UAlberta-EcoCar/ARCHIVED-Fuel-Cell-Controller-2016-2017/README.md

# Fuel-Cell-Controller
Custom controller for a 28 cell Ballard Fuel Cell
