UAlberta-EcoCar/ARCHIVED-Fuel-Cell-Controller-2016-2017/Hardware/Relay Board/Relay Board Parts List Rev2.xlsx

ECOCAR 2016-17 Relay Board Parts List
Part Description | Digikey Number | Size | Quantity
Shunt Resistors | Y1488-.002BTR-ND | N/A | 4
Diode | APT60S20BG-ND | N/A | 1
Connectors | 732-3204-ND | M8 | 8
Current Meter | 296-17936-1-ND | N/A | 2
Resistor - 750 | 311-750ARCT-ND | 805 | 2
Resistor - 9.53K | 311-9.53KCRCT-ND | 805 | 2
Resistor - 470 | 311-470ARCT-ND | 805 | 2
Resistor - 14K | 311-14.0KCRCT-ND | 805 | 1
Resistor - 150K | 311-150KARCT-ND | 805 | 1
Resistor - 100K | 311-100KARCT-ND | 805 | 1
Resistor - 200K | 311-200KARCT-ND | 805 | 1
Resistor - 300K | 311-300KARCT-ND | 805 | 1
Resistor - 10K | 311-10KARCT-ND | 805 | 4
Capacitor - 1microFarad | 311-1365-1-ND | 805 | 2
Op-Amp | 296-21651-2-ND | N/A | 1
RJ-11 Connector | A107789-ND | N/A | 1
Ethernet Connector | A122645-ND | N/A | 2
Relay Socket | PB232-ND | N/A | 4
Diode | F5816CT-ND | N/A | 4
MOSFET | SI6926ADQ-T1-E3CT-ND | N/A | 2
Relay | CLA394-ND | N/A | 1
Relay (70Amp for Alice) | 255-2082-ND | N/A | 4
Relay (40Amp for Proto) | 255-1825-ND | N/A | 4
