UAlberta-EcoCar/ARCHIVED-Fuel-Cell-Controller-2016-2017/Hardware/Hydrogen Board/CE553027-LC.pdf

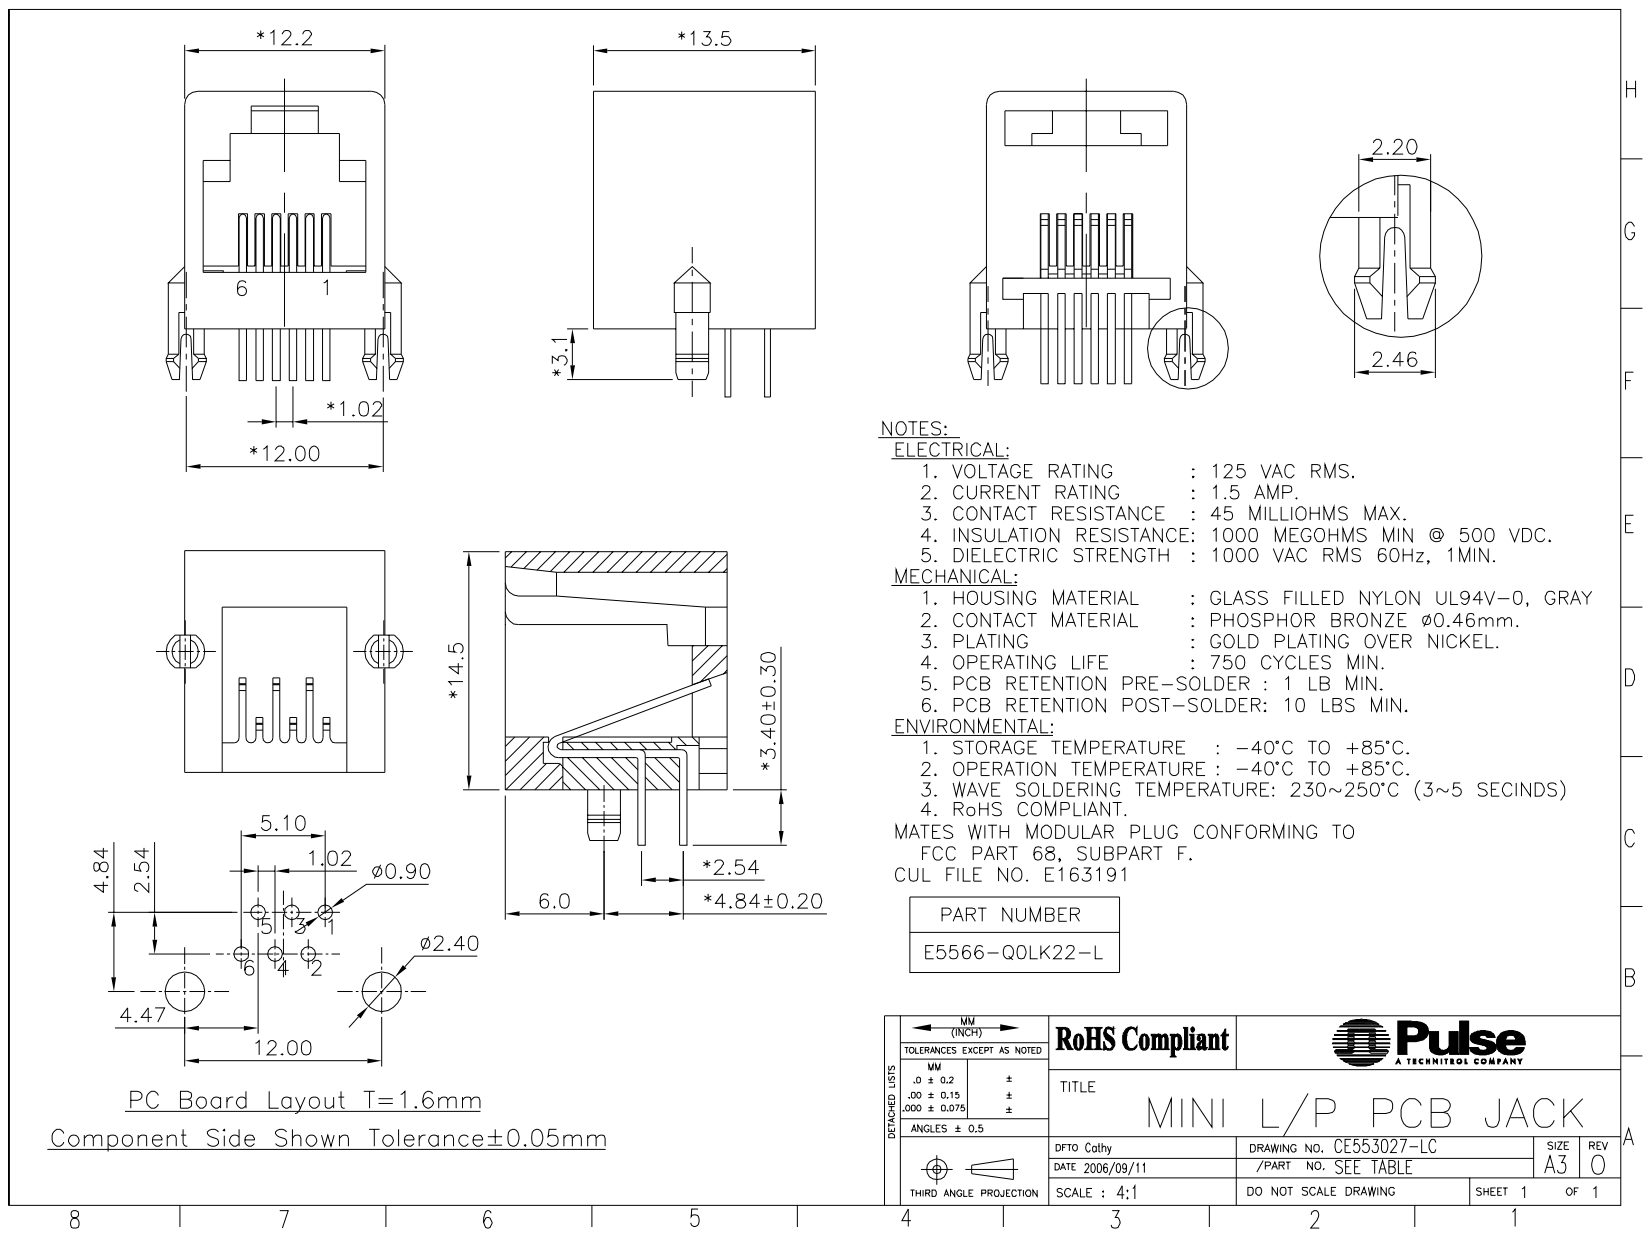
[picture p2: page 1]
