UAlberta-EcoCar/ARCHIVED-Fuel-Cell-Controller-2016-2017/Hardware/FCC Power Board/fc power board v3.brd

## EAGLE design Hardware/FCC Power Board/fc power board v3.brd (2018-02-10)

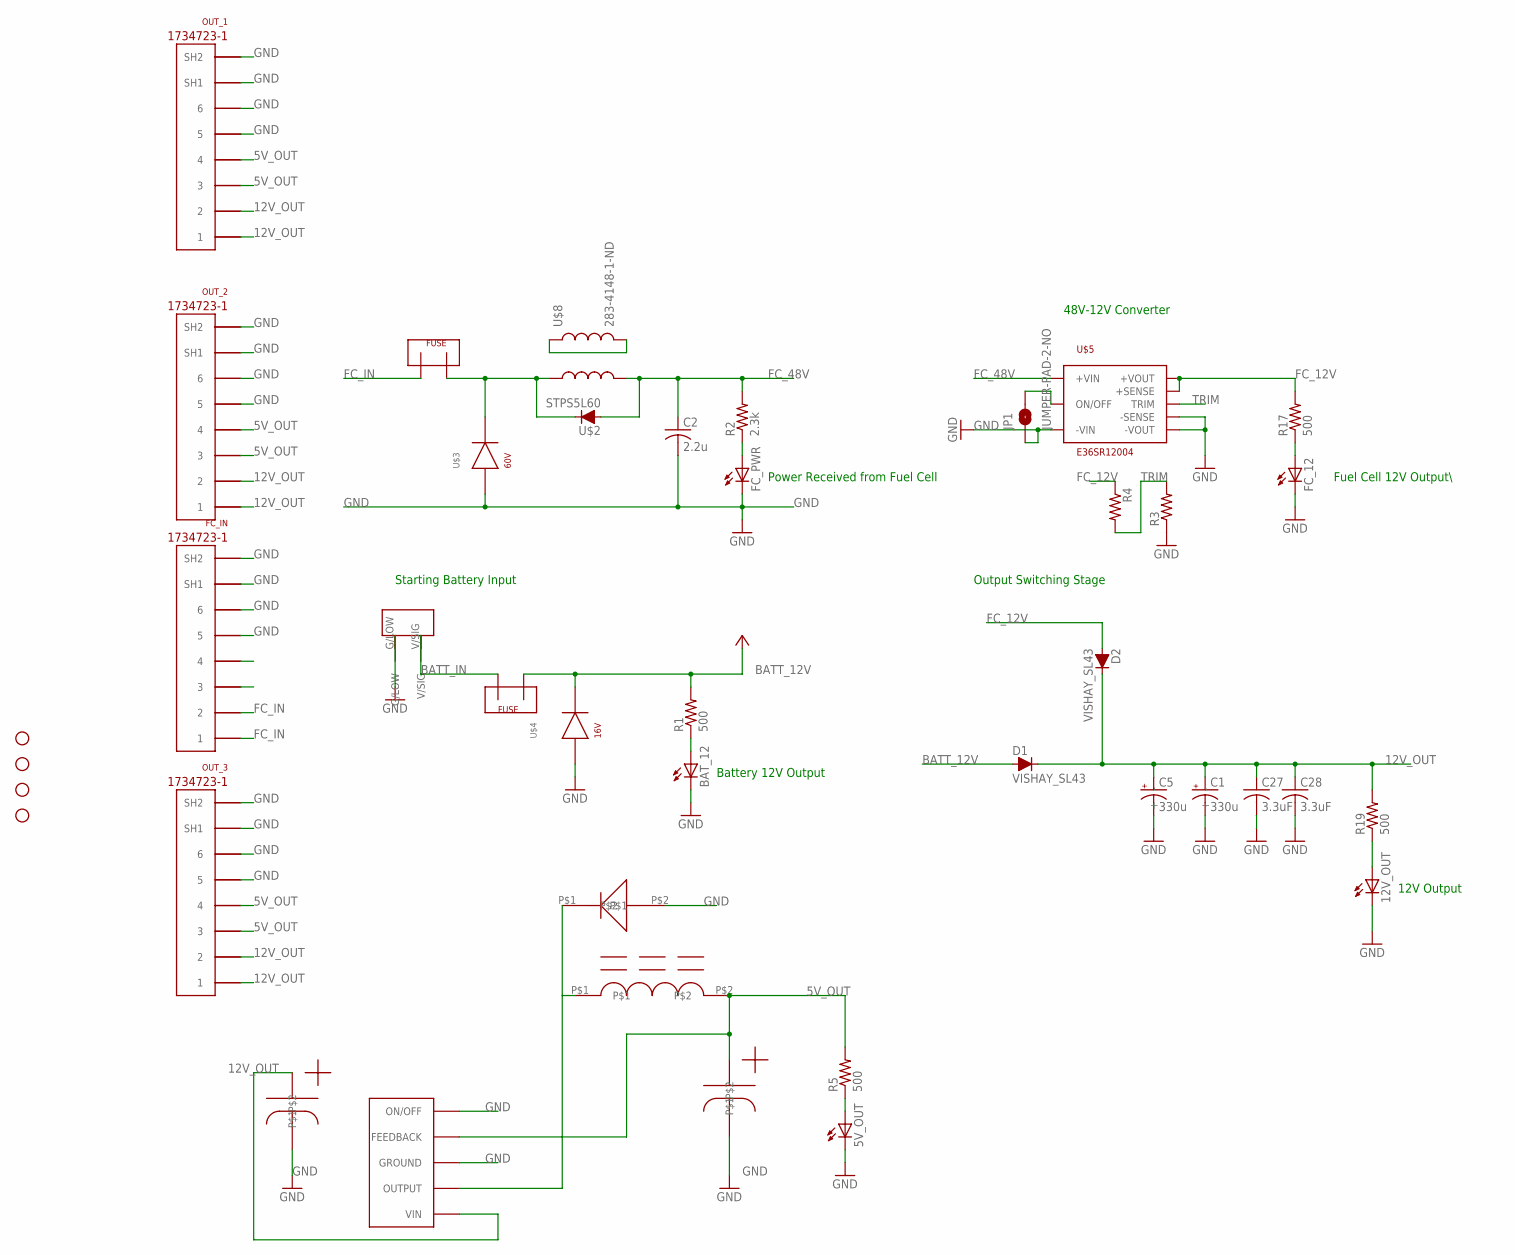
[picture p3: schematic fc power board v3.sch]

Parts:
5V_OUT, 12V_OUT: LED1206; LED-1206
BATTERY_FUSE: FUSEMINI-BLADE; MINI-BLADE-FUSE
BAT_12: LED1206; LED-1206
C1, C5: 330u; 399-6608-ND
C2: 2.2u; C0805
C27, C28: 3.3uF; C0805
D1, D2: VISHAY_SL43; DO-214AB_SMC
FC_12: LED1206; LED-1206
FC_IN: 5555140-6; 1734723-1_RJ11
FC_PWR: LED1206; LED-1206
JP1: JUMPER-PAD-2-NO; PAD-JUMPER-2-NO_NO_SILK
OUT_1, OUT_2, OUT_3: 5555140-6; 1734723-1_RJ11
R1, R5, R17: 500; R0805
R2: 2.3k; R0805
R3, R4: R-US_R0805; R0805
R19: 500; M0805
STANDOFF1, STANDOFF2, STANDOFF3, STANDOFF4: STAND-OFF
U$1: MBR360GOS
U$2: STPS5L60; STM_SMC
U$3: SMBJ60CA; .277X.089
U$4: SMAJ16CA; .25X.07
U$5: E36SR12004; 2.30X0.90X0.34
U$7: FUSEMINI-BLADE; MINI-BLADE-FUSE
U$8: 283-4148-1-ND
U$9: 2_PIN_TECONNECTOR; 2_PIN_CONNECT
U$13: LM2576; D2PAK-5
U$14: CAPESK107M025AC3AA; ESK107M025AC3AA
U$15: CAPESK108M025AH4EA; ESK108M025AH4EA
U$16: M1418-ND

Connections:
5V_OUT: OUT_1.3, OUT_1.4, OUT_2.3, OUT_2.4, OUT_3.3, OUT_3.4, R5.2, U$13.4 (FEEDBACK), U$15.P$1, U$16.P$2
12V_OUT: C1.PLUS (+), C5.PLUS (+), C27.1, C28.1, D1.C, D2.C, OUT_1.1, OUT_1.2, OUT_2.1, OUT_2.2, OUT_3.1, OUT_3.2, R19.2, U$13.1 (VIN), U$14.P$1
BATT_12V: BATTERY_FUSE.OUT, D1.A, R1.2, U$4.CATHODE
BATT_IN: BATTERY_FUSE.IN, U$9.V/SIG
FC_12V: D2.A, R4.1, R17.2, U$5.P$7 (+SENSE), U$5.P$8 (+VOUT)
FC_48V: C2.1, R2.2, U$2.A, U$5.P$1 (+VIN), U$8.P$3 (2)
FC_FUSED: U$2.C, U$3.CATHODE, U$7.IN, U$8.P$1 (1)
FC_IN: FC_IN.1, FC_IN.2, U$7.OUT
GND: 5V_OUT.C, 12V_OUT.C, BAT_12.C, C1.MINUS (-), C2.2, C5.MINUS (-), C27.2, C28.2, FC_12.C, FC_IN.5, FC_IN.6, FC_IN.SH1, FC_IN.SH2, FC_PWR.C, JP1.1, OUT_1.5, OUT_1.6, OUT_1.SH1, OUT_1.SH2, OUT_2.5, OUT_2.6, OUT_2.SH1, OUT_2.SH2, OUT_3.5, OUT_3.6, OUT_3.SH1, OUT_3.SH2, R3.1, U$1.P$2, U$3.ANODE, U$4.ANODE, U$5.P$3 (-VIN), U$5.P$4 (-VOUT), U$5.P$5 (-SENSE), U$9.G/LOW, U$13.3 (GROUND), U$13.5 (ON/OFF), U$13.GROUND, U$14.P$2, U$15.P$2
unnamed: JP1.2, U$5.P$2 (ON/OFF)
unnamed: BAT_12.A, R1.1
unnamed: FC_PWR.A, R2.1
unnamed: U$8.P$2 (3), U$8.P$4 (4)
unnamed: 5V_OUT.A, R5.1
unnamed: U$1.P$1, U$13.2 (OUTPUT), U$16.P$1
unnamed: FC_12.A, R17.1
unnamed: 12V_OUT.A, R19.1
TRIM: R3.2, R4.2, U$5.P$6 (TRIM)

Notes on the sheet:
Output Switching Stage
Starting Battery Input
48V-12V Converter
Power Received from Fuel Cell
Battery 12V Output
Fuel Cell 12V Output\
12V Output

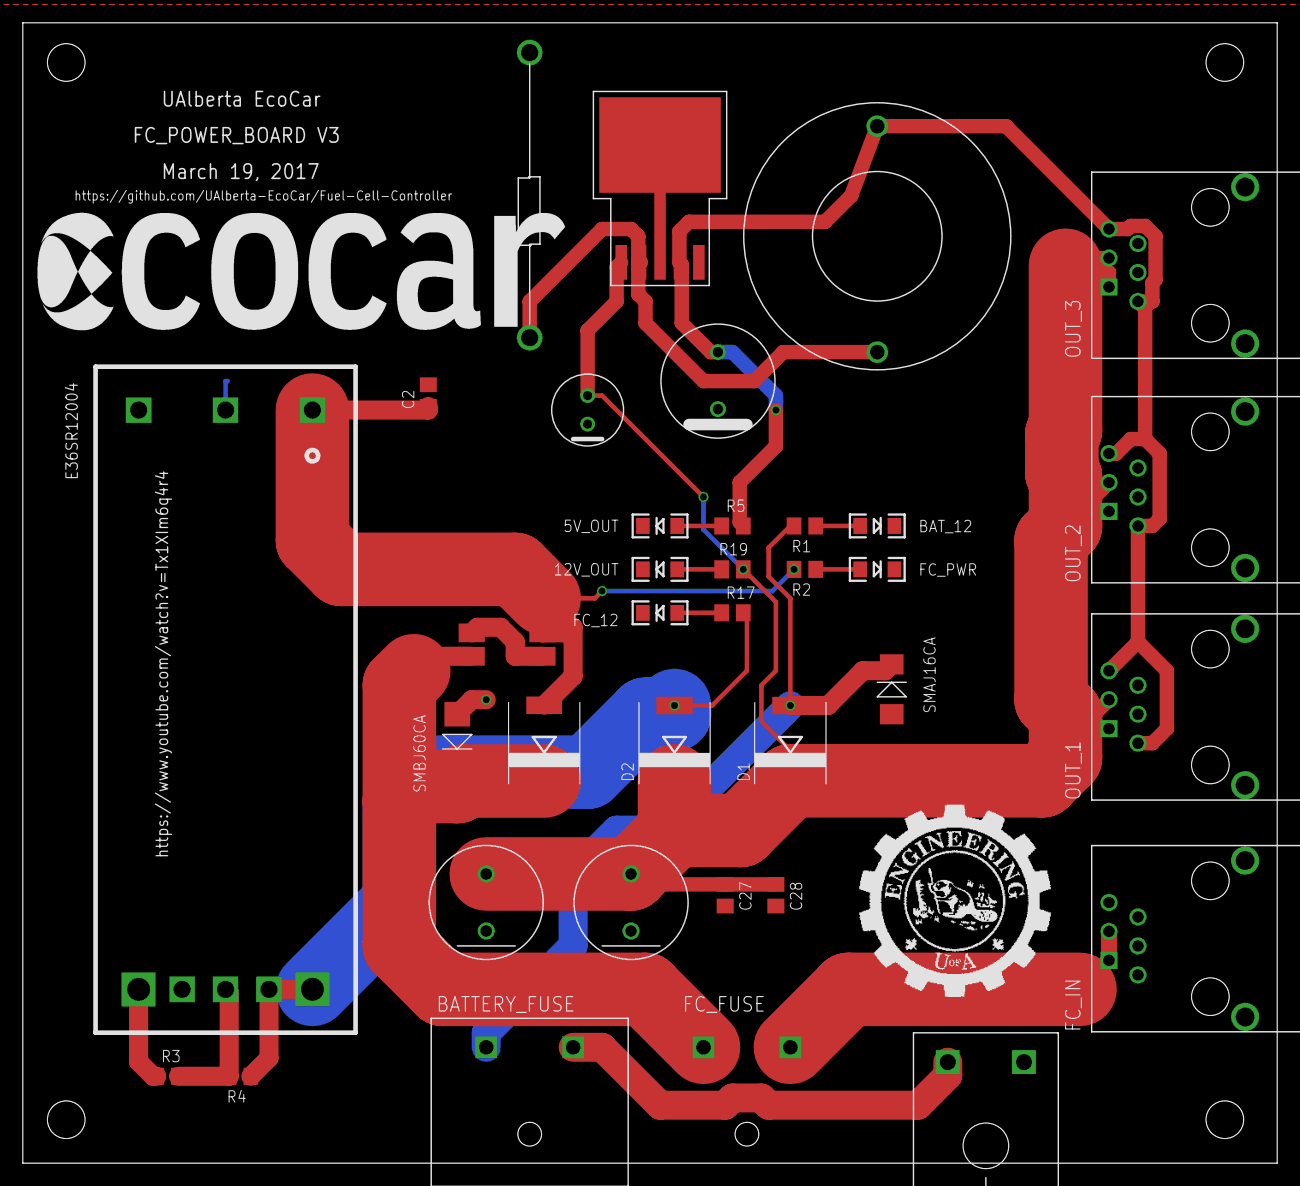
[picture p4: board fc power board v3.brd from above]

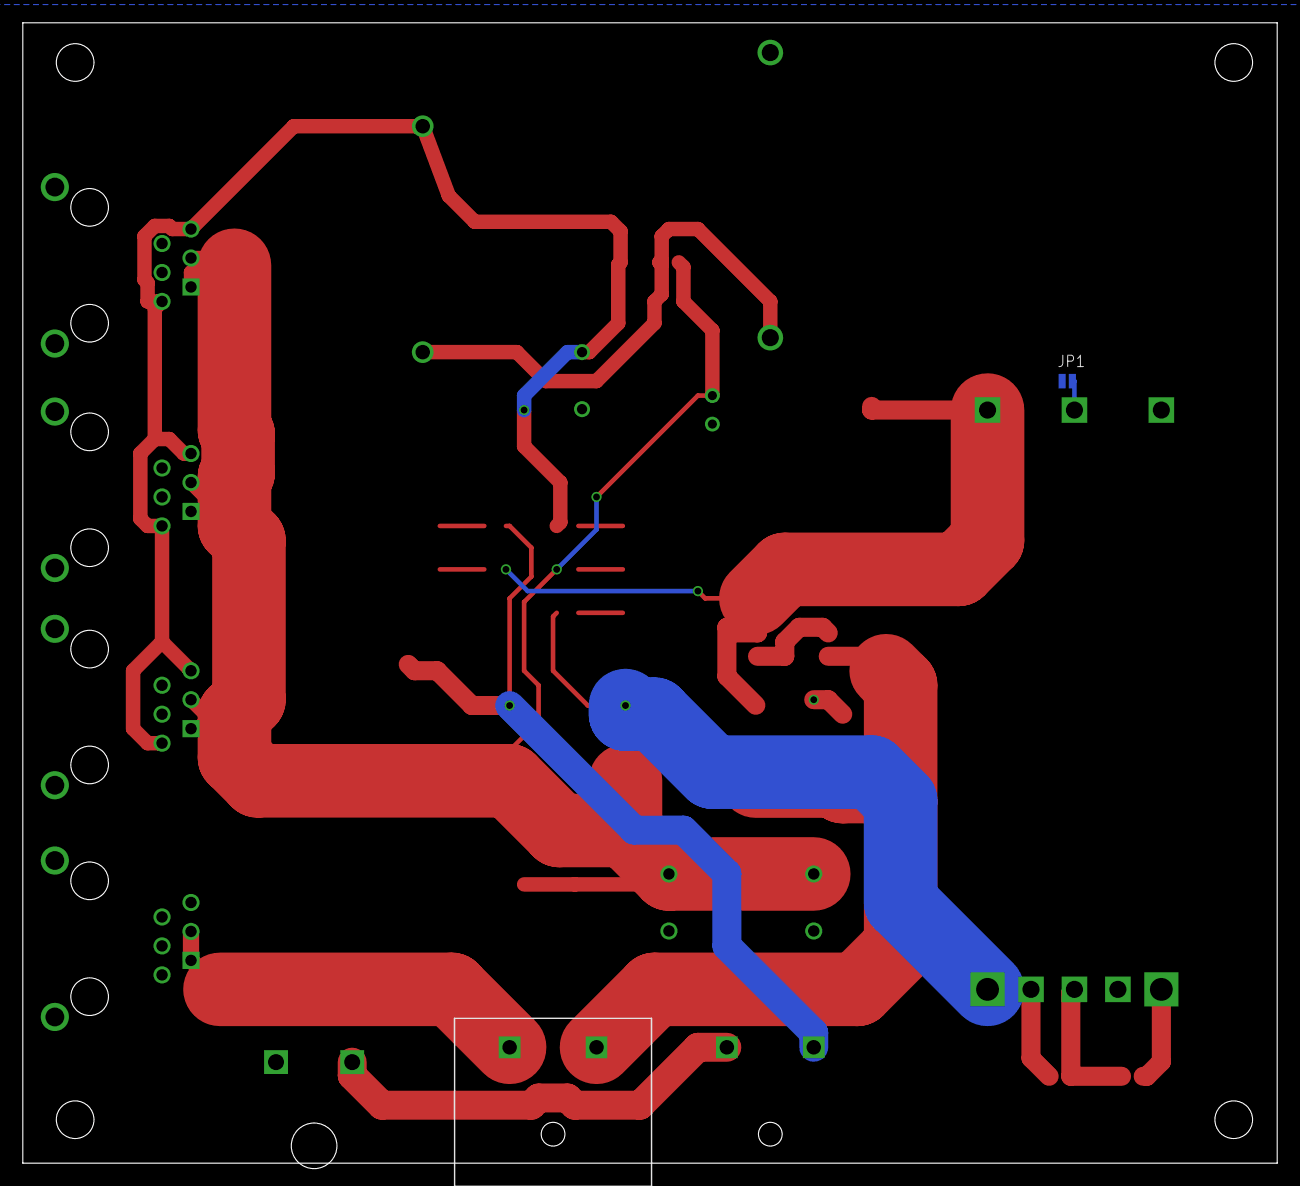
[picture p5: board fc power board v3.brd from below]

Board: 2 copper layers, 110.0 x 100.0 mm, 42 parts (2 on the bottom side), 18 nets.

Other parts of the board:
U$6: ECOCAR_LOGO_2018
