UAlberta-EcoCar/ARCHIVED-Fuel-Cell-Controller-2016-2017/Hardware/Hydrogen Board/hydrogen_sensors_board_v2.brd

## EAGLE design Hardware/Hydrogen Board/hydrogen_sensors_board_v2.brd (2017-10-08)

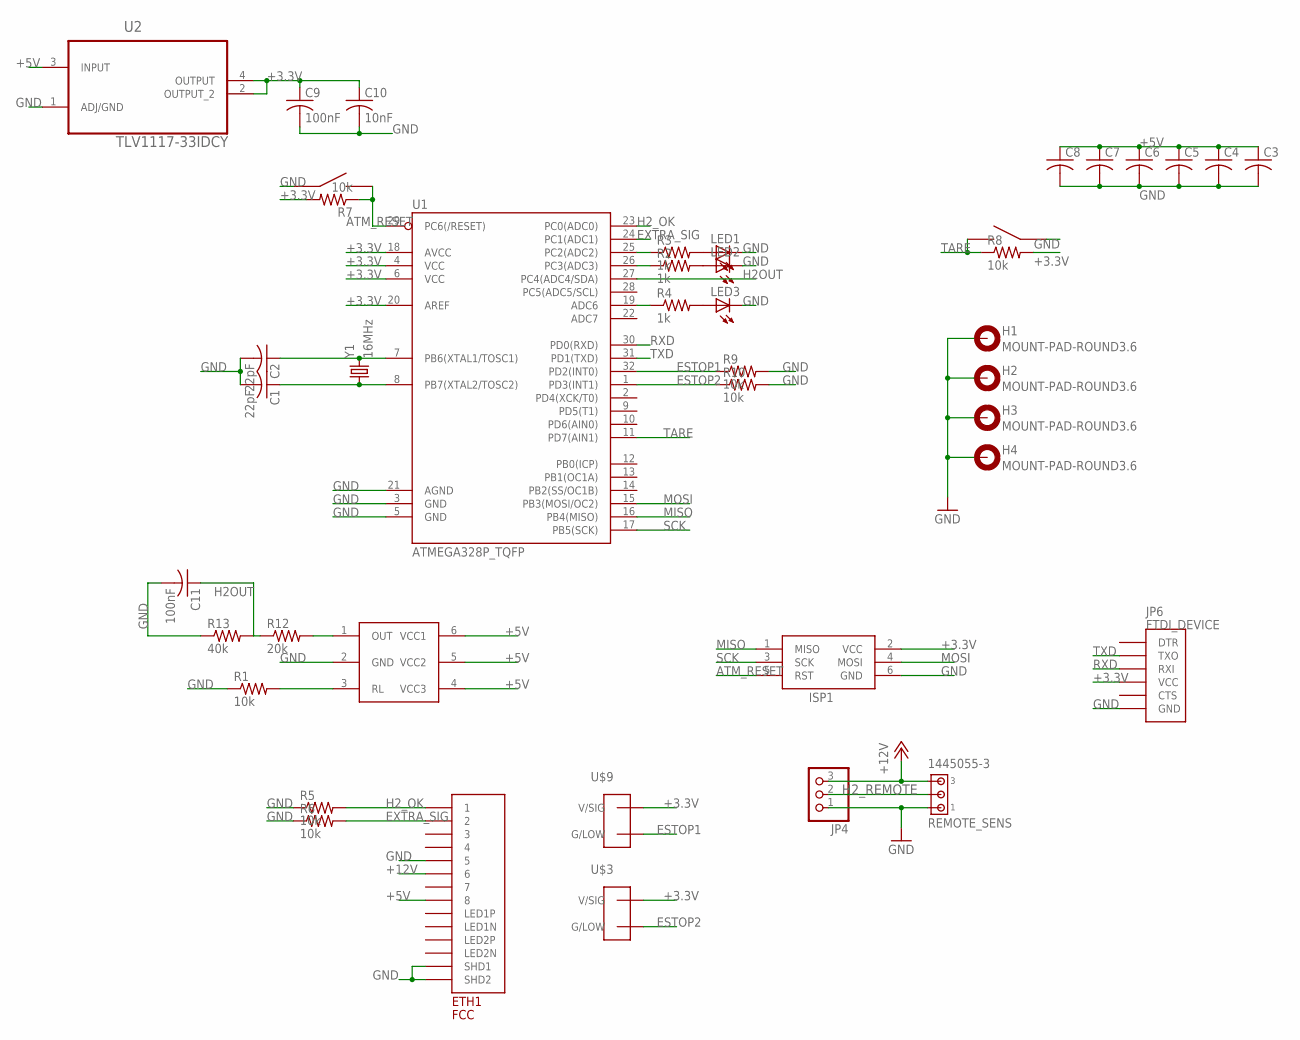
[picture p6: schematic hydrogen_sensors_board_v2.sch]

Parts:
C1, C2: 22pF; C0603K
C3, C4, C5, C6, C7, C8: C-USC0603; C0603
C9, C11: 100nF; C0603
C10: 10nF; C0603
ETH1: FCC; A122645-ND
H1, H2, H3, H4: MOUNT-PAD-ROUND3.6; 3,6-PAD
ISP1: AVRISP-BOX
JP4: PINHD-1X3; 1X03
JP6: FTDI_DEVICE; FTDI_DEVICE_SIDE
LED1, LED2, LED3: LEDCHIPLED_0805; CHIPLED_0805
R1, R5, R6, R7, R8, R9, R10: 10k; 0603-RES
R2, R3, R4: 1k; 0603-RES
R12: 20k; 0603-RES
R13: 40k; 0603-RES
REMOTE_SENS: 1445055-3
U1: ATMEGA328P_TQFP; TQFP32-08
U2: TLV1117-33IDCY; SOT230P700X180-4N
U$1: MQ-8MQ-8; MQ-8
U$2, U$10: EG4621CT-ND
U$3, U$9: TE770966; 2X1-MATE-N-LOCK
Y1: 16MHz; HC49US

Connections:
+3.3V: C9.1, C10.1, ISP1.2 (VCC), JP6.P$4 (VCC), R7.2, R8.2, U1.4 (VCC), U1.6 (VCC), U1.18 (AVCC), U1.20 (AREF), U2.2 (OUTPUT_2), U2.4 (OUTPUT), U$3.CIRCUIT1 (V/SIG), U$9.CIRCUIT1 (V/SIG)
+5V: C3.1, C4.1, C5.1, C6.1, C7.1, C8.1, ETH1.P$8 (8), U2.3 (INPUT), U$1.4 (VCC3), U$1.5 (VCC2), U$1.6 (VCC1)
+12V: ETH1.P$6 (6), JP4.3, REMOTE_SENS.3
ATM_RESET: ISP1.5 (RST), R7.1, U1.29 (PC6(/RESET)), U$10.P$3, U$10.P$4
ESTOP1: R9.1, U1.32 (PD2(INT0)), U$9.CIRCUIT2 (G/LOW)
ESTOP2: R10.1, U1.1 (PD3(INT1)), U$3.CIRCUIT2 (G/LOW)
EXTRA_SIG: ETH1.P$2 (2), R6.2, U1.24 (PC1(ADC1))
GND: C1.2, C2.2, C3.2, C4.2, C5.2, C6.2, C7.2, C8.2, C9.2, C10.2, C11.2, ETH1.P$5 (5), ETH1.P$13 (SHD1), ETH1.P$14 (SHD2), H1.B3,6, H2.B3,6, H3.B3,6, H4.B3,6, ISP1.6 (GND), JP4.1, JP6.P$6 (GND), LED1.C, LED2.C, LED3.C, R1.1, R5.1, R6.1, R9.2, R10.2, R13.1, REMOTE_SENS.1, U1.3 (GND), U1.5 (GND), U1.21 (AGND), U2.1 (ADJ/GND), U$1.2 (GND), U$2.P$1, U$2.P$2, U$10.P$1, U$10.P$2
H2OUT: C11.1, R12.1, R13.2, U1.27 (PC4(ADC4/SDA))
H2_OK: ETH1.P$1 (1), R5.2, U1.23 (PC0(ADC0))
H2_REMOTE: JP4.2, REMOTE_SENS.2
MISO: ISP1.1 (MISO), U1.16 (PB4(MISO))
MOSI: ISP1.4 (MOSI), U1.15 (PB3(MOSI/OC2))
unnamed: C2.1, U1.7 (PB6(XTAL1/TOSC1)), Y1.2
unnamed: R1.2, U$1.3 (RL)
unnamed: C1.1, U1.8 (PB7(XTAL2/TOSC2)), Y1.1
unnamed: R3.1, U1.25 (PC2(ADC2))
unnamed: R2.1, U1.26 (PC3(ADC3))
unnamed: R4.1, U1.19 (ADC6)
unnamed: LED1.A, R3.2
unnamed: LED2.A, R2.2
unnamed: LED3.A, R4.2
unnamed: R12.2, U$1.1 (OUT)
RXD: JP6.P$3 (RXI), U1.30 (PD0(RXD))
SCK: ISP1.3 (SCK), U1.17 (PB5(SCK))
TARE: R8.1, U1.11 (PD7(AIN1)), U$2.P$3, U$2.P$4
TXD: JP6.P$2 (TXO), U1.31 (PD1(TXD))

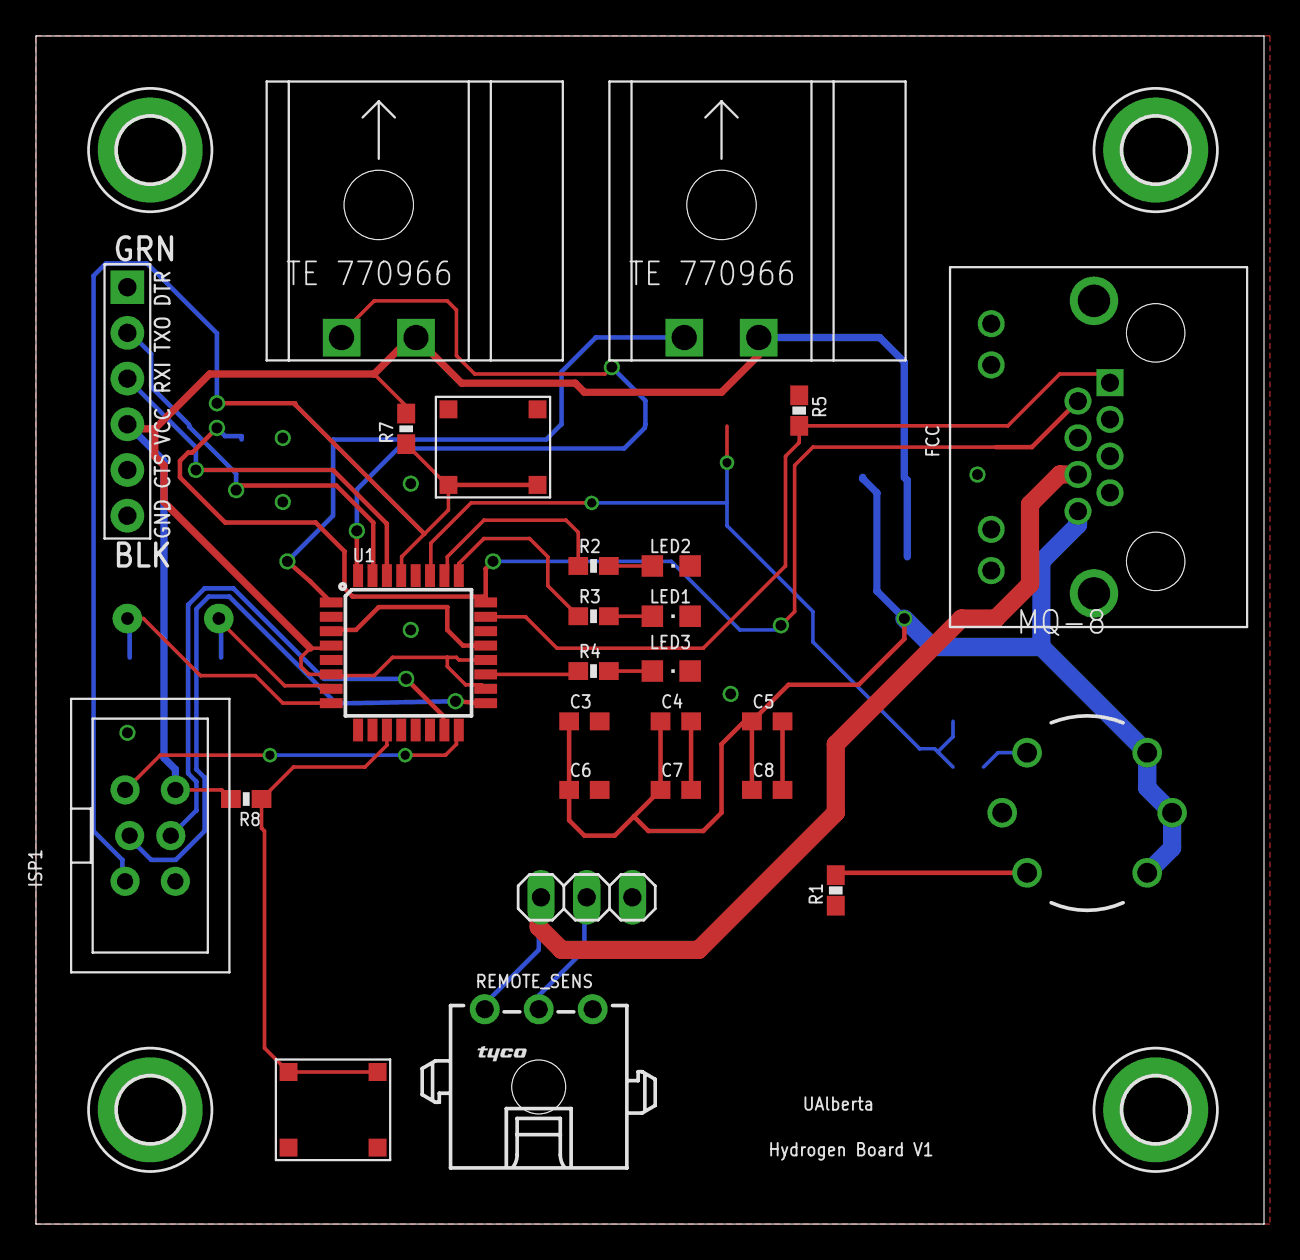
[picture p7: board hydrogen_sensors_board_v2.brd from above]

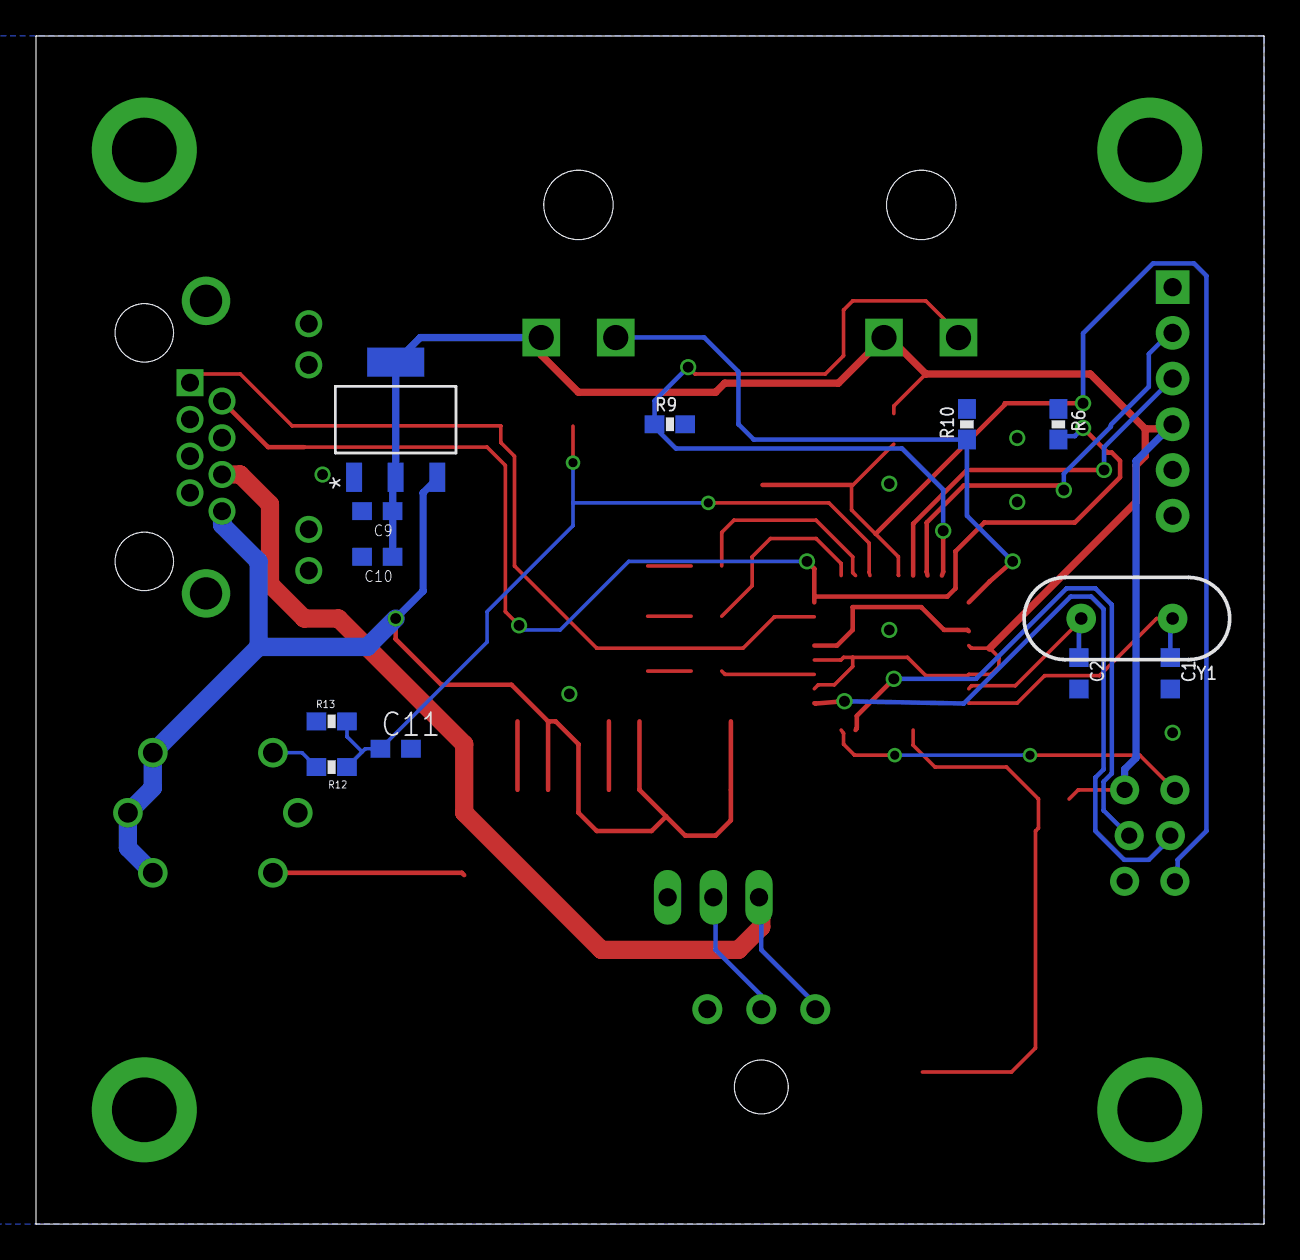
[picture p8: board hydrogen_sensors_board_v2.brd from below]

Board: 2 copper layers, 68.2 x 66.0 mm, 43 parts (12 on the bottom side), 27 nets.
