UAlberta-EcoCar/ARCHIVED-Fuel-Cell-Controller-2016-2017/Hardware/Mosfet Board/mosfet board_v2.brd

## EAGLE design Hardware/Mosfet Board/mosfet board_v2.brd (2017-05-19)

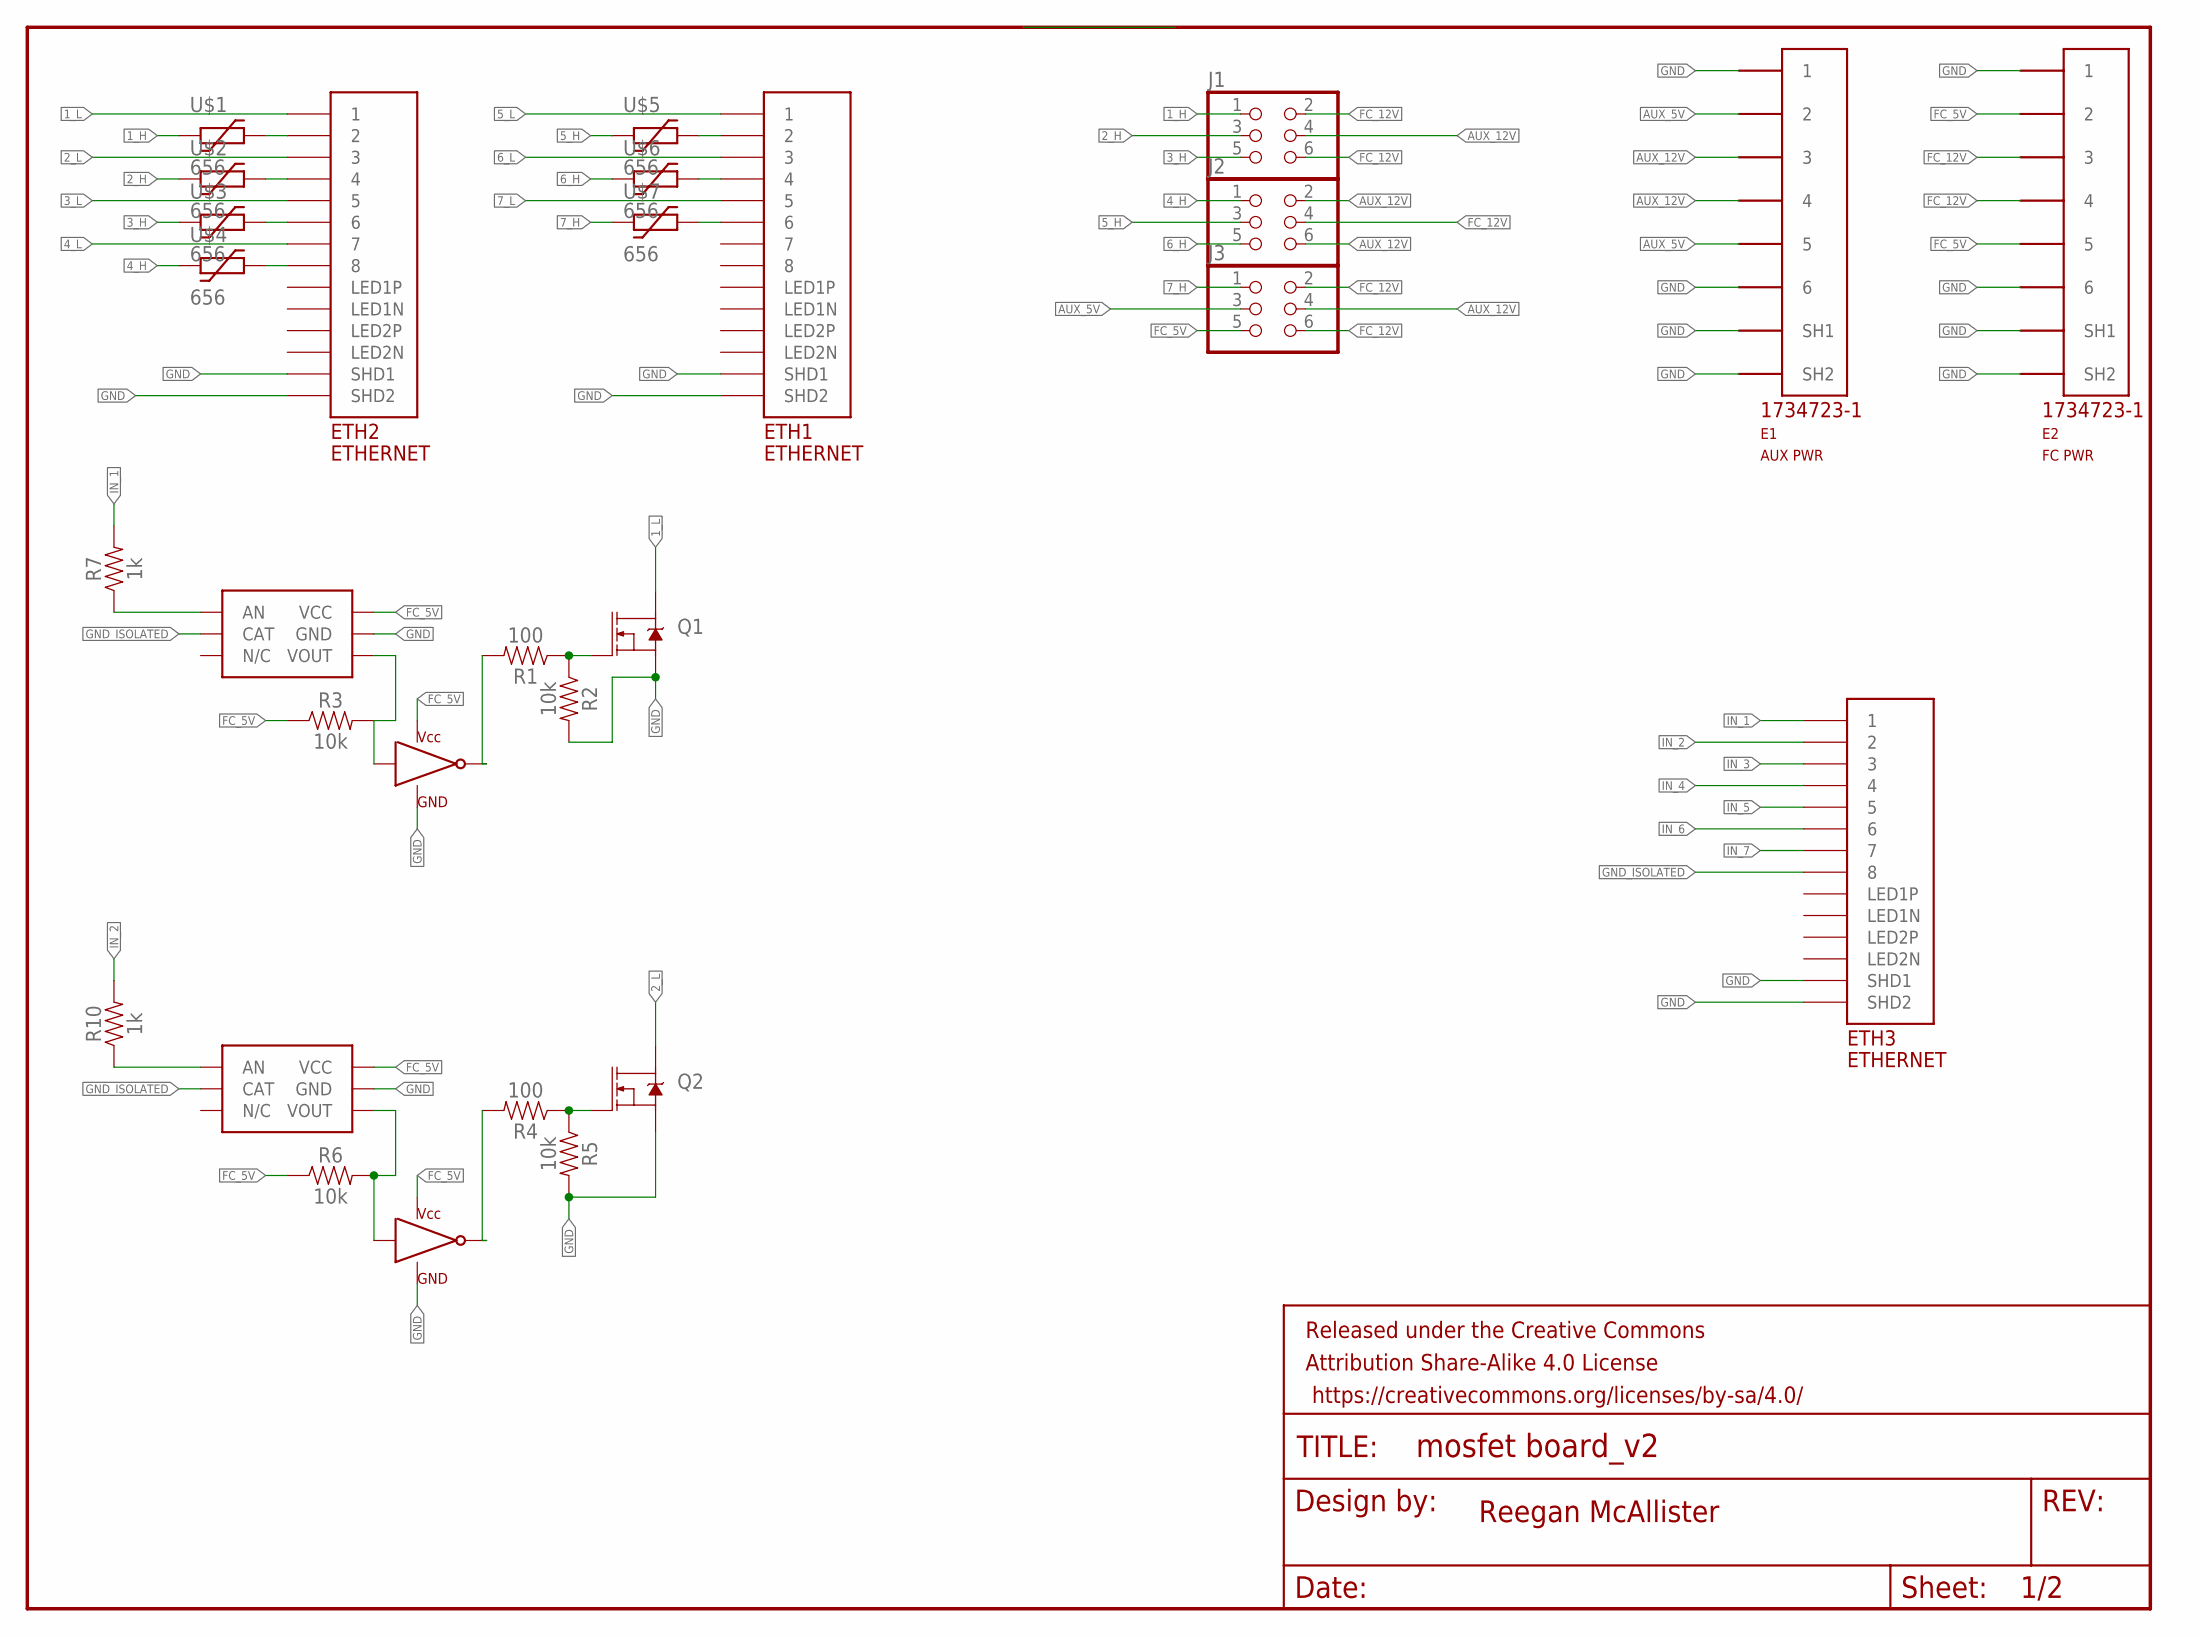
[picture p9: schematic mosfet board_v2.sch, sheet 1]

Parts:
E1: AUX PWR; 1734723-1_RJ11
E2: FC PWR; 1734723-1_RJ11
ETH1, ETH2, ETH3: ETHERNET; A122645-ND
FRAME1: FRAME-LETTERNO_PACKAGE; DUMMY
J1, J2, J3: PINHD-2X3; 2X03
Q1, Q2: MOSFET-NCH-AO3404A; SOT23-3
R1, R4: 100; 0805
R2, R3, R5, R6: 10k; 0805
R7, R10: 1k; 0805
U$1, U$2, U$3, U$4, U$5, U$6, U$7: 656
U$8, U$10: H11L1M
U$9, U$11: SN74LVC1G04-Q1; SOT-23-5

Connections:
1_H: J1.1, U$1.P$1 (1)
1_L: ETH2.P$1 (1), Q1.3 (D)
2_H: J1.3, U$2.P$1 (1)
2_L: ETH2.P$3 (3), Q2.3 (D)
3_H: J1.5, U$3.P$1 (1)
3_L: ETH2.P$5 (5); also elsewhere on the board
4_H: J2.1, U$4.P$1 (1)
4_L: ETH2.P$7 (7); also elsewhere on the board
5_H: J2.3, U$5.P$1 (1)
5_L: ETH1.P$1 (1); also elsewhere on the board
6_H: J2.5, U$6.P$1 (1)
6_L: ETH1.P$3 (3); also elsewhere on the board
7_H: J3.1, U$7.P$1 (1)
7_L: ETH1.P$5 (5); also elsewhere on the board
AUX_5V: E1.2, E1.5, J3.3
AUX_12V: E1.3, E1.4, J1.4, J2.2, J2.6, J3.4
FC_5V: E2.2, E2.5, J3.5, R3.1, R6.1, U$8.P$6 (VCC), U$9.P$5 (VCC), U$10.P$6 (VCC), U$11.P$5 (VCC); also elsewhere on the board
FC_12V: E2.3, E2.4, J1.2, J1.6, J2.4, J3.2, J3.6
GND: E1.1, E1.6, E1.SH1, E1.SH2, E2.1, E2.6, E2.SH1, E2.SH2, ETH1.P$13 (SHD1), ETH1.P$14 (SHD2), ETH2.P$13 (SHD1), ETH2.P$14 (SHD2), ETH3.P$13 (SHD1), ETH3.P$14 (SHD2), Q1.2 (S), Q2.2 (S), R2.2, R5.2, U$8.P$5 (GND), U$9.P$1 (GND), U$9.P$3 (GND), U$10.P$5 (GND), U$11.P$1 (GND), U$11.P$3 (GND); also elsewhere on the board
GND_ISOLATED: ETH3.P$8 (8), U$8.P$2 (CAT), U$10.P$2 (CAT); also elsewhere on the board
IN_1: ETH3.P$1 (1), R7.2
IN_2: ETH3.P$2 (2), R10.2
IN_3: ETH3.P$3 (3); also elsewhere on the board
IN_4: ETH3.P$4 (4); also elsewhere on the board
IN_5: ETH3.P$5 (5); also elsewhere on the board
IN_6: ETH3.P$6 (6); also elsewhere on the board
IN_7: ETH3.P$7 (7); also elsewhere on the board
unnamed: ETH2.P$2 (2), U$1.P$2 (2)
unnamed: ETH2.P$4 (4), U$2.P$2 (2)
unnamed: ETH2.P$6 (6), U$3.P$2 (2)
unnamed: ETH2.P$8 (8), U$4.P$2 (2)
unnamed: ETH1.P$2 (2), U$5.P$2 (2)
unnamed: Q1.1 (G), R1.1, R2.1
unnamed: R3.2, U$8.P$4 (VOUT), U$9.P$2 (IN)
unnamed: R1.2, U$9.P$4 (OUT)
unnamed: ETH1.P$6 (6), U$7.P$2 (2)
unnamed: ETH1.P$4 (4), U$6.P$2 (2)
unnamed: Q2.1 (G), R4.1, R5.1
unnamed: R6.2, U$10.P$4 (VOUT), U$11.P$2 (IN)
unnamed: R4.2, U$11.P$4 (OUT)
unnamed: R10.1, U$10.P$1 (AN)
unnamed: R7.1, U$8.P$1 (AN)

Notes on the sheet:
Reegan McAllister

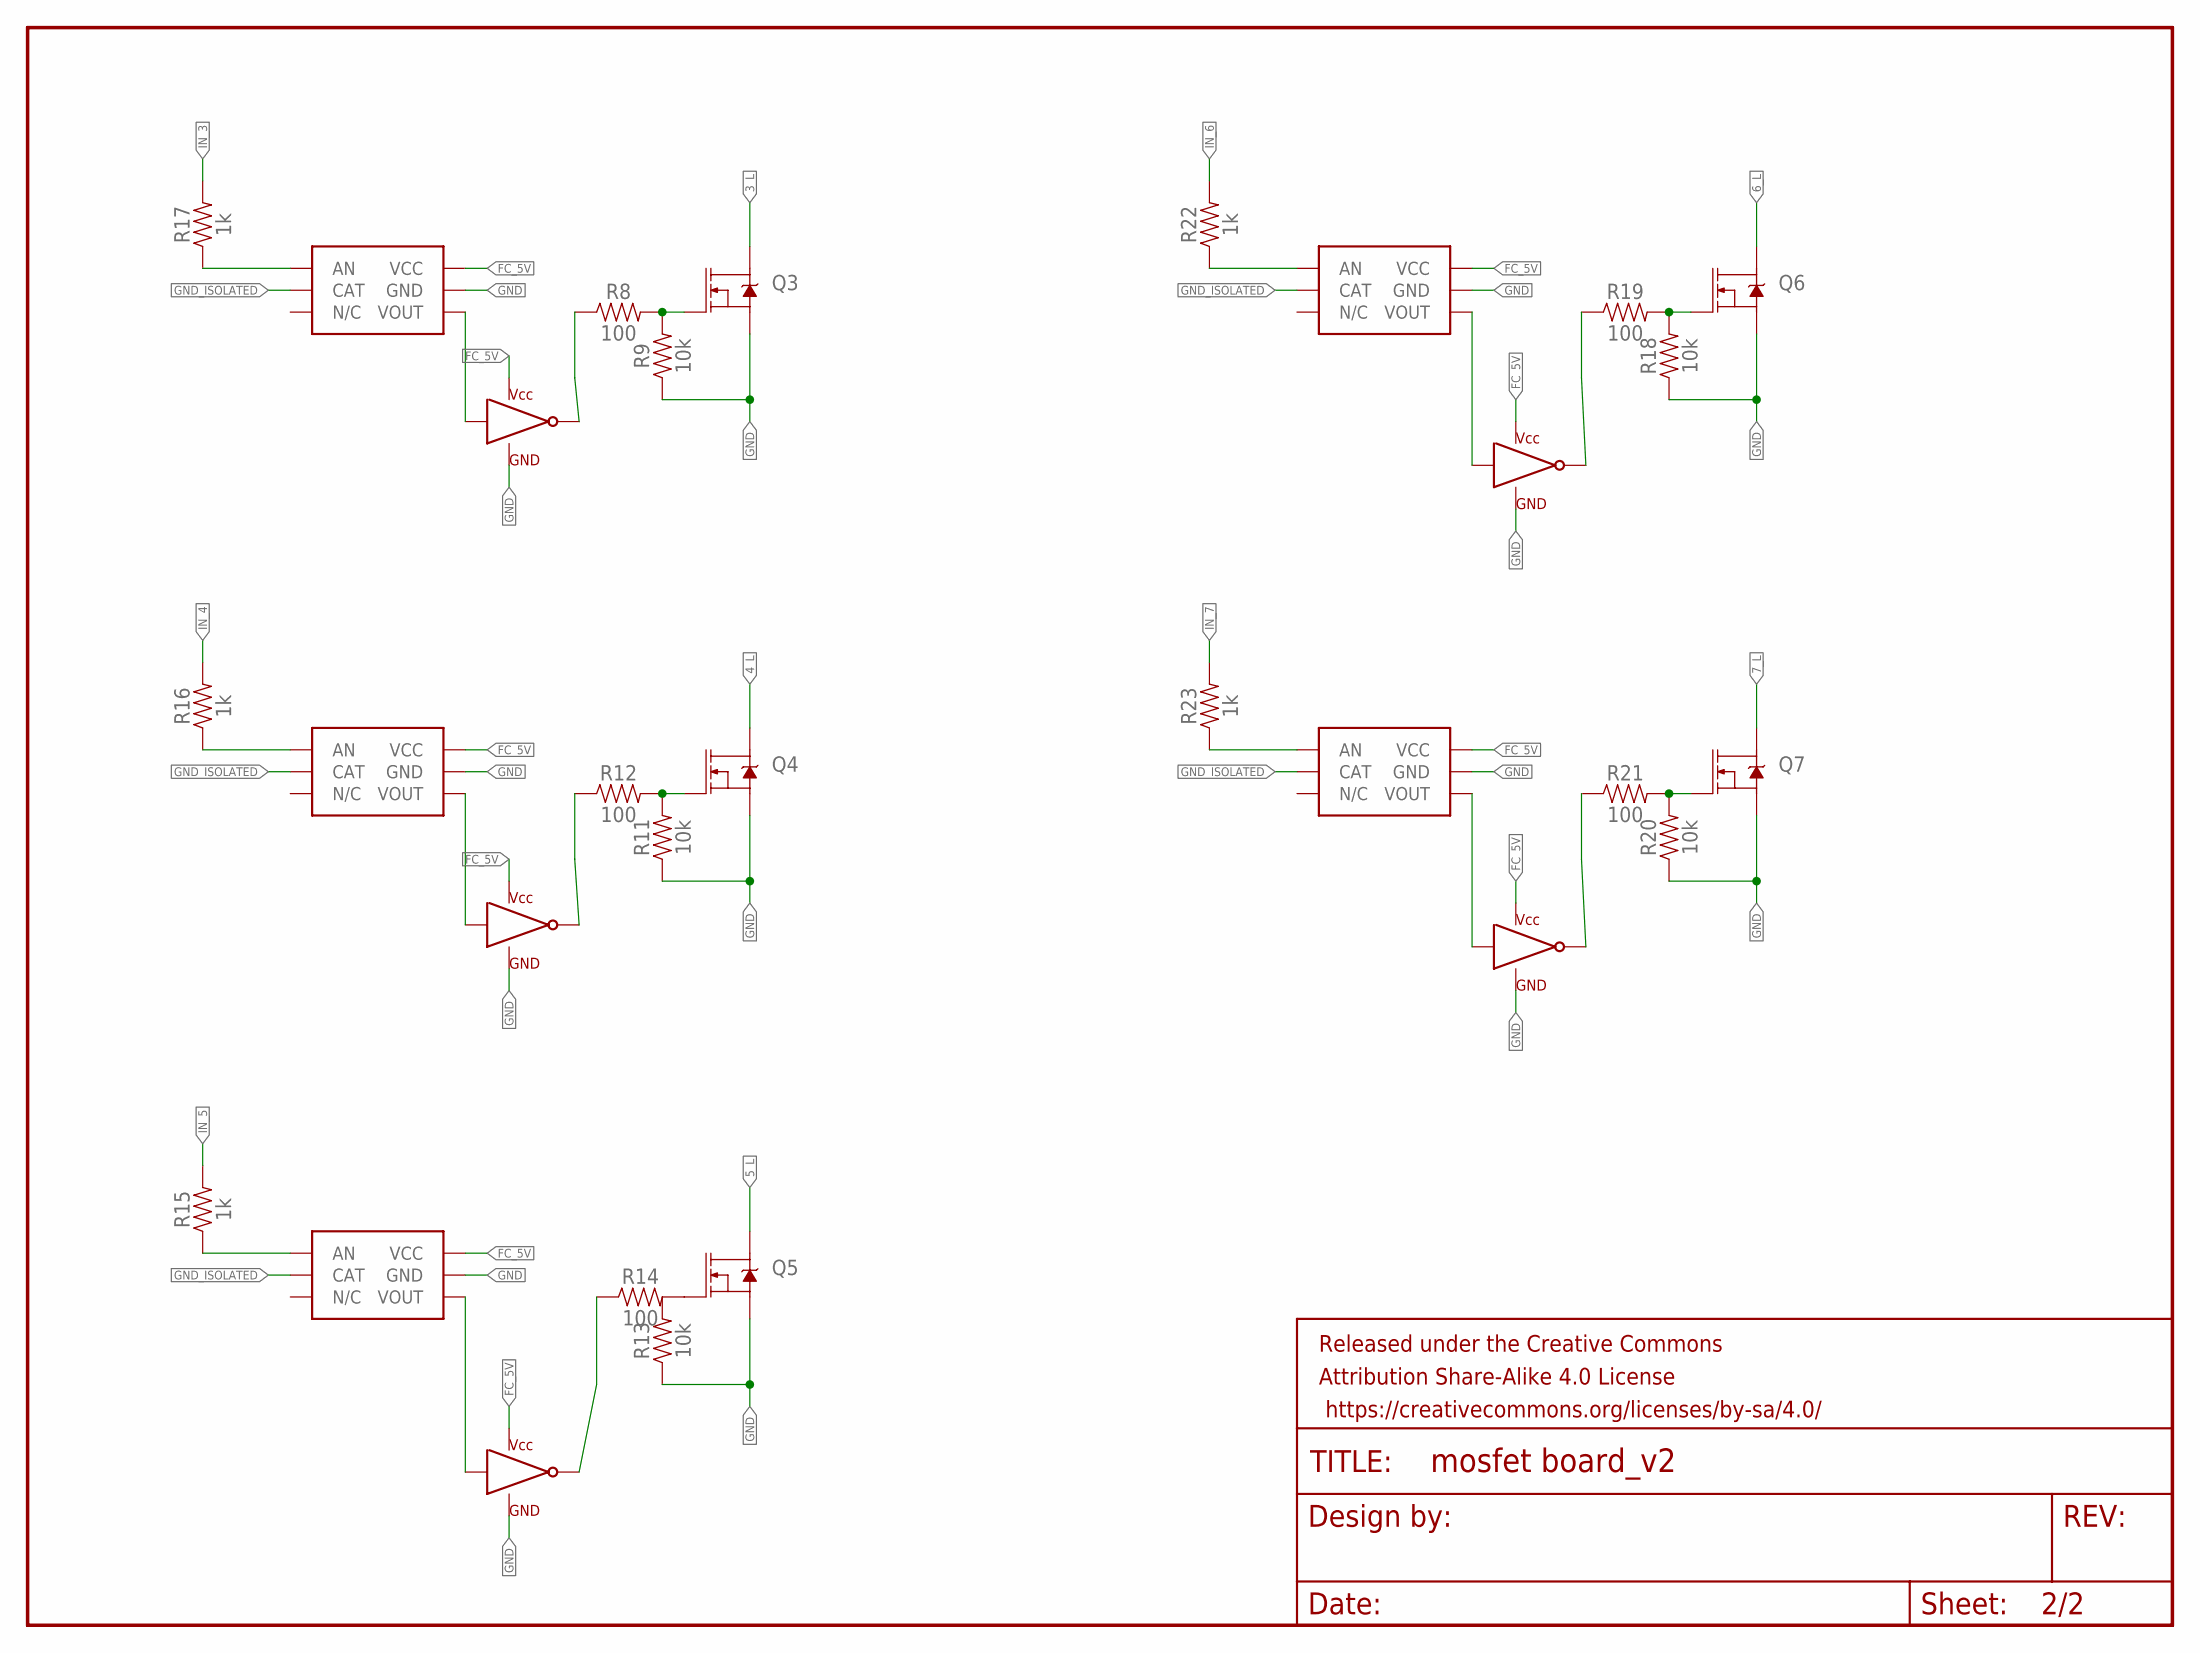
[picture p10: schematic mosfet board_v2.sch, sheet 2]

Parts:
FRAME2: FRAME-LETTERNO_PACKAGE; DUMMY
Q3, Q4, Q5, Q6, Q7: MOSFET-NCH-AO3404A; SOT23-3
R8, R12, R14, R19, R21: 100; 0805
R9, R11, R13, R18, R20: 10k; 0805
R15, R16, R17, R22, R23: 1k; 0805
U$12, U$14, U$16, U$18, U$20: H11L1M
U$13, U$15, U$17, U$19, U$21: SN74LVC1G04-Q1; SOT-23-5

Connections:
3_L: Q3.3 (D); also elsewhere on the board
4_L: Q4.3 (D); also elsewhere on the board
5_L: Q5.3 (D); also elsewhere on the board
6_L: Q6.3 (D); also elsewhere on the board
7_L: Q7.3 (D); also elsewhere on the board
FC_5V: U$12.P$6 (VCC), U$13.P$5 (VCC), U$14.P$6 (VCC), U$15.P$5 (VCC), U$16.P$6 (VCC), U$17.P$5 (VCC), U$18.P$6 (VCC), U$19.P$5 (VCC), U$20.P$6 (VCC), U$21.P$5 (VCC); also elsewhere on the board
GND: Q3.2 (S), Q4.2 (S), Q5.2 (S), Q6.2 (S), Q7.2 (S), R9.1, R11.1, R13.1, R18.1, R20.1, U$12.P$5 (GND), U$13.P$1 (GND), U$13.P$3 (GND), U$14.P$5 (GND), U$15.P$1 (GND), U$15.P$3 (GND), U$16.P$5 (GND), U$17.P$1 (GND), U$17.P$3 (GND), U$18.P$5 (GND), U$19.P$1 (GND), U$19.P$3 (GND), U$20.P$5 (GND), U$21.P$1 (GND), U$21.P$3 (GND); also elsewhere on the board
GND_ISOLATED: U$12.P$2 (CAT), U$14.P$2 (CAT), U$16.P$2 (CAT), U$18.P$2 (CAT), U$20.P$2 (CAT); also elsewhere on the board
IN_3: R17.2; also elsewhere on the board
IN_4: R16.2; also elsewhere on the board
IN_5: R15.2; also elsewhere on the board
IN_6: R22.2; also elsewhere on the board
IN_7: R23.2; also elsewhere on the board
unnamed: Q3.1 (G), R8.2, R9.2
unnamed: Q4.1 (G), R11.2, R12.2
unnamed: Q5.1 (G), R14.2
unnamed: Q6.1 (G), R18.2, R19.2
unnamed: Q7.1 (G), R20.2, R21.2
unnamed: R17.1, U$12.P$1 (AN)
unnamed: R16.1, U$14.P$1 (AN)
unnamed: R15.1, U$16.P$1 (AN)
unnamed: R22.1, U$18.P$1 (AN)
unnamed: R23.1, U$20.P$1 (AN)
unnamed: U$12.P$4 (VOUT), U$13.P$2 (IN)
unnamed: R8.1, U$13.P$4 (OUT)
unnamed: U$16.P$4 (VOUT), U$17.P$2 (IN)
unnamed: R14.1, U$17.P$4 (OUT)
unnamed: U$14.P$4 (VOUT), U$15.P$2 (IN)
unnamed: R12.1, U$15.P$4 (OUT)
unnamed: U$20.P$4 (VOUT), U$21.P$2 (IN)
unnamed: R21.1, U$21.P$4 (OUT)
unnamed: U$18.P$4 (VOUT), U$19.P$2 (IN)
unnamed: R19.1, U$19.P$4 (OUT)

Board: 2 copper layers, 61 parts (0 on the bottom side), 62 nets, no tracks yet.
