UAlberta-EcoCar/ARCHIVED-Fuel-Cell-Controller-2016-2017/Hardware/Controller/Fuel Cell Controller V2.brd

## EAGLE design Hardware/Controller/Fuel Cell Controller V2.brd (2017-04-21)

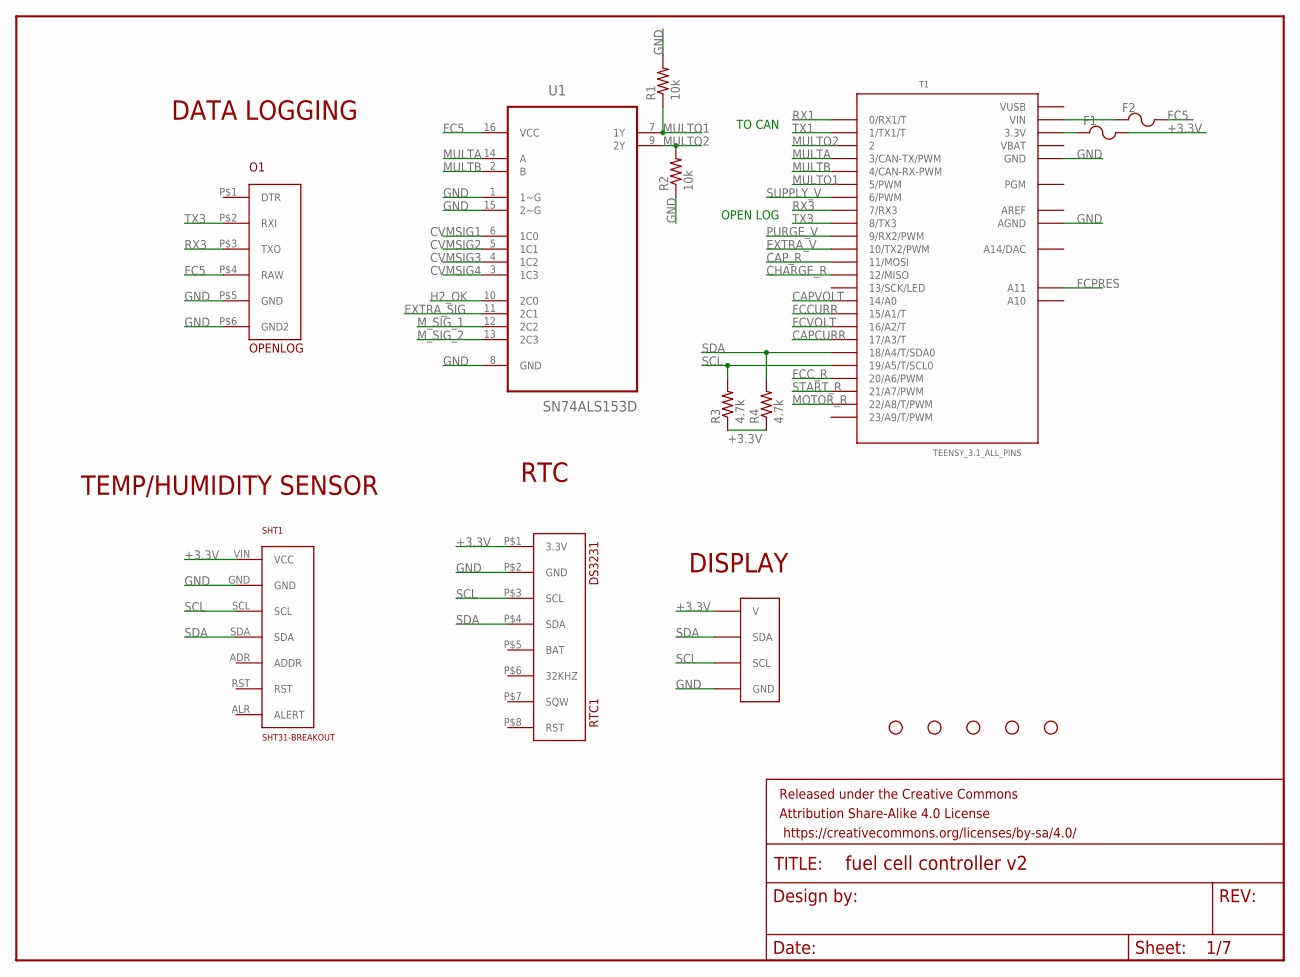
[picture p11: schematic Fuel Cell Controller V2.sch, sheet 1]

Parts:
F1, F2: POLYFUSE; 1206
FRAME1: FRAME-LETTERNO_PACKAGE; DUMMY
LCD1: LCD-BOARD
O1: OPENLOG
R1, R2: 10k; 0805
R3, R4: 4.7k; 0805
RTC1: DS3231
SHT1: SHT31-BREAKOUT
STANDOFF1, STANDOFF2, STANDOFF3, STANDOFF4, STANDOFF5: STAND-OFF
T1: TEENSY_3.1_ALL_PINS; TEENSY3-ALL_PINS
U1: SN74ALS153D; SOIC127P600X175-16N

Connections:
+3.3V: F1.2, LCD1.V, R3.1, R4.1, RTC1.P$1 (3.3V), SHT1.VIN (VCC); also elsewhere on the board
AREF: T1.AREF
CAPCURR: T1.17/A3 (17/A3/T); also elsewhere on the board
CAPVOLT: T1.14/A0; also elsewhere on the board
CAP_R: T1.11 (11/MOSI); also elsewhere on the board
CHARGE_R: T1.12 (12/MISO); also elsewhere on the board
CVMSIG1: U1.6 (1C0); also elsewhere on the board
CVMSIG2: U1.5 (1C1); also elsewhere on the board
CVMSIG3: U1.4 (1C2); also elsewhere on the board
CVMSIG4: U1.3 (1C3); also elsewhere on the board
EXTRA_SIG: U1.11 (2C1); also elsewhere on the board
EXTRA_V: T1.10 (10/TX2/PWM); also elsewhere on the board
FC5: F2.2, O1.P$4 (RAW), U1.16 (VCC); also elsewhere on the board
FCCURR: T1.15/A1 (15/A1/T); also elsewhere on the board
FCC_R: T1.20/A6 (20/A6/PWM); also elsewhere on the board
FCPRES: T1.A11; also elsewhere on the board
FCVOLT: T1.16/A2 (16/A2/T); also elsewhere on the board
GND: LCD1.GND1 (GND), LCD1.GND2 (GND), LCD1.GND3 (GND), LCD1.GND4 (GND), LCD1.GND5 (GND), LCD1.GND6 (GND), LCD1.GND7 (GND), LCD1.GND8 (GND), LCD1.GND9 (GND), LCD1.GND10 (GND), LCD1.GND11 (GND), LCD1.GND12 (GND), LCD1.GND13 (GND), O1.P$5 (GND), O1.P$6 (GND2), R1.2, R2.1, RTC1.P$2 (GND), SHT1.GND, T1.AGND, T1.GND, T1.GND1 (GND), U1.1 (1~G), U1.8 (GND), U1.15 (2~G); also elsewhere on the board
H2_OK: U1.10 (2C0); also elsewhere on the board
MOTOR_R: T1.22/A8 (22/A8/T/PWM); also elsewhere on the board
MULTA: T1.3 (3/CAN-TX/PWM), U1.14 (A)
MULTB: T1.4 (4/CAN-RX-PWM), U1.2 (B)
MULTO1: R1.1, T1.5 (5/PWM), U1.7 (1Y)
MULTO2: R2.2, T1.2, U1.9 (2Y)
M_SIG_1: U1.12 (2C2); also elsewhere on the board
M_SIG_2: U1.13 (2C3); also elsewhere on the board
unnamed: F2.1, T1.VIN
unnamed: F1.1, T1.3.3V, T1.3.3V1 (3.3V)
PURGE_V: T1.9 (9/RX2/PWM); also elsewhere on the board
RX1: T1.0 (0/RX1/T); also elsewhere on the board
RX3: O1.P$3 (TXO), T1.7 (7/RX3)
SCL: LCD1.SCL, R3.2, RTC1.P$3 (SCL), SHT1.SCL, T1.19/A5 (19/A5/T/SCL0); also elsewhere on the board
SDA: LCD1.SDA, R4.2, RTC1.P$4 (SDA), SHT1.SDA, T1.18/A4 (18/A4/T/SDA0); also elsewhere on the board
START_R: T1.21/A7 (21/A7/PWM); also elsewhere on the board
SUPPLY_V: T1.6 (6/PWM); also elsewhere on the board
TX1: T1.1 (1/TX1/T); also elsewhere on the board
TX3: O1.P$2 (RXI), T1.8 (8/TX3)
VBAT: T1.VBAT
VUSB: T1.VUSB

Notes on the sheet:
TO CAN
OPEN LOG
DISPLAY
DATA LOGGING
TEMP/HUMIDITY SENSOR
RTC

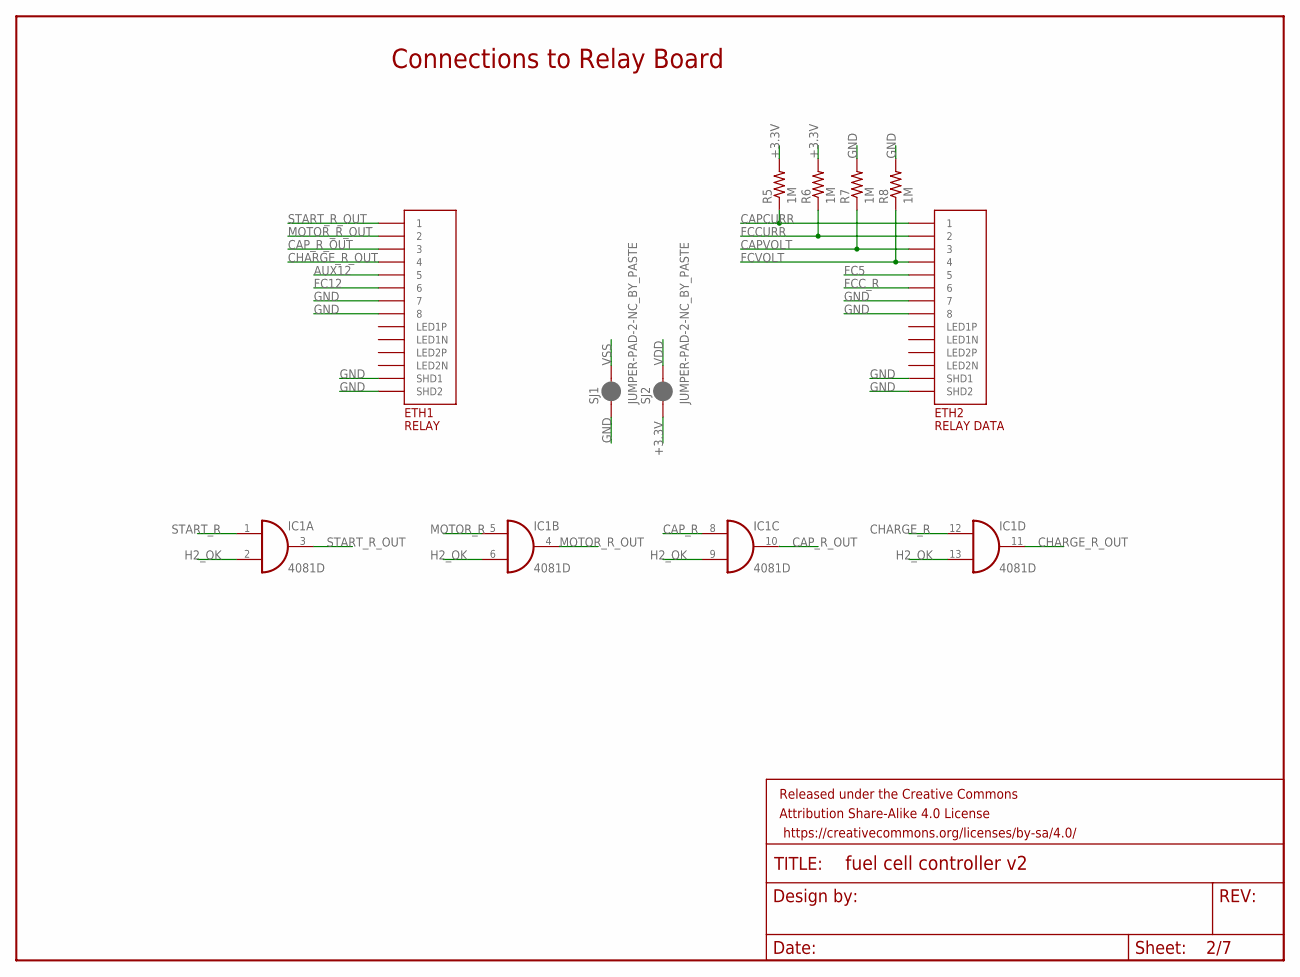
[picture p12: schematic Fuel Cell Controller V2.sch, sheet 2]

Parts:
ETH1: RELAY; A122645-ND
ETH2: RELAY DATA; A122645-ND
FRAME2: FRAME-LETTERNO_PACKAGE; DUMMY
IC1: 4081D; SO14
R5, R6, R7, R8: 1M; 0805
SJ1, SJ2: JUMPER-PAD-2-NC_BY_PASTE; PAD-JUMPER-2-NC_BY_PASTE_YES_SILK

Connections:
+3.3V: R5.2, R6.2, SJ2.1; also elsewhere on the board
AUX12: ETH1.P$5 (5); also elsewhere on the board
CAPCURR: ETH2.P$1 (1), R5.1; also elsewhere on the board
CAPVOLT: ETH2.P$3 (3), R7.1; also elsewhere on the board
CAP_R: IC1.8 (I0); also elsewhere on the board
CAP_R_OUT: ETH1.P$3 (3), IC1.10 (O)
CHARGE_R: IC1.12 (I0); also elsewhere on the board
CHARGE_R_OUT: ETH1.P$4 (4), IC1.11 (O)
FC5: ETH2.P$5 (5); also elsewhere on the board
FC12: ETH1.P$6 (6); also elsewhere on the board
FCCURR: ETH2.P$2 (2), R6.1; also elsewhere on the board
FCC_R: ETH2.P$6 (6); also elsewhere on the board
FCVOLT: ETH2.P$4 (4), R8.1; also elsewhere on the board
GND: ETH1.P$7 (7), ETH1.P$8 (8), ETH1.P$13 (SHD1), ETH1.P$14 (SHD2), ETH2.P$7 (7), ETH2.P$8 (8), ETH2.P$13 (SHD1), ETH2.P$14 (SHD2), R7.2, R8.2, SJ1.1; also elsewhere on the board
H2_OK: IC1.2 (I1), IC1.6 (I1), IC1.9 (I1), IC1.13 (I1); also elsewhere on the board
MOTOR_R: IC1.5 (I0); also elsewhere on the board
MOTOR_R_OUT: ETH1.P$2 (2), IC1.4 (O)
START_R: IC1.1 (I0); also elsewhere on the board
START_R_OUT: ETH1.P$1 (1), IC1.3 (O)
VDD: IC1.14 (VDD), SJ2.2
VSS: IC1.7 (VSS), SJ1.2

Notes on the sheet:
Connections to Relay Board

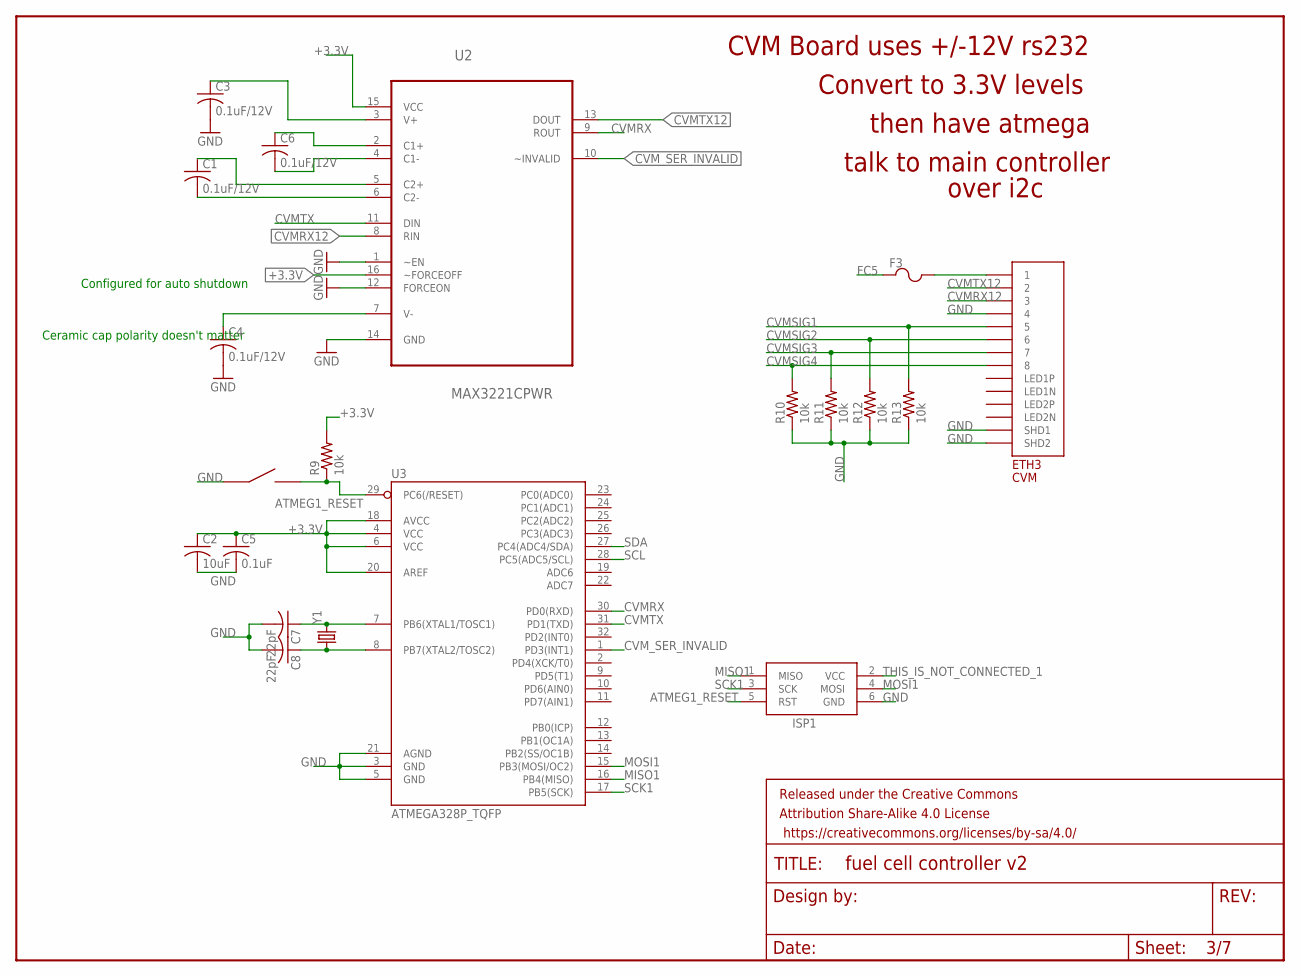
[picture p13: schematic Fuel Cell Controller V2.sch, sheet 3]

Parts:
C1, C3, C4, C6: 0.1uF/12V; C0805
C2: 10uF; C0603
C5: 0.1uF; C0603
C7, C8: 22pF; C0603
ETH3: CVM; A122645-ND
F3: POLYFUSE; 1206
FRAME3: FRAME-LETTERNO_PACKAGE; DUMMY
ISP1: AVRISP-BOX
R9: 10k; R0603
R10, R11, R12, R13: 10k; 0805
S1: EG4621CT-ND
U2: MAX3221CPWR; SOP65P640X120-16N
U3: ATMEGA328P_TQFP; TQFP32-08
Y1: CRYSTALHC49US; HC49US

Connections:
+3.3V: C2.1, C5.1, R9.2, U2.15 (VCC), U2.16 (~FORCEOFF), U3.4 (VCC), U3.6 (VCC), U3.18 (AVCC), U3.20 (AREF); also elsewhere on the board
ATMEG1_RESET: ISP1.5 (RST), R9.1, S1.P$3, S1.P$4, U3.29 (PC6(/RESET))
CVMRX: U2.9 (ROUT), U3.30 (PD0(RXD))
CVMRX12: ETH3.P$3 (3), U2.8 (RIN)
CVMSIG1: ETH3.P$5 (5), R13.2; also elsewhere on the board
CVMSIG2: ETH3.P$6 (6), R12.2; also elsewhere on the board
CVMSIG3: ETH3.P$7 (7), R11.2; also elsewhere on the board
CVMSIG4: ETH3.P$8 (8), R10.2; also elsewhere on the board
CVMTX: U2.11 (DIN), U3.31 (PD1(TXD))
CVMTX12: ETH3.P$2 (2), U2.13 (DOUT)
CVM_SER_INVALID: U2.10 (~INVALID), U3.1 (PD3(INT1))
FC5: F3.1; also elsewhere on the board
GND: C2.2, C3.2, C4.2, C5.2, C7.2, C8.2, ETH3.P$4 (4), ETH3.P$13 (SHD1), ETH3.P$14 (SHD2), ISP1.6 (GND), R10.1, R11.1, R12.1, R13.1, S1.P$1, S1.P$2, U2.1 (~EN), U2.12 (FORCEON), U2.14 (GND), U3.3 (GND), U3.5 (GND), U3.21 (AGND); also elsewhere on the board
MISO1: ISP1.1 (MISO), U3.16 (PB4(MISO))
MOSI1: ISP1.4 (MOSI), U3.15 (PB3(MOSI/OC2))
unnamed: C7.1, U3.7 (PB6(XTAL1/TOSC1)), Y1.2
unnamed: C8.1, U3.8 (PB7(XTAL2/TOSC2)), Y1.1
unnamed: ETH3.P$1 (1), F3.2
unnamed: C3.1, U2.3 (V+)
unnamed: C6.1, U2.2 (C1+)
unnamed: C6.2, U2.4 (C1-)
unnamed: C1.1, U2.5 (C2+)
unnamed: C1.2, U2.6 (C2-)
unnamed: C4.1, U2.7 (V-)
SCK1: ISP1.3 (SCK), U3.17 (PB5(SCK))
SCL: U3.28 (PC5(ADC5/SCL)); also elsewhere on the board
SDA: U3.27 (PC4(ADC4/SDA)); also elsewhere on the board
THIS_IS_NOT_CONNECTED_1: ISP1.2 (VCC)

Notes on the sheet:
Configured for auto shutdown
CVM Board uses +/-12V rs232
Convert to 3.3V levels
then have atmega
talk to main controller
over i2c
Ceramic cap polarity doesn't matter

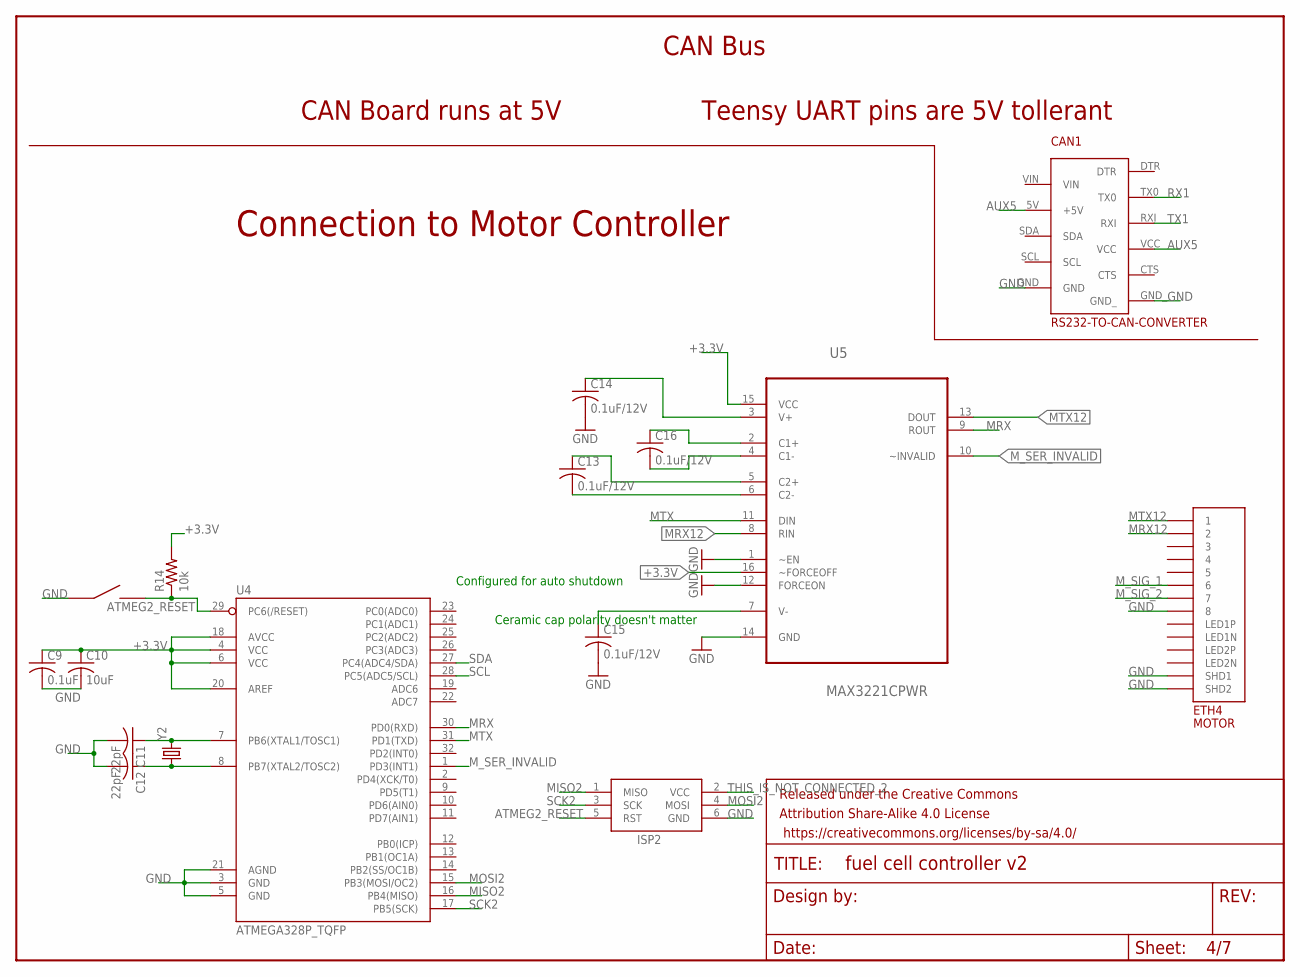
[picture p14: schematic Fuel Cell Controller V2.sch, sheet 4]

Parts:
C9: 0.1uF; C0603
C10: 10uF; C0603
C11, C12: 22pF; C0603
C13, C14, C15, C16: 0.1uF/12V; C0805
CAN1: RS232-TO-CAN-CONVERTER
ETH4: MOTOR; A122645-ND
FRAME4: FRAME-LETTERNO_PACKAGE; DUMMY
ISP2: AVRISP-BOX
R14: 10k; R0603
S2: EG4621CT-ND
U4: ATMEGA328P_TQFP; TQFP32-08
U5: MAX3221CPWR; SOP65P640X120-16N
Y2: CRYSTALHC49US; HC49US

Connections:
+3.3V: C9.1, C10.1, R14.2, U4.4 (VCC), U4.6 (VCC), U4.18 (AVCC), U4.20 (AREF), U5.15 (VCC), U5.16 (~FORCEOFF); also elsewhere on the board
ATMEG2_RESET: ISP2.5 (RST), R14.1, S2.P$3, S2.P$4, U4.29 (PC6(/RESET))
AUX5: CAN1.5V (+5V), CAN1.VCC; also elsewhere on the board
GND: C9.2, C10.2, C11.2, C12.2, C14.2, C15.2, CAN1.GND, CAN1.GND_, ETH4.P$8 (8), ETH4.P$13 (SHD1), ETH4.P$14 (SHD2), ISP2.6 (GND), S2.P$1, S2.P$2, U4.3 (GND), U4.5 (GND), U4.21 (AGND), U5.1 (~EN), U5.12 (FORCEON), U5.14 (GND); also elsewhere on the board
MISO2: ISP2.1 (MISO), U4.16 (PB4(MISO))
MOSI2: ISP2.4 (MOSI), U4.15 (PB3(MOSI/OC2))
MRX: U4.30 (PD0(RXD)), U5.9 (ROUT)
MRX12: ETH4.P$2 (2), U5.8 (RIN)
MTX: U4.31 (PD1(TXD)), U5.11 (DIN)
MTX12: ETH4.P$1 (1), U5.13 (DOUT)
M_SER_INVALID: U4.1 (PD3(INT1)), U5.10 (~INVALID)
M_SIG_1: ETH4.P$6 (6); also elsewhere on the board
M_SIG_2: ETH4.P$7 (7); also elsewhere on the board
unnamed: C11.1, U4.7 (PB6(XTAL1/TOSC1)), Y2.2
unnamed: C12.1, U4.8 (PB7(XTAL2/TOSC2)), Y2.1
unnamed: C14.1, U5.3 (V+)
unnamed: C16.1, U5.2 (C1+)
unnamed: C16.2, U5.4 (C1-)
unnamed: C13.1, U5.5 (C2+)
unnamed: C13.2, U5.6 (C2-)
unnamed: C15.1, U5.7 (V-)
RX1: CAN1.TX0; also elsewhere on the board
SCK2: ISP2.3 (SCK), U4.17 (PB5(SCK))
SCL: U4.28 (PC5(ADC5/SCL)); also elsewhere on the board
SDA: U4.27 (PC4(ADC4/SDA)); also elsewhere on the board
THIS_IS_NOT_CONNECTED_2: ISP2.2 (VCC)
TX1: CAN1.RXI; also elsewhere on the board

Notes on the sheet:
CAN Bus
CAN Board runs at 5V
Teensy UART pins are 5V tollerant
Connection to Motor Controller
Configured for auto shutdown
Ceramic cap polarity doesn't matter

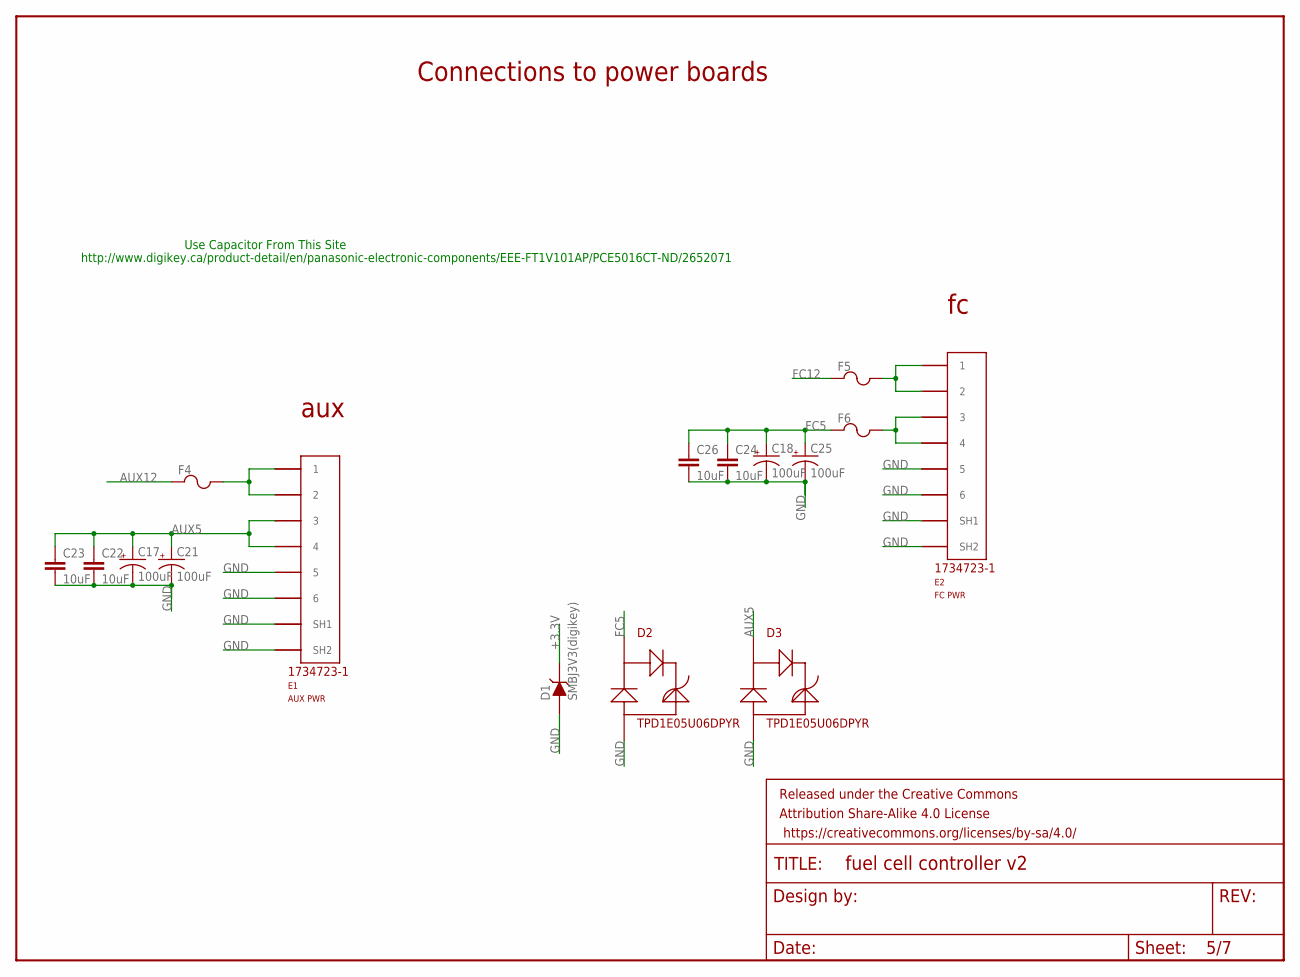
[picture p15: schematic Fuel Cell Controller V2.sch, sheet 5]

Parts:
C17, C18, C21, C25: 100uF; PANASONIC_D
C22, C23, C24, C26: 10uF; 0805
D1: SMBJ3V3(digikey); DO-214AB
D2, D3: TPD1E05U06DPYR; 2-XDFN
E1: AUX PWR; 1734723-1_RJ11
E2: FC PWR; 1734723-1_RJ11
F4, F5, F6: POLYFUSE; 1206
FRAME5: FRAME-LETTERNO_PACKAGE; DUMMY

Connections:
+3.3V: D1.C; also elsewhere on the board
AUX5: C17.+, C21.+, C22.1, C23.1, D3.P$1, E1.3, E1.4; also elsewhere on the board
AUX12: F4.1; also elsewhere on the board
FC5: C18.+, C24.1, C25.+, C26.1, D2.P$1, F6.1; also elsewhere on the board
FC12: F5.1; also elsewhere on the board
GND: C17.-, C18.-, C21.-, C22.2, C23.2, C24.2, C25.-, C26.2, D1.A, D2.P$2, D3.P$2, E1.5, E1.6, E1.SH1, E1.SH2, E2.5, E2.6, E2.SH1, E2.SH2; also elsewhere on the board
unnamed: E1.1, E1.2, F4.2
unnamed: E2.1, E2.2, F5.2
unnamed: E2.3, E2.4, F6.2

Notes on the sheet:
Connections to power boards
aux
Use Capacitor From This Site
http://www.digikey.ca/product-detail/en/panasonic-electronic-components/EEE-FT1V101AP/PCE5016CT-ND/2652071

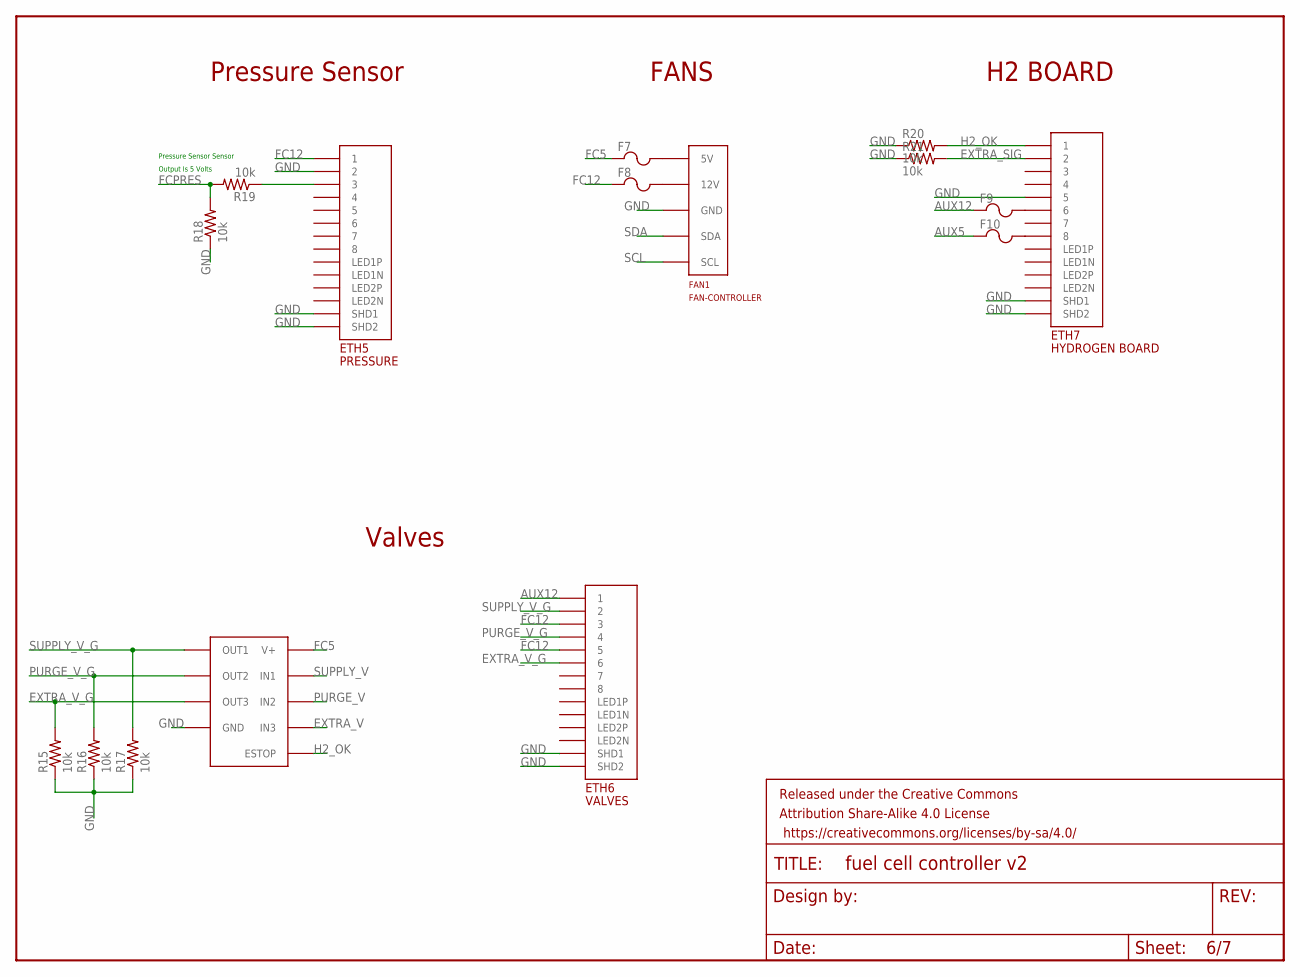
[picture p16: schematic Fuel Cell Controller V2.sch, sheet 6]

Parts:
ETH5: PRESSURE; A122645-ND
ETH6: VALVES; A122645-ND
ETH7: HYDROGEN BOARD; A122645-ND
F7, F8, F9, F10: POLYFUSE; 1206
FAN1: FAN-CONTROLLER
FRAME6: FRAME-LETTERNO_PACKAGE; DUMMY
M1: MOSFETBOARD; MOSFET-BOARD
R15, R16, R17, R18, R19: 10k; 0805
R20, R21: 10k; R0603

Connections:
AUX5: F10.1; also elsewhere on the board
AUX12: ETH6.P$1 (1), F9.1; also elsewhere on the board
EXTRA_SIG: ETH7.P$2 (2), R21.2; also elsewhere on the board
EXTRA_V: M1.IN3; also elsewhere on the board
EXTRA_V_G: ETH6.P$6 (6), M1.OUT3, R15.2
FC5: F7.1, M1.VDD (V+); also elsewhere on the board
FC12: ETH5.P$1 (1), ETH6.P$3 (3), ETH6.P$5 (5), F8.1; also elsewhere on the board
FCPRES: R18.2, R19.2; also elsewhere on the board
GND: ETH5.P$2 (2), ETH5.P$13 (SHD1), ETH5.P$14 (SHD2), ETH6.P$13 (SHD1), ETH6.P$14 (SHD2), ETH7.P$5 (5), ETH7.P$13 (SHD1), ETH7.P$14 (SHD2), FAN1.GND, FAN1.GND2 (GND), FAN1.GND3 (GND), M1.GND, M1.GND1 (GND), M1.GND2 (GND), M1.VSS (GND), R15.1, R16.1, R17.1, R18.1, R20.1, R21.1; also elsewhere on the board
H2_OK: ETH7.P$1 (1), M1.ESTOP, R20.2; also elsewhere on the board
unnamed: ETH7.P$6 (6), F9.2
unnamed: ETH7.P$8 (8), F10.2
unnamed: F7.2, FAN1.5 (5V), FAN1.5_2 (5V)
unnamed: F8.2, FAN1.12 (12V), FAN1.12_2 (12V), FAN1.12_3 (12V)
unnamed: ETH5.P$3 (3), R19.1
PURGE_V: M1.IN2; also elsewhere on the board
PURGE_V_G: ETH6.P$4 (4), M1.OUT2, R16.2
SCL: FAN1.SCL; also elsewhere on the board
SDA: FAN1.SDA; also elsewhere on the board
SUPPLY_V: M1.IN1; also elsewhere on the board
SUPPLY_V_G: ETH6.P$2 (2), M1.OUT1, R17.2

Notes on the sheet:
Valves
Pressure Sensor
FANS
H2 BOARD
Pressure Sensor Sensor
Output Is 5 Volts

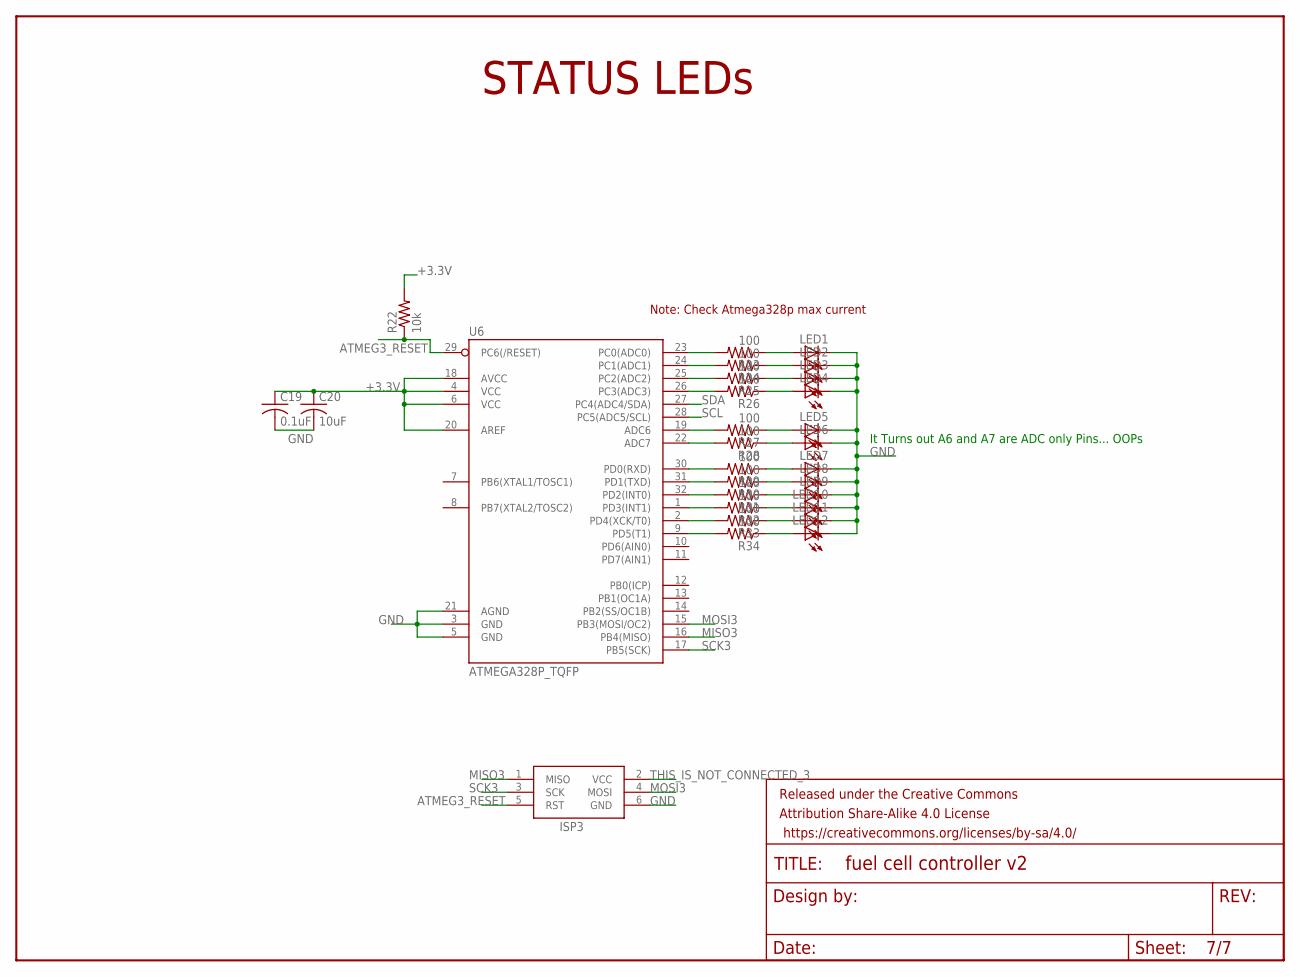
[picture p17: schematic Fuel Cell Controller V2.sch, sheet 7]

Parts:
C19: 0.1uF; C0603
C20: 10uF; C0603
FRAME7: FRAME-LETTERNO_PACKAGE; DUMMY
ISP3: AVRISP-BOX
LED1, LED2, LED3, LED4, LED5, LED6, LED7, LED8, LED9, LED10, LED11, LED12: LEDCHIPLED_0805; CHIPLED_0805
R22: 10k; R0603
R23, R24, R25, R26, R27, R28, R29, R30, R31, R32, R33, R34: 100; R0603
U6: ATMEGA328P_TQFP; TQFP32-08

Connections:
+3.3V: C19.1, C20.1, R22.2, U6.4 (VCC), U6.6 (VCC), U6.18 (AVCC), U6.20 (AREF); also elsewhere on the board
ATMEG3_RESET: ISP3.5 (RST), R22.1, U6.29 (PC6(/RESET))
GND: C19.2, C20.2, ISP3.6 (GND), LED1.C, LED2.C, LED3.C, LED4.C, LED5.C, LED6.C, LED7.C, LED8.C, LED9.C, LED10.C, LED11.C, LED12.C, U6.3 (GND), U6.5 (GND), U6.21 (AGND); also elsewhere on the board
MISO3: ISP3.1 (MISO), U6.16 (PB4(MISO))
MOSI3: ISP3.4 (MOSI), U6.15 (PB3(MOSI/OC2))
unnamed: R23.2, U6.23 (PC0(ADC0))
unnamed: R24.2, U6.24 (PC1(ADC1))
unnamed: R25.2, U6.25 (PC2(ADC2))
unnamed: R26.2, U6.26 (PC3(ADC3))
unnamed: R27.2, U6.19 (ADC6)
unnamed: R28.2, U6.22 (ADC7)
unnamed: R29.2, U6.30 (PD0(RXD))
unnamed: R30.2, U6.31 (PD1(TXD))
unnamed: R31.2, U6.32 (PD2(INT0))
unnamed: R32.2, U6.1 (PD3(INT1))
unnamed: R33.2, U6.2 (PD4(XCK/T0))
unnamed: R34.2, U6.9 (PD5(T1))
unnamed: LED12.A, R34.1
unnamed: LED11.A, R33.1
unnamed: LED10.A, R32.1
unnamed: LED9.A, R31.1
unnamed: LED8.A, R30.1
unnamed: LED7.A, R29.1
unnamed: LED6.A, R28.1
unnamed: LED5.A, R27.1
unnamed: LED4.A, R26.1
unnamed: LED3.A, R25.1
unnamed: LED2.A, R24.1
unnamed: LED1.A, R23.1
SCK3: ISP3.3 (SCK), U6.17 (PB5(SCK))
SCL: U6.28 (PC5(ADC5/SCL)); also elsewhere on the board
SDA: U6.27 (PC4(ADC4/SDA)); also elsewhere on the board
THIS_IS_NOT_CONNECTED_3: ISP3.2 (VCC)

Notes on the sheet:
STATUS LEDs
Note: Check Atmega328p max current
It Turns out A6 and A7 are ADC only Pins... OOPs

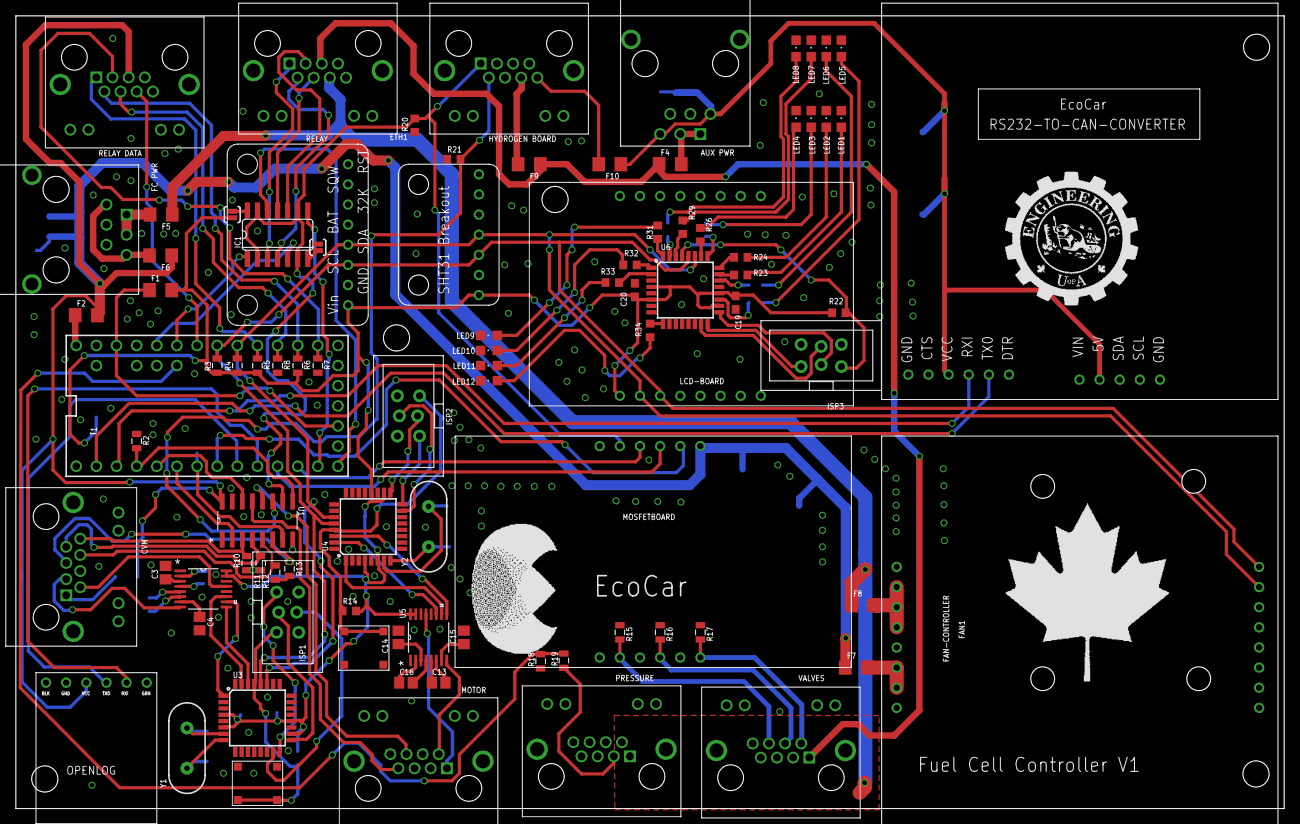
[picture p18: board Fuel Cell Controller V2.brd from above]

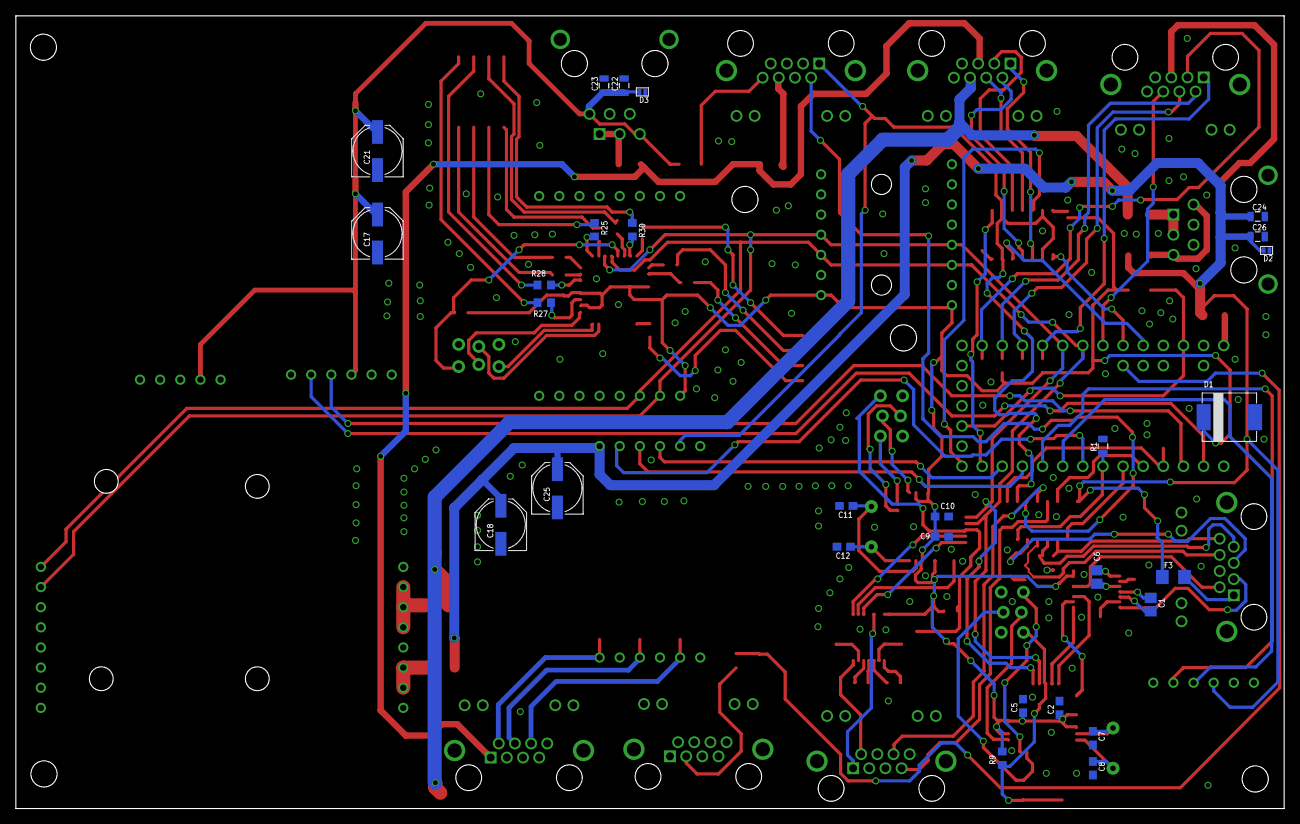
[picture p19: board Fuel Cell Controller V2.brd from below]

Board: 2 copper layers, 160.0 x 100.0 mm, 130 parts (28 on the bottom side), 119 nets.
