UAlberta-EcoCar/ARCHIVED-Fuel-Cell-Controller-2016-2017/Hardware/Motor Driver/H-Bridge_v2.brd

## EAGLE design Hardware/Motor Driver/H-Bridge_v2.brd (2017-04-13)

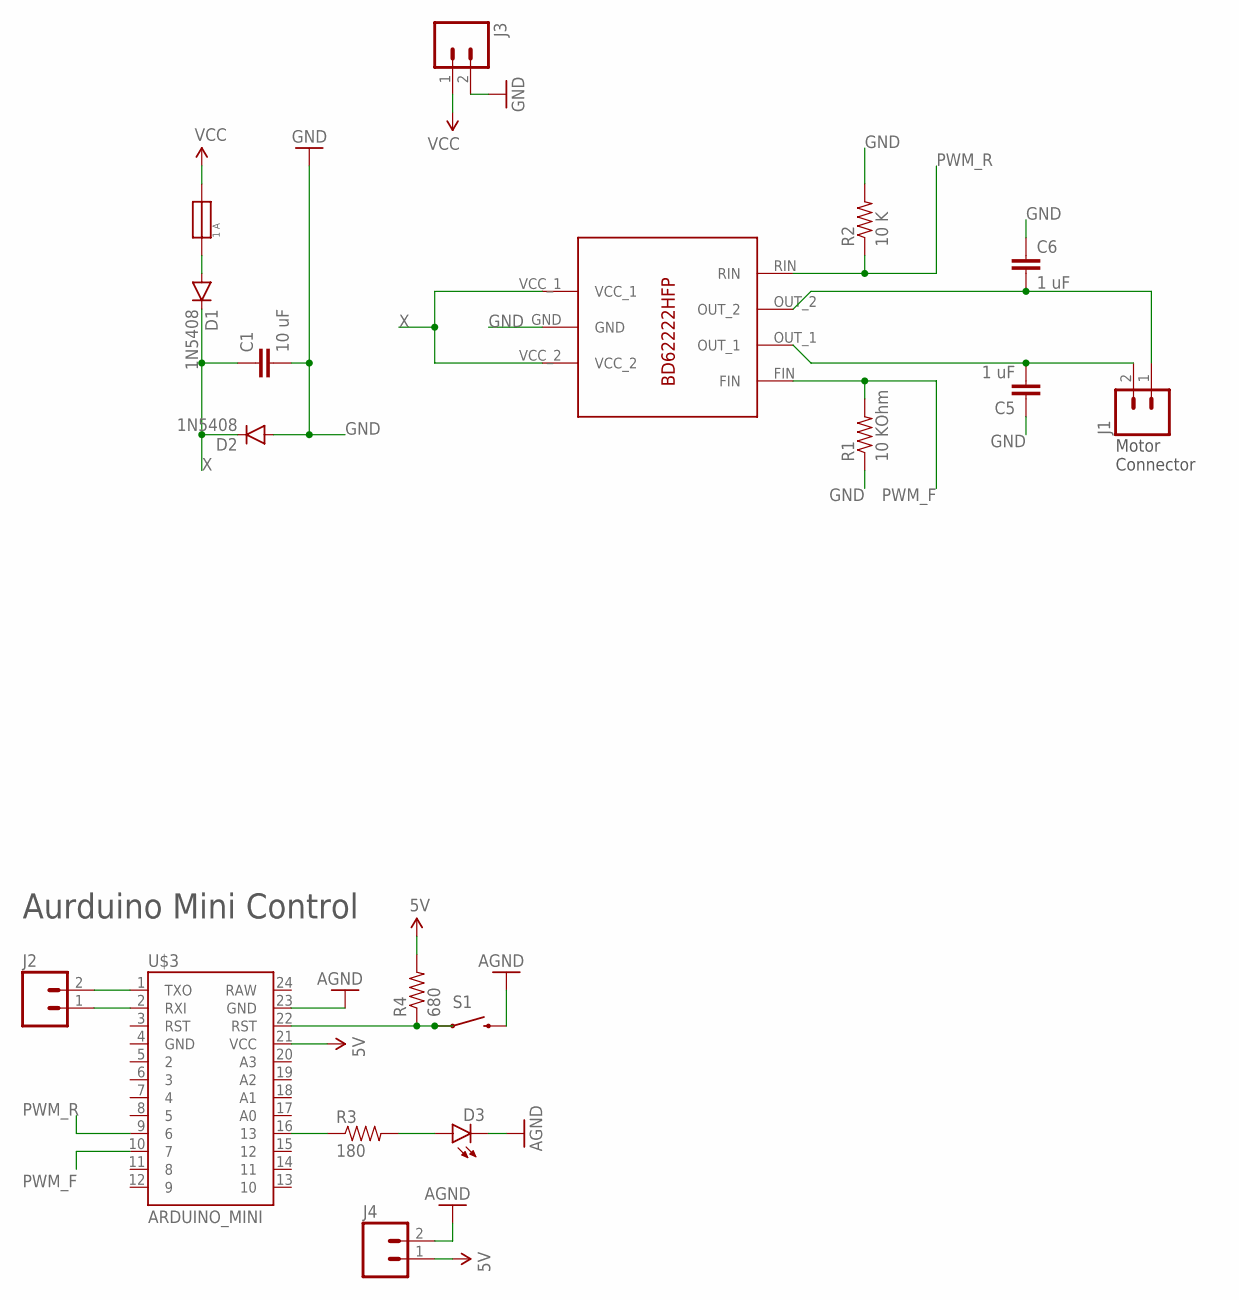
[picture p20: schematic H-Bridge_v2.sch]

Parts:
C1: 10 uF; 0805
C5, C6: 1 uF; 0805
D1, D2: 1N5408; DIODE-1N4148
D3: LED3MM
J1, J3, J4: M023.5MM; SCREWTERMINAL-3.5MM-2
J2: M02LOCK; 1X02_LOCK
R1: 10 KOhm; 1/6W-RES
R2: 10 K; 1/6W-RES
R3: 180; AXIAL-0.3
R4: 680; AXIAL-0.3
S1: SWITCH-MOMENTARY-2PTH; TACTILE-PTH
U$1: BD62222HFP
U$3: ARDUINO_MINI
U$8: 1 A; 5MM_PC_FUSE_HOLDER_KEYSTONE_ELEC

Connections:
5V: J4.1, R4.P$2 (2), U$3.21 (VCC)
AGND: D3.K (C), J4.2, S1.3 (2), U$3.23 (GND)
GND: C1.2, C5.1, C6.1, D2.A, J3.2, R1.1, R2.2, U$1.GND
unnamed: C5.2, J1.2, U$1.OUT_1
unnamed: C6.2, J1.1, U$1.OUT_2
unnamed: R3.P$1 (1), U$3.16 (13)
unnamed: D3.A, R3.P$2 (2)
unnamed: R4.P$1 (1), S1.1, U$3.22 (RST)
unnamed: J2.1, U$3.2 (RXI)
unnamed: J2.2, U$3.1 (TXO)
unnamed: D1.A, U$8.P$2
PWM_F: R1.2, U$1.FIN, U$3.10 (7)
PWM_R: R2.1, U$1.RIN, U$3.9 (6)
VCC: J3.1, U$8.P$1
X: C1.1, D1.C, D2.C, U$1.VCC_1, U$1.VCC_2

Notes on the sheet:
Motor Connector
Aurduino Mini Control

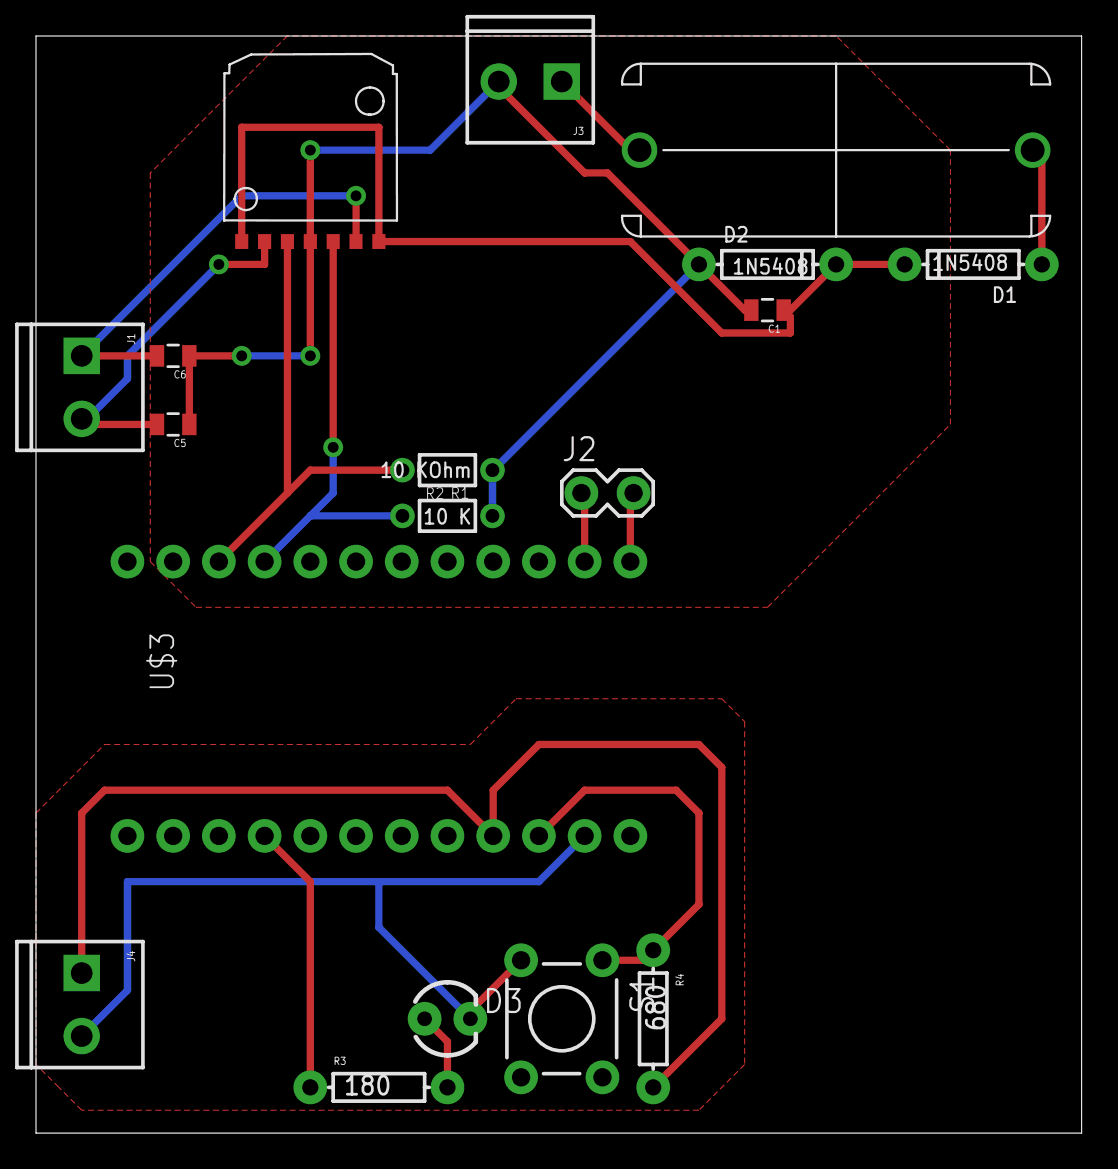
[picture p21: board H-Bridge_v2.brd from above]

Board: 2 copper layers, 58.1 x 61.0 mm, 18 parts (0 on the bottom side), 15 nets.
