UAlberta-EcoCar/ARCHIVED-Fuel-Cell-Controller-2016-2017/Hardware/Ideal Diode/Ideal Diode test.brd

## EAGLE design Hardware/Ideal Diode/Ideal Diode test.brd (2017-04-13)

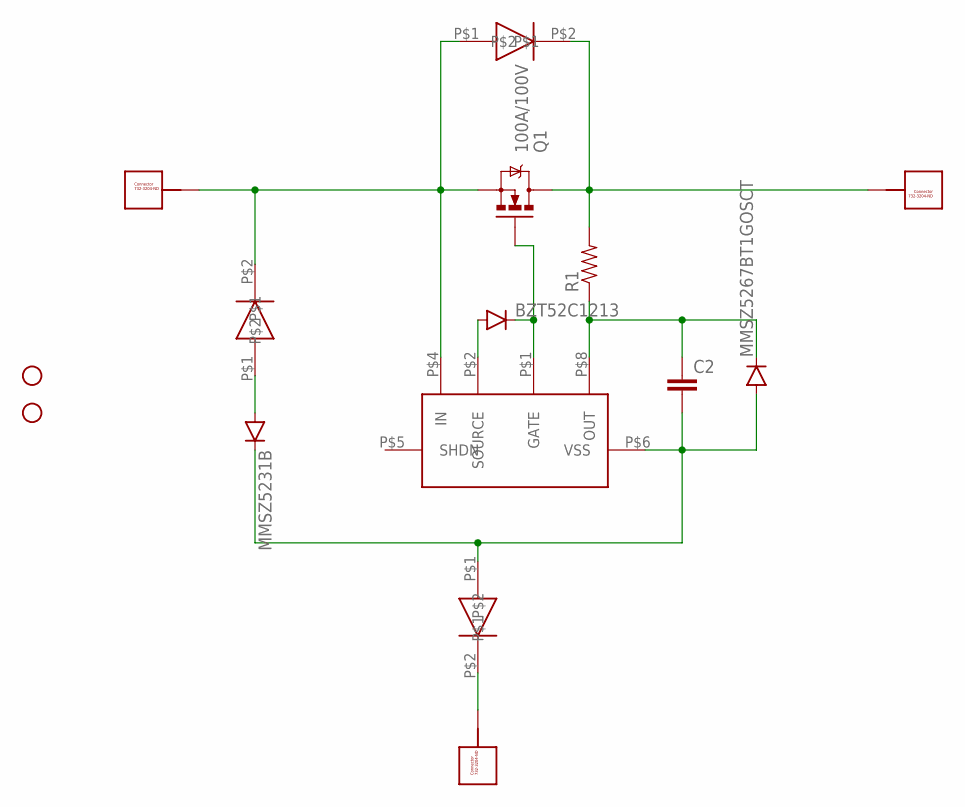
[picture p22: schematic Ideal Diode test.sch]

Parts:
BZT52C1213: DIODESOD123; SOD-123
C2: CAP0603-CAP; 0603-CAP
MMSZ5231B, MMSZ5267BT1GOSCT: DIODESOD123; SOD-123
Q1: 100A/100V; TO-263/D2PAK
R1: RESISTOR0603-RES; 0603-RES
S1B: DIODE; SMA
SMAJ70A, SMAJ150A: DIODE; SMA
STANDOFF1, STANDOFF2: STAND-OFF
U$1: LTC359; LTC4359
U$2, U$3, U$4: 732-3204-ND_CONNECTOR; 732-3204-ND

Connections:
GND: S1B.P$2, U$4.P$1, U$4.P$2, U$4.P$3, U$4.P$4, U$4.P$5, U$4.P$6, U$4.P$7, U$4.P$8, U$4.P$9, U$4.P$10
unnamed: Q1.3 (S), SMAJ70A.P$2, SMAJ150A.P$1, U$1.P$4 (IN), U$3.P$1, U$3.P$2, U$3.P$3, U$3.P$4, U$3.P$5, U$3.P$6, U$3.P$7, U$3.P$8, U$3.P$9, U$3.P$10
unnamed: Q1.2 (D), R1.2, SMAJ150A.P$2, U$2.P$1, U$2.P$2, U$2.P$3, U$2.P$4, U$2.P$5, U$2.P$6, U$2.P$7, U$2.P$8, U$2.P$9, U$2.P$10
unnamed: C2.1, MMSZ5267BT1GOSCT.C, R1.1, U$1.P$8 (OUT)
unnamed: BZT52C1213.A, U$1.P$2 (SOURCE)
unnamed: BZT52C1213.C, Q1.1 (G), U$1.P$1 (GATE)
unnamed: C2.2, MMSZ5231B.C, MMSZ5267BT1GOSCT.A, S1B.P$1, U$1.P$6 (VSS)
unnamed: MMSZ5231B.A, SMAJ70A.P$1

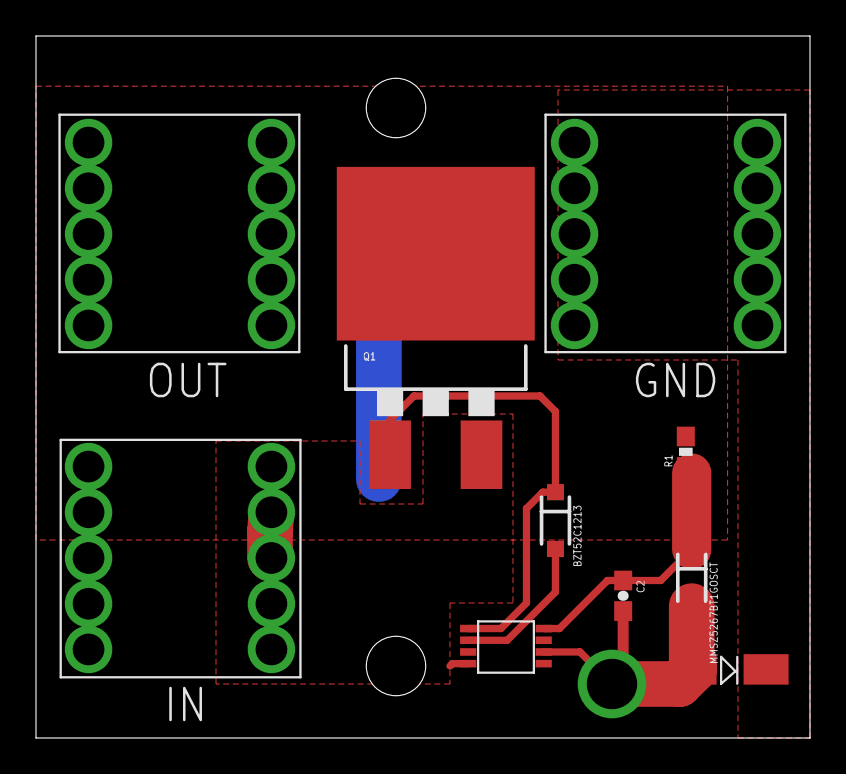
[picture p23: board Ideal Diode test.brd from above]

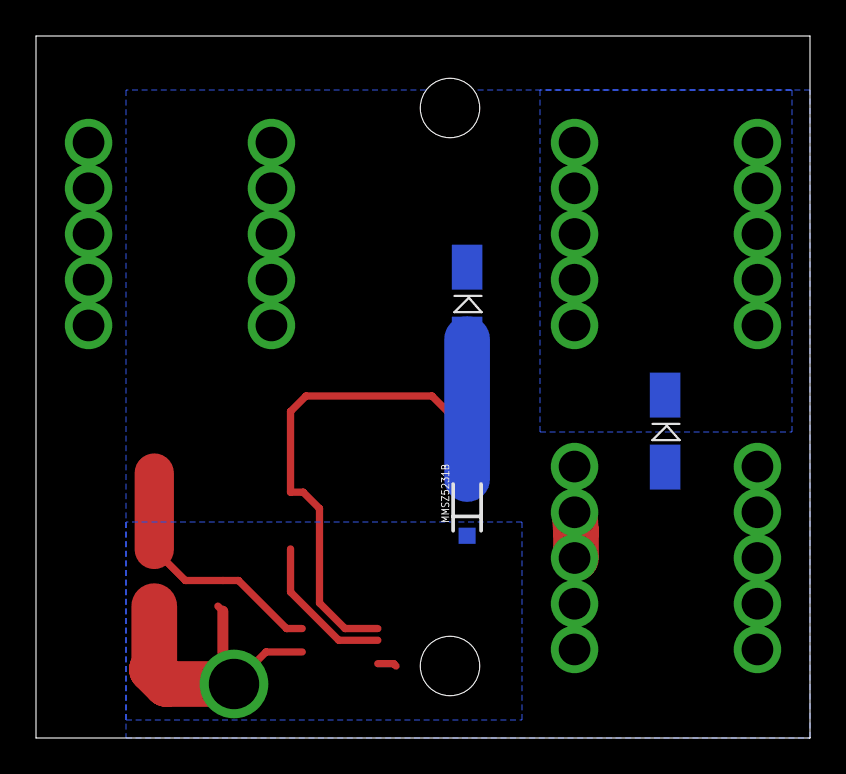
[picture p24: board Ideal Diode test.brd from below]

Board: 2 copper layers, 43.0 x 39.0 mm, 15 parts (3 on the bottom side), 8 nets.
