UAlberta-EcoCar/ARCHIVED-Fuel-Cell-Controller-2016-2017/Hardware/Fan Controller/Fan_control_design v2.brd

## EAGLE design Hardware/Fan Controller/Fan_control_design v2.brd (2017-04-13)

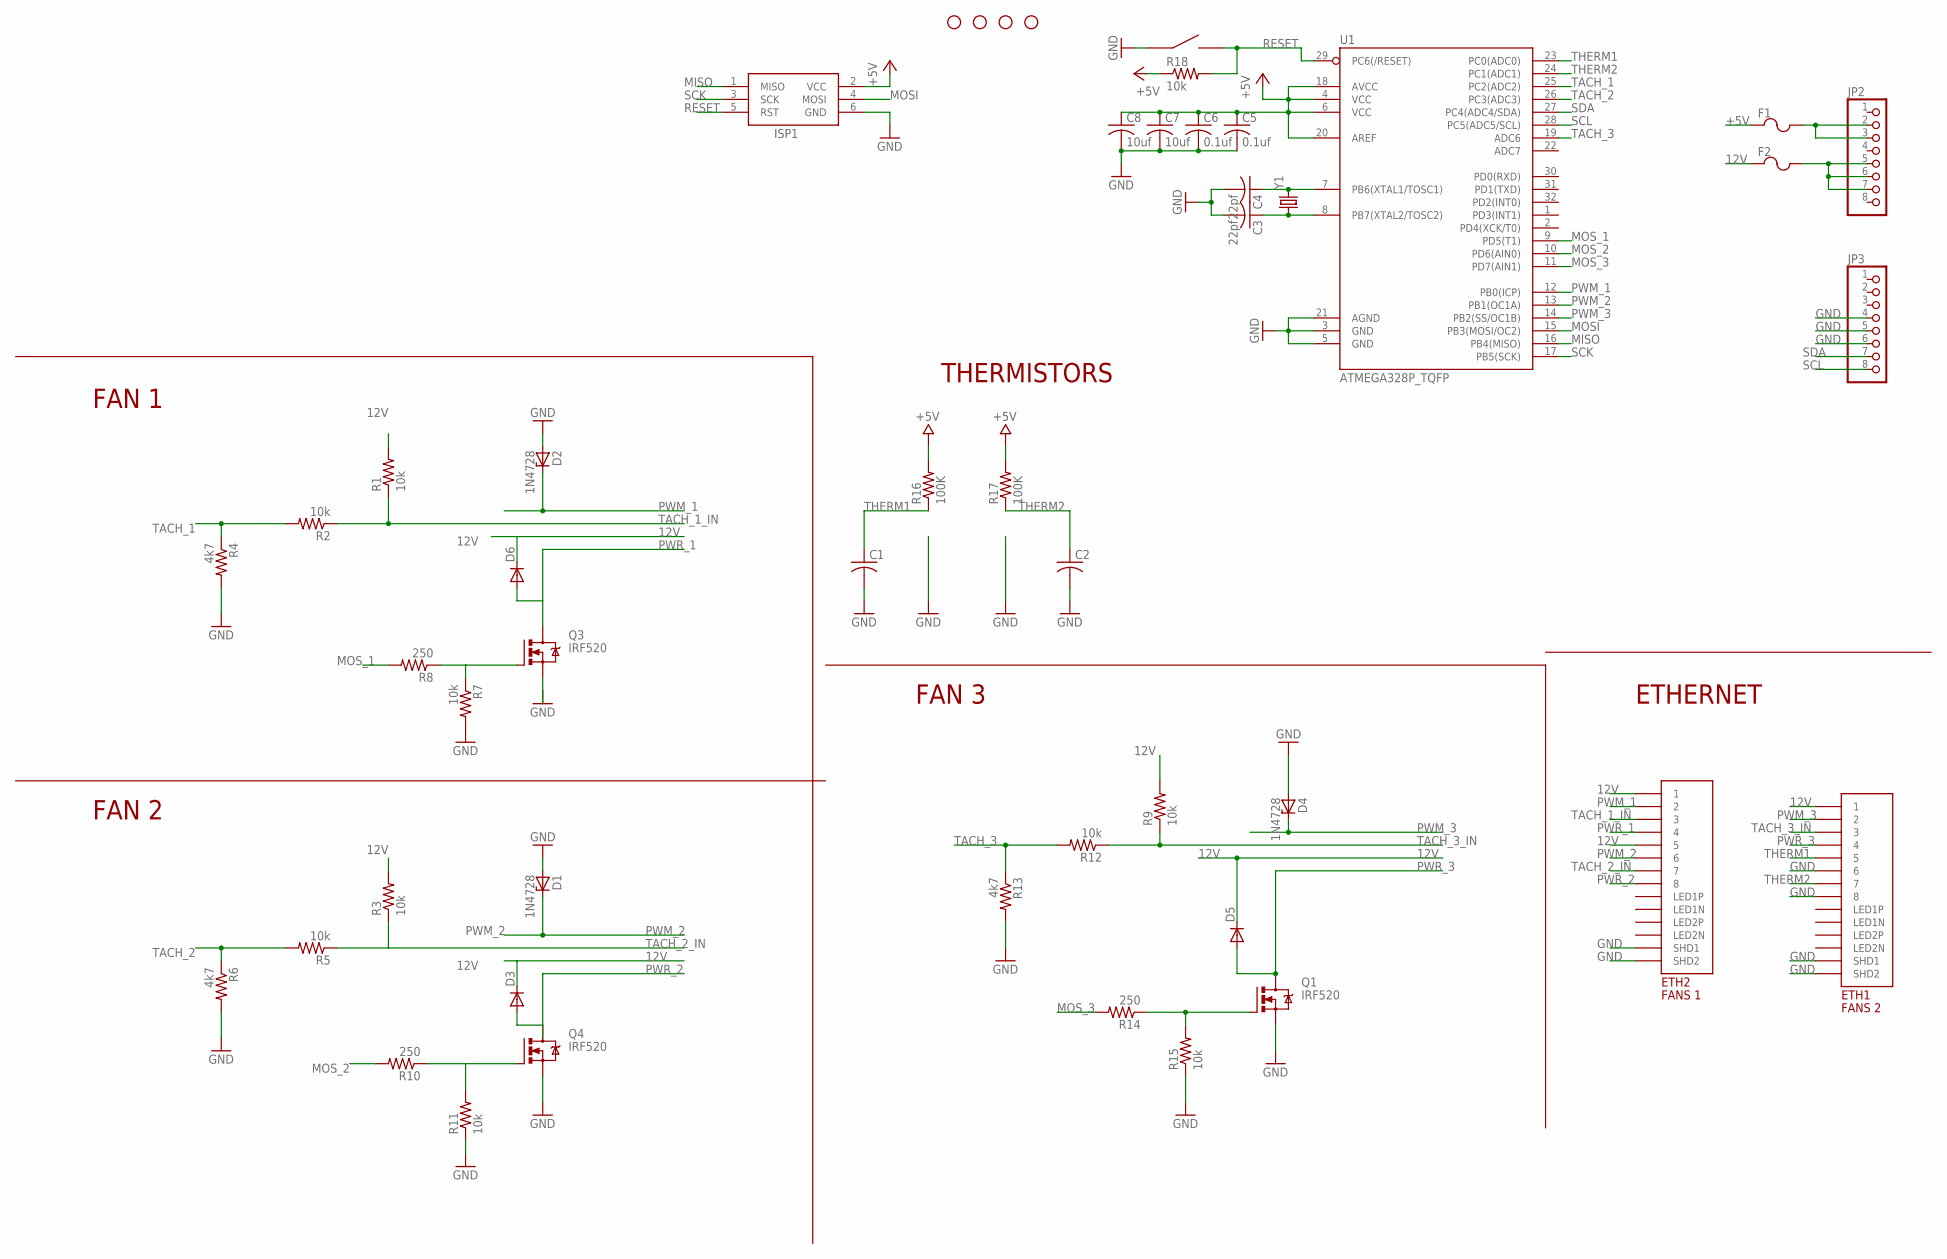
[picture p25: schematic Fan_control_design v2.sch]

Parts:
C1, C2: C-USC0603K; C0603K
C3, C4: 22pf; C0603
C5, C6: 0.1uf; C0603
C7, C8: 10uf; C0603
D1, D2, D4: 1N4728; DO41Z10
D3, D5, D6: DIODE-DO214AC; DO214AC
ETH1: FANS 2; A122645-ND
ETH2: FANS 1; A122645-ND
F1, F2: POLYFUSE; 1206
ISP1: AVRISP-BOX
JP2, JP3: PINHD-1X8BIG; 1X08-BIG
Q1, Q3, Q4: IRF520; TO220BV
R1, R2, R3, R5, R7, R9, R11, R12, R15, R18: 10k; R0603
R4, R6, R13: 4k7; R0603
R8, R10, R14: 250; R0603
R16, R17: 100K; R0603
STANDOFF1, STANDOFF2, STANDOFF3, STANDOFF4: STAND-OFF
U1: ATMEGA328P_TQFP; TQFP32-08
U$3: EG4621CT-ND
Y1: CRYSTALHC49US; HC49US

Connections:
12V: D3.C, D5.C, D6.C, ETH1.P$1 (1), ETH2.P$1 (1), ETH2.P$5 (5), F2.1, R1.2, R3.2, R9.2
+5V: C5.1, C6.1, C7.1, C8.1, F1.1, ISP1.2 (VCC), R16.2, R17.2, R18.1, U1.4 (VCC), U1.6 (VCC), U1.18 (AVCC), U1.20 (AREF)
GND: C1.2, C2.2, C3.2, C4.2, C5.2, C6.2, C7.2, C8.2, D1.A, D2.A, D4.A, ETH1.P$6 (6), ETH1.P$8 (8), ETH1.P$13 (SHD1), ETH1.P$14 (SHD2), ETH2.P$13 (SHD1), ETH2.P$14 (SHD2), ISP1.6 (GND), JP3.4, JP3.5, JP3.6, Q1.S, Q3.S, Q4.S, R4.2, R6.2, R7.2, R11.1, R13.2, R15.1, U1.3 (GND), U1.5 (GND), U1.21 (AGND), U$3.P$1, U$3.P$2
MISO: ISP1.1 (MISO), U1.16 (PB4(MISO))
MOSI: ISP1.4 (MOSI), U1.15 (PB3(MOSI/OC2))
MOS_1: R8.2, U1.9 (PD5(T1))
MOS_2: R10.2, U1.10 (PD6(AIN0))
MOS_3: R14.2, U1.11 (PD7(AIN1))
unnamed: F1.2, JP2.2, JP2.3
unnamed: F2.2, JP2.5, JP2.6, JP2.7
unnamed: C3.1, U1.8 (PB7(XTAL2/TOSC2)), Y1.1
unnamed: Q3.G, R7.1, R8.1
unnamed: C4.1, U1.7 (PB6(XTAL1/TOSC1)), Y1.2
unnamed: Q4.G, R10.1, R11.2
unnamed: Q1.G, R14.1, R15.2
PWM_1: D2.C, ETH2.P$2 (2), U1.12 (PB0(ICP))
PWM_2: D1.C, ETH2.P$6 (6), U1.13 (PB1(OC1A))
PWM_3: D4.C, ETH1.P$2 (2), U1.14 (PB2(SS/OC1B))
PWR_1: D6.A, ETH2.P$4 (4), Q3.D
PWR_2: D3.A, ETH2.P$8 (8), Q4.D
PWR_3: D5.A, ETH1.P$4 (4), Q1.D
RESET: ISP1.5 (RST), R18.2, U1.29 (PC6(/RESET)), U$3.P$3, U$3.P$4
SCK: ISP1.3 (SCK), U1.17 (PB5(SCK))
SCL: JP3.8, U1.28 (PC5(ADC5/SCL))
SDA: JP3.7, U1.27 (PC4(ADC4/SDA))
TACH_1: R2.2, R4.1, U1.25 (PC2(ADC2))
TACH_1_IN: ETH2.P$3 (3), R1.1, R2.1
TACH_2: R5.2, R6.1, U1.26 (PC3(ADC3))
TACH_2_IN: ETH2.P$7 (7), R3.1, R5.1
TACH_3: R12.2, R13.1, U1.19 (ADC6)
TACH_3_IN: ETH1.P$3 (3), R9.1, R12.1
THERM1: C1.1, ETH1.P$5 (5), R16.1, U1.23 (PC0(ADC0))
THERM2: C2.1, ETH1.P$7 (7), R17.1, U1.24 (PC1(ADC1))

Notes on the sheet:
FAN 1
FAN 2
FAN 3
THERMISTORS
ETHERNET

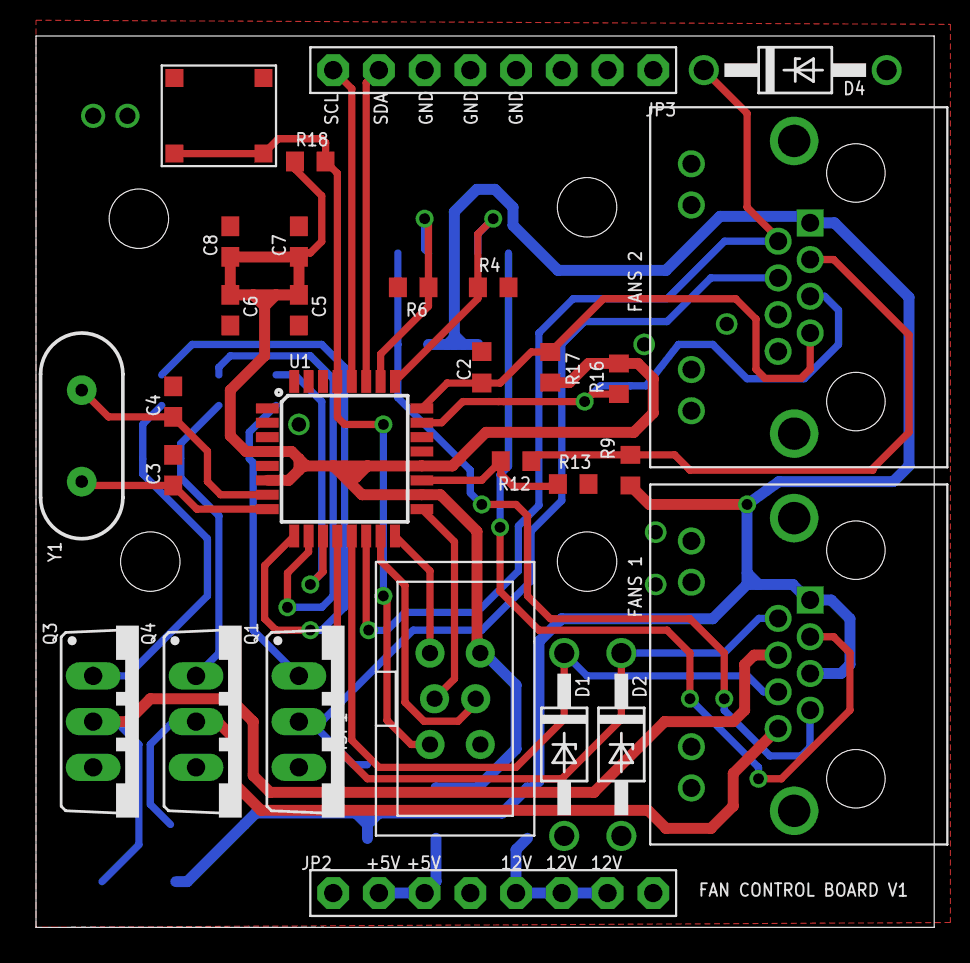
[picture p26: board Fan_control_design v2.brd from above]

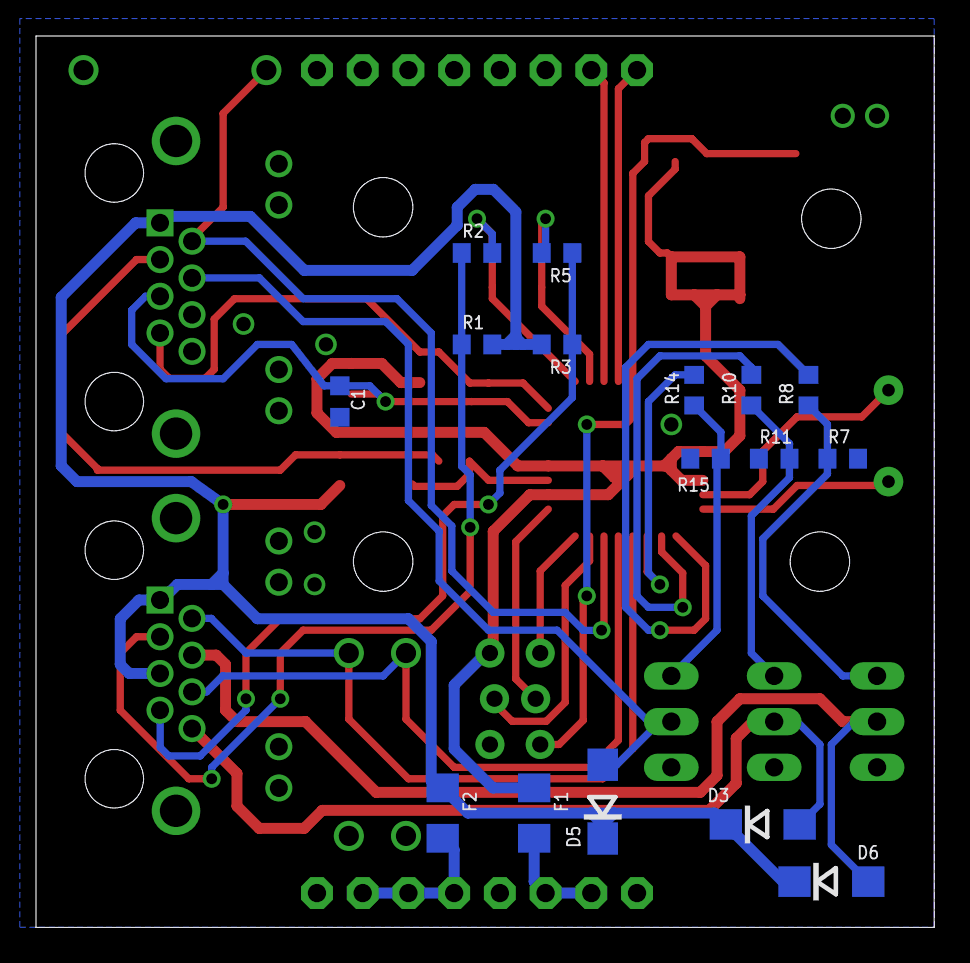
[picture p27: board Fan_control_design v2.brd from below]

Board: 2 copper layers, 49.9 x 49.5 mm, 49 parts (16 on the bottom side), 33 nets.
