UAlberta-EcoCar/ARCHIVED-Fuel-Cell-Controller-2016-2017/Hardware/LCD Board/lcd_display_board_v2.brd

## EAGLE design Hardware/LCD Board/lcd_display_board_v2.brd (2017-04-13)

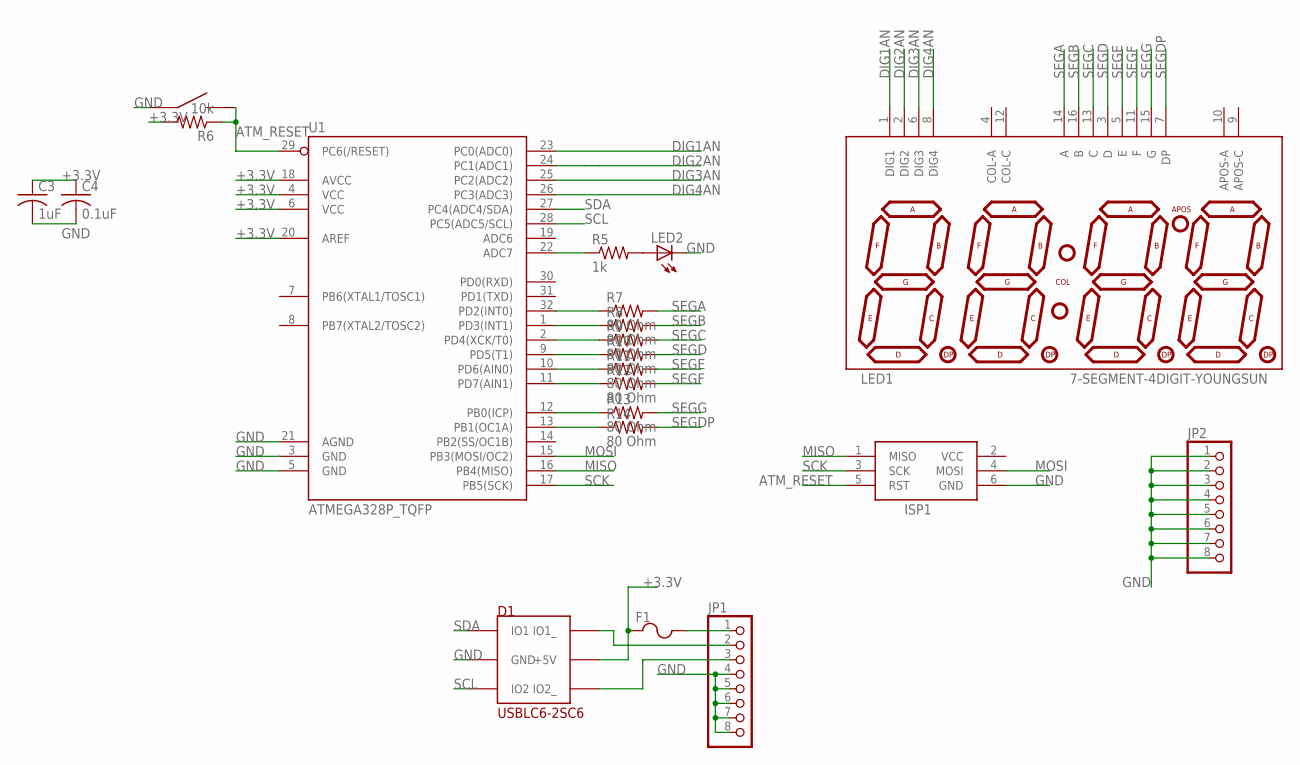
[picture p28: schematic lcd_display_board_v2.sch]

Parts:
C3: 1uF; C0805
C4: 0.1uF; C0805
D1: USBLC6-2SC6
F1: POLYFUSE; 1206
ISP1: AVRISP-BOX
JP1, JP2: PINHD-1X8BIG; 1X08-BIG
LED1: 7-SEGMENT-4DIGIT-YOUNGSUN
LED2: LEDCHIPLED_0805; CHIPLED_0805
R5: 1k; 0603-RES
R6: 10k; 0603-RES
R7, R8, R9, R10, R11, R12, R13, R14: 80 Ohm; 0603-RES
U1: ATMEGA328P_TQFP; TQFP32-08
U$10: EG4621CT-ND

Connections:
+3.3V: C3.1, C4.1, D1.P$5 (+5V), F1.1, R6.2, U1.4 (VCC), U1.6 (VCC), U1.18 (AVCC), U1.20 (AREF)
ATM_RESET: ISP1.5 (RST), R6.1, U1.29 (PC6(/RESET)), U$10.P$3, U$10.P$4
DIG1AN: LED1.1 (DIG1), U1.23 (PC0(ADC0))
DIG2AN: LED1.2 (DIG2), U1.24 (PC1(ADC1))
DIG3AN: LED1.6 (DIG3), U1.25 (PC2(ADC2))
DIG4AN: LED1.8 (DIG4), U1.26 (PC3(ADC3))
GND: C3.2, C4.2, D1.P$2 (GND), ISP1.6 (GND), JP1.4, JP1.5, JP1.6, JP1.7, JP1.8, JP2.1, JP2.2, JP2.3, JP2.4, JP2.5, JP2.6, JP2.7, JP2.8, LED2.C, U1.3 (GND), U1.5 (GND), U1.21 (AGND), U$10.P$1, U$10.P$2
MISO: ISP1.1 (MISO), U1.16 (PB4(MISO))
MOSI: ISP1.4 (MOSI), U1.15 (PB3(MOSI/OC2))
unnamed: F1.2, JP1.1
unnamed: D1.P$6 (IO1_), JP1.2
unnamed: R5.1, U1.22 (ADC7)
unnamed: LED2.A, R5.2
unnamed: R7.1, U1.32 (PD2(INT0))
unnamed: R8.1, U1.1 (PD3(INT1))
unnamed: R9.1, U1.2 (PD4(XCK/T0))
unnamed: R10.1, U1.9 (PD5(T1))
unnamed: R11.1, U1.10 (PD6(AIN0))
unnamed: R12.1, U1.11 (PD7(AIN1))
unnamed: R13.1, U1.12 (PB0(ICP))
unnamed: R14.1, U1.13 (PB1(OC1A))
unnamed: D1.P$4 (IO2_), JP1.3
SCK: ISP1.3 (SCK), U1.17 (PB5(SCK))
SCL: D1.P$3 (IO2), U1.28 (PC5(ADC5/SCL))
SDA: D1.P$1 (IO1), U1.27 (PC4(ADC4/SDA))
SEGA: LED1.14 (A), R7.2
SEGB: LED1.16 (B), R8.2
SEGC: LED1.13 (C), R9.2
SEGD: LED1.3 (D), R10.2
SEGDP: LED1.7 (DP), R14.2
SEGE: LED1.5 (E), R11.2
SEGF: LED1.11 (F), R12.2
SEGG: LED1.15 (G), R13.2
VCC: ISP1.2 (VCC)

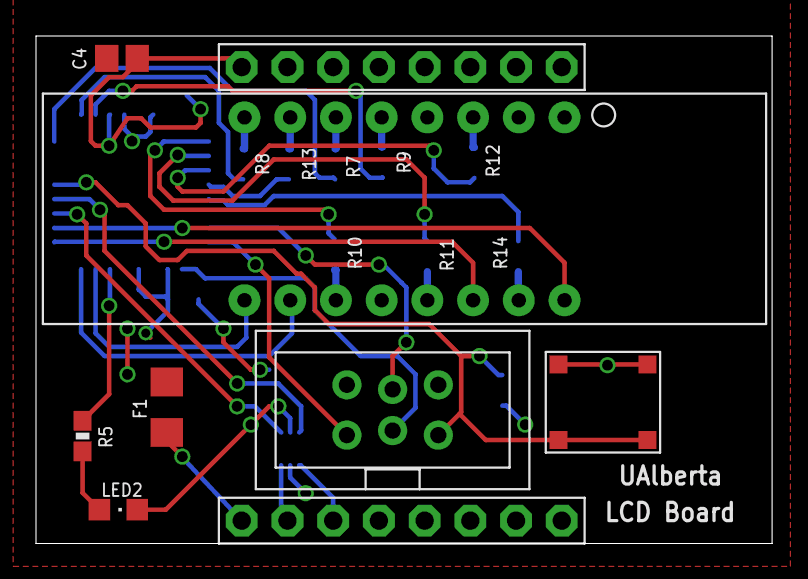
[picture p29: board lcd_display_board_v2.brd from above]

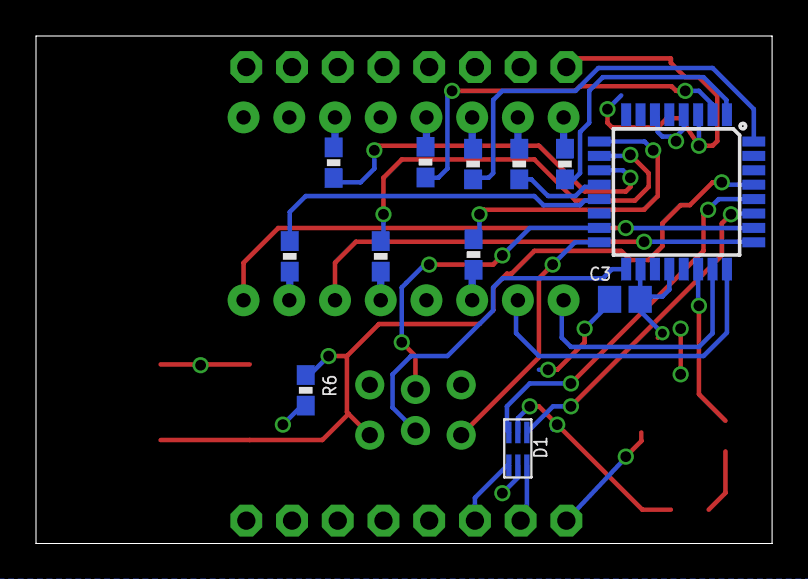
[picture p30: board lcd_display_board_v2.brd from below]

Board: 2 copper layers, 40.9 x 28.2 mm, 21 parts (12 on the bottom side), 33 nets.
