UAlberta-EcoCar/ARCHIVED-Fuel-Cell-Controller-2016-2017/Hardware/Relay Board/Relay_Board_V2.brd

## EAGLE design Hardware/Relay Board/Relay_Board_V2.brd (2017-04-13)

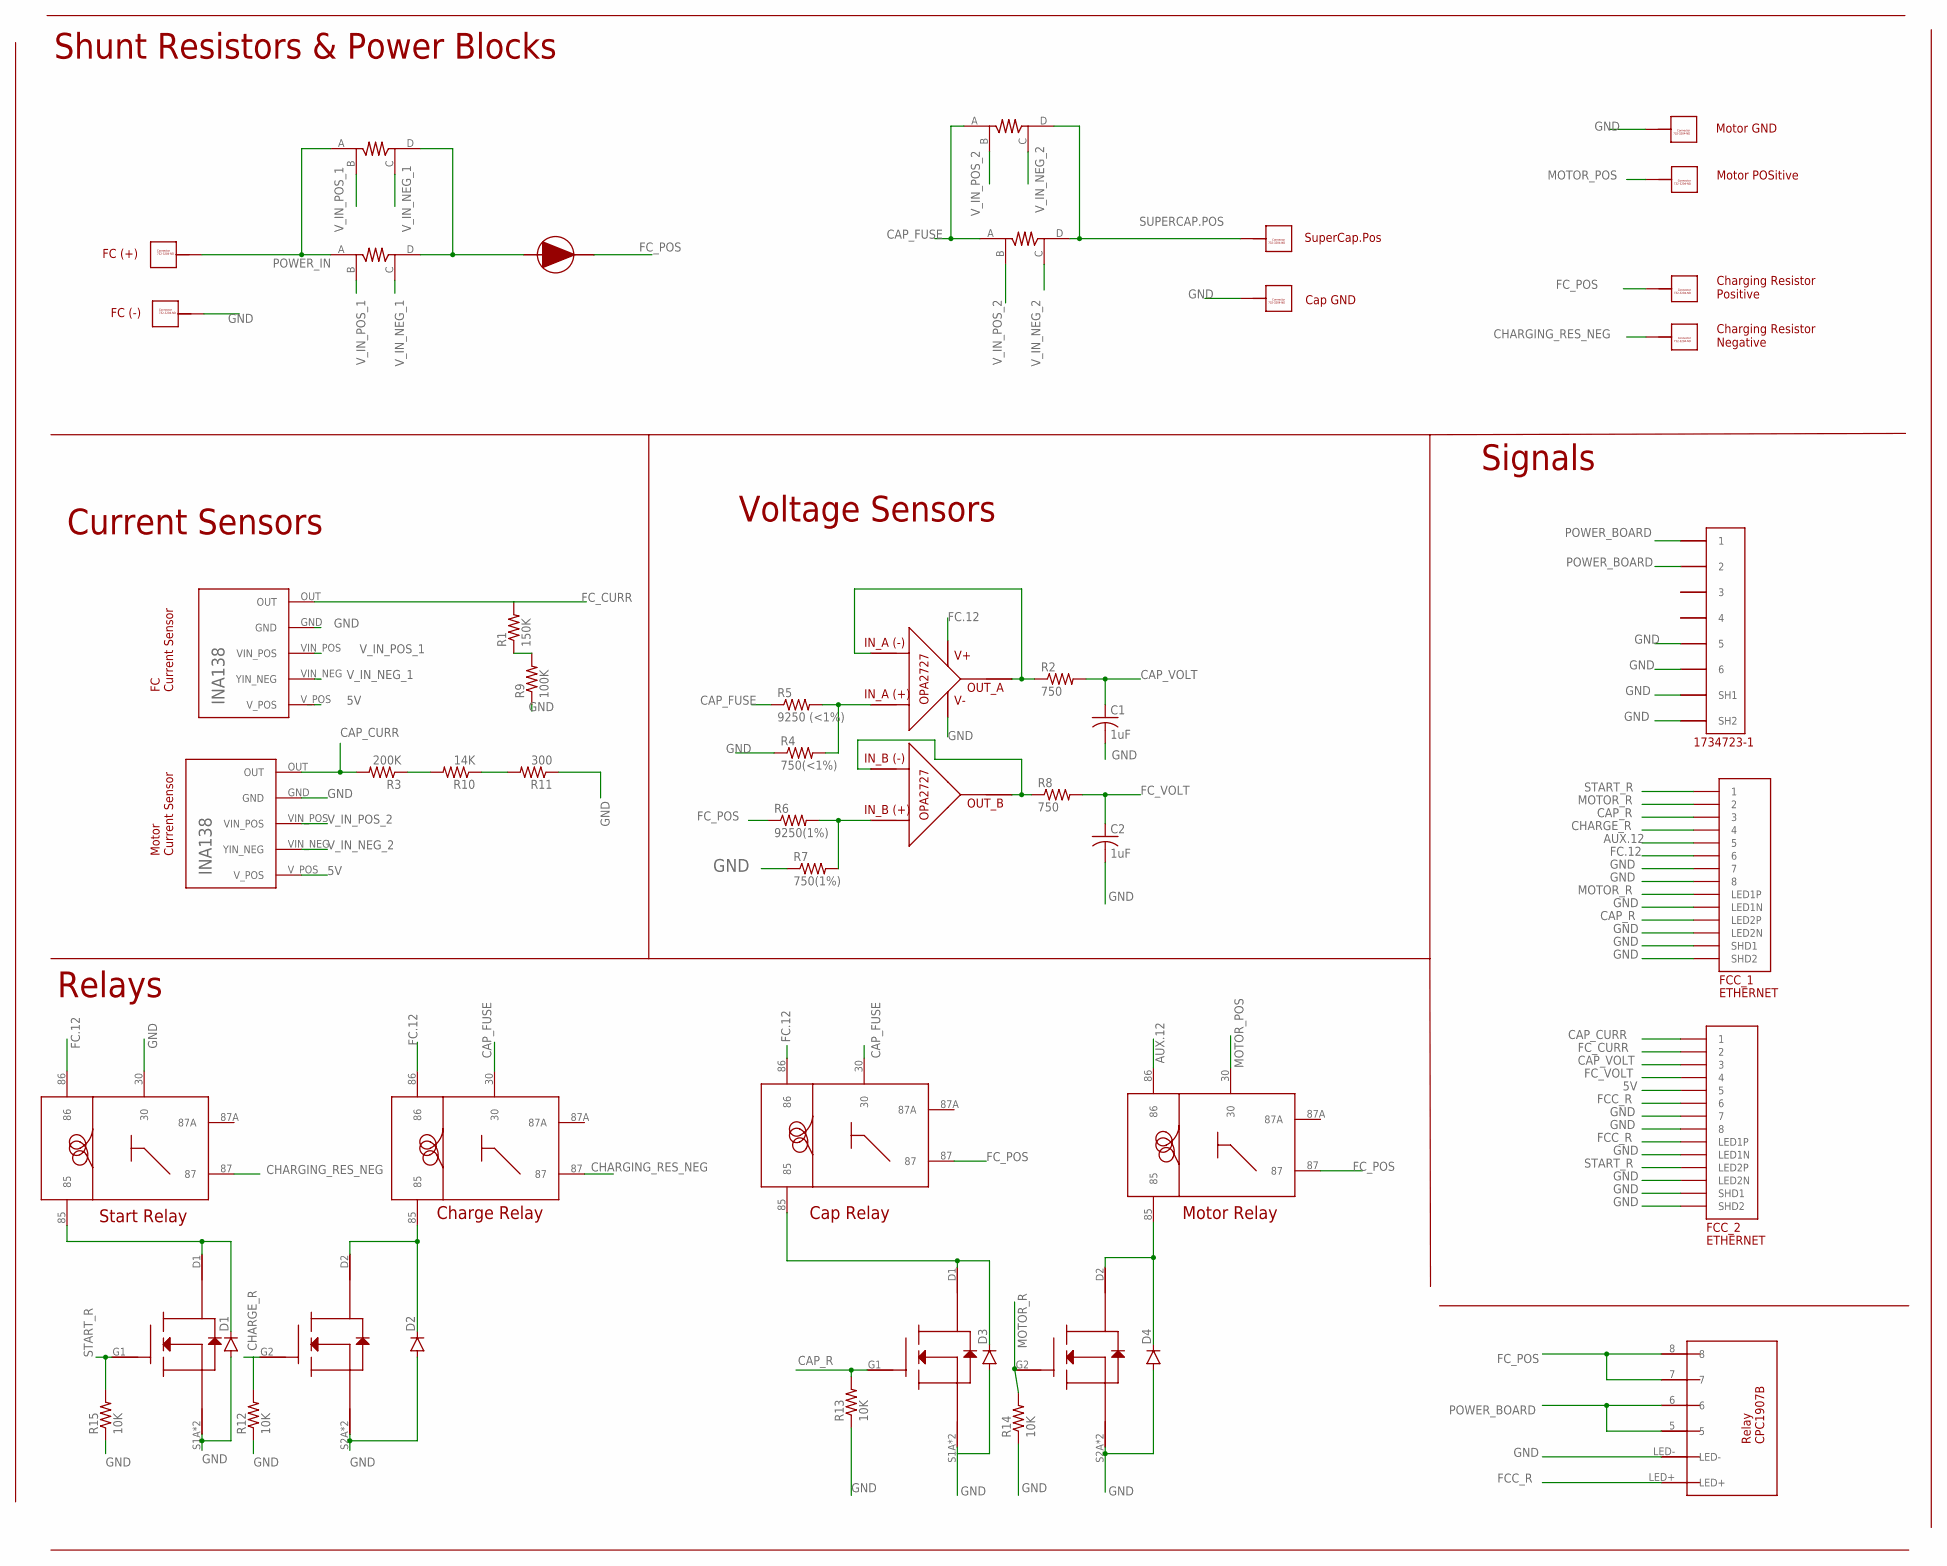
[picture p31: schematic Relay_Board_V2.sch]

Parts:
C1, C2: 1uF; C0805
CAP.GND, CAP.POS: 732-3204-ND_CONNECTOR; 732-3204-ND
CAP.RELAY: VCF4-1000
CAP.SHUNT.1, CAP.SHUNT.2: SHUNT_RESISTOR_CSM3637; CSM3637
CHARGE_RELAY: VCF4-1000
D1, D2, D3, D4: DIODESOD123; SOD-123
FC.CURR.SENSOR: TI_INA138
FC.GND, FC.POS: 732-3204-ND_CONNECTOR; 732-3204-ND
FC.SHUNT.1, FC.SHUNT.2: SHUNT_RESISTOR_CSM3637; CSM3637
FCC_1, FCC_2: ETHERNET; A122645-ND
FC_DIODE: DIODE-APT60S20BG
MOTOR.CURR.SENSOR: TI_INA138
MOTOR.GROUND, MOTOR.POSITIVE: 732-3204-ND_CONNECTOR; 732-3204-ND
MOTOR.RELAY: VCF4-1000
R1: 150K; R0805
R2, R8: 750; R0805
R3: 200K; R0805
R4: 750(<1%); R0805
R5: 9250 (<1%); R0805
R6: 9250(1%); R0805
R7: 750(1%); R0805
R9: 100K; R0805
R10: 14K; R0805
R11: 300; R0805
R12, R13, R14, R15: 10K; R0805
RES.NEG, RES.POS: 732-3204-ND_CONNECTOR; 732-3204-ND
START.RELAY: VCF4-1000
U$9, U$25: SI6926ADQ-T1-E3CT-ND_MOSFET
U$17: OP-AMP_OPA2727AIDR
U$19: 5555140-6; 1734723-1_RJ11
U$22: RELAY-CPC1907B

Connections:
5V: FC.CURR.SENSOR.V_POS, FCC_2.P$5 (5), MOTOR.CURR.SENSOR.V_POS
AUX.12: FCC_1.P$5 (5), MOTOR.RELAY.86
CAP_CURR: FCC_2.P$1 (1), MOTOR.CURR.SENSOR.OUT, R3.2
CAP_FUSE: CAP.RELAY.30, CAP.SHUNT.1.A, CAP.SHUNT.2.A, CHARGE_RELAY.30, R5.1
CAP_R: FCC_1.P$3 (3), FCC_1.P$12 (LED2P), R13.2, U$9.G1
CAP_VOLT: C1.1, FCC_2.P$3 (3), R2.2
CHARGE_R: FCC_1.P$4 (4), R12.2, U$25.G2
CHARGING_RES_NEG: CHARGE_RELAY.87, RES.NEG.P$1, RES.NEG.P$2, RES.NEG.P$3, RES.NEG.P$4, RES.NEG.P$5, RES.NEG.P$6, RES.NEG.P$7, RES.NEG.P$8, RES.NEG.P$9, RES.NEG.P$10, START.RELAY.87
FC.12: CAP.RELAY.86, CHARGE_RELAY.86, FCC_1.P$6 (6), START.RELAY.86, U$17.V+
FCC_R: FCC_2.P$6 (6), FCC_2.P$10 (LED1P), U$22.LED+
FC_CURR: FC.CURR.SENSOR.OUT, FCC_2.P$2 (2), R1.2
FC_POS: CAP.RELAY.87, FC_DIODE.CATHODE, MOTOR.RELAY.87, R6.1, RES.POS.P$1, RES.POS.P$2, RES.POS.P$3, RES.POS.P$4, RES.POS.P$5, RES.POS.P$6, RES.POS.P$7, RES.POS.P$8, RES.POS.P$9, RES.POS.P$10, U$22.7, U$22.8
FC_VOLT: C2.1, FCC_2.P$4 (4), R8.2
GND: C1.2, C2.2, CAP.GND.P$1, CAP.GND.P$2, CAP.GND.P$3, CAP.GND.P$4, CAP.GND.P$5, CAP.GND.P$6, CAP.GND.P$7, CAP.GND.P$8, CAP.GND.P$9, CAP.GND.P$10, D1.A, D2.A, D3.A, D4.A, FC.CURR.SENSOR.GND, FC.GND.P$1, FC.GND.P$2, FC.GND.P$3, FC.GND.P$4, FC.GND.P$5, FC.GND.P$6, FC.GND.P$7, FC.GND.P$8, FC.GND.P$9, FC.GND.P$10, FCC_1.P$7 (7), FCC_1.P$8 (8), FCC_1.P$9 (LED1N), FCC_1.P$11 (LED2N), FCC_1.P$13 (SHD1), FCC_1.P$14 (SHD2), FCC_2.P$7 (7), FCC_2.P$8 (8), FCC_2.P$9 (LED1N), FCC_2.P$11 (LED2N), FCC_2.P$13 (SHD1), FCC_2.P$14 (SHD2), MOTOR.CURR.SENSOR.GND, MOTOR.GROUND.P$1, MOTOR.GROUND.P$2, MOTOR.GROUND.P$3, MOTOR.GROUND.P$4, MOTOR.GROUND.P$5, MOTOR.GROUND.P$6, MOTOR.GROUND.P$7, MOTOR.GROUND.P$8, MOTOR.GROUND.P$9, MOTOR.GROUND.P$10, R4.1, R7.1, R9.1, R11.1, R12.1, R13.1, R14.1, R15.1, START.RELAY.30, U$9.S1A (S1), U$9.S1B (S1), U$9.S2A (S2), U$9.S2B (S2), U$17.V-, U$19.5, U$19.6, U$19.SH1, U$19.SH2, U$22.LED-, U$25.S1A (S1), U$25.S1B (S1), U$25.S2A (S2), U$25.S2B (S2)
MOTOR_POS: MOTOR.POSITIVE.P$1, MOTOR.POSITIVE.P$2, MOTOR.POSITIVE.P$3, MOTOR.POSITIVE.P$4, MOTOR.POSITIVE.P$5, MOTOR.POSITIVE.P$6, MOTOR.POSITIVE.P$7, MOTOR.POSITIVE.P$8, MOTOR.POSITIVE.P$9, MOTOR.POSITIVE.P$10, MOTOR.RELAY.30
MOTOR_R: FCC_1.P$2 (2), FCC_1.P$10 (LED1P), R14.2, U$9.G2
unnamed: R1.1, R9.2
unnamed: CAP.RELAY.85, D3.C, U$9.D1
unnamed: D1.C, START.RELAY.85, U$25.D1
unnamed: CHARGE_RELAY.85, D2.C, U$25.D2
unnamed: R4.2, R5.2, U$17.IN_A+
unnamed: R6.2, R7.2, U$17.IN_B+
unnamed: R8.1, U$17.IN_B-, U$17.OUT_B
unnamed: R2.1, U$17.IN_A-, U$17.OUT_A
unnamed: R3.1, R10.2
unnamed: R10.1, R11.2
unnamed: D4.C, MOTOR.RELAY.85, U$9.D2
POWER_BOARD: U$19.1, U$19.2, U$22.5, U$22.6
POWER_IN: FC.POS.P$1, FC.POS.P$2, FC.POS.P$3, FC.POS.P$4, FC.POS.P$5, FC.POS.P$6, FC.POS.P$7, FC.POS.P$8, FC.POS.P$9, FC.POS.P$10, FC.SHUNT.1.A, FC.SHUNT.2.A
SHUNT_RES_1: FC.SHUNT.1.D, FC.SHUNT.2.D, FC_DIODE.ANODE
START_R: FCC_1.P$1 (1), FCC_2.P$12 (LED2P), R15.2, U$25.G1
SUPERCAP.POS: CAP.POS.P$1, CAP.POS.P$2, CAP.POS.P$3, CAP.POS.P$4, CAP.POS.P$5, CAP.POS.P$6, CAP.POS.P$7, CAP.POS.P$8, CAP.POS.P$9, CAP.POS.P$10, CAP.SHUNT.1.D, CAP.SHUNT.2.D
V_IN_NEG_1: FC.CURR.SENSOR.VIN_NEG (YIN_NEG), FC.SHUNT.1.C, FC.SHUNT.2.C
V_IN_NEG_2: CAP.SHUNT.1.C, CAP.SHUNT.2.C, MOTOR.CURR.SENSOR.VIN_NEG (YIN_NEG)
V_IN_POS_1: FC.CURR.SENSOR.VIN_POS, FC.SHUNT.1.B, FC.SHUNT.2.B
V_IN_POS_2: CAP.SHUNT.1.B, CAP.SHUNT.2.B, MOTOR.CURR.SENSOR.VIN_POS

Notes on the sheet:
FC Current Sensor
SuperCap.Pos
Charging Resistor Positive
Charging Resistor Negative
Motor Current Sensor
FC (+)
FC (-)
Motor POSitive
Voltage Sensors
Current Sensors
Relays
Cap Relay
Charge Relay
Start Relay
Motor Relay
Motor GND
Cap GND
Shunt Resistors & Power Blocks
Signals

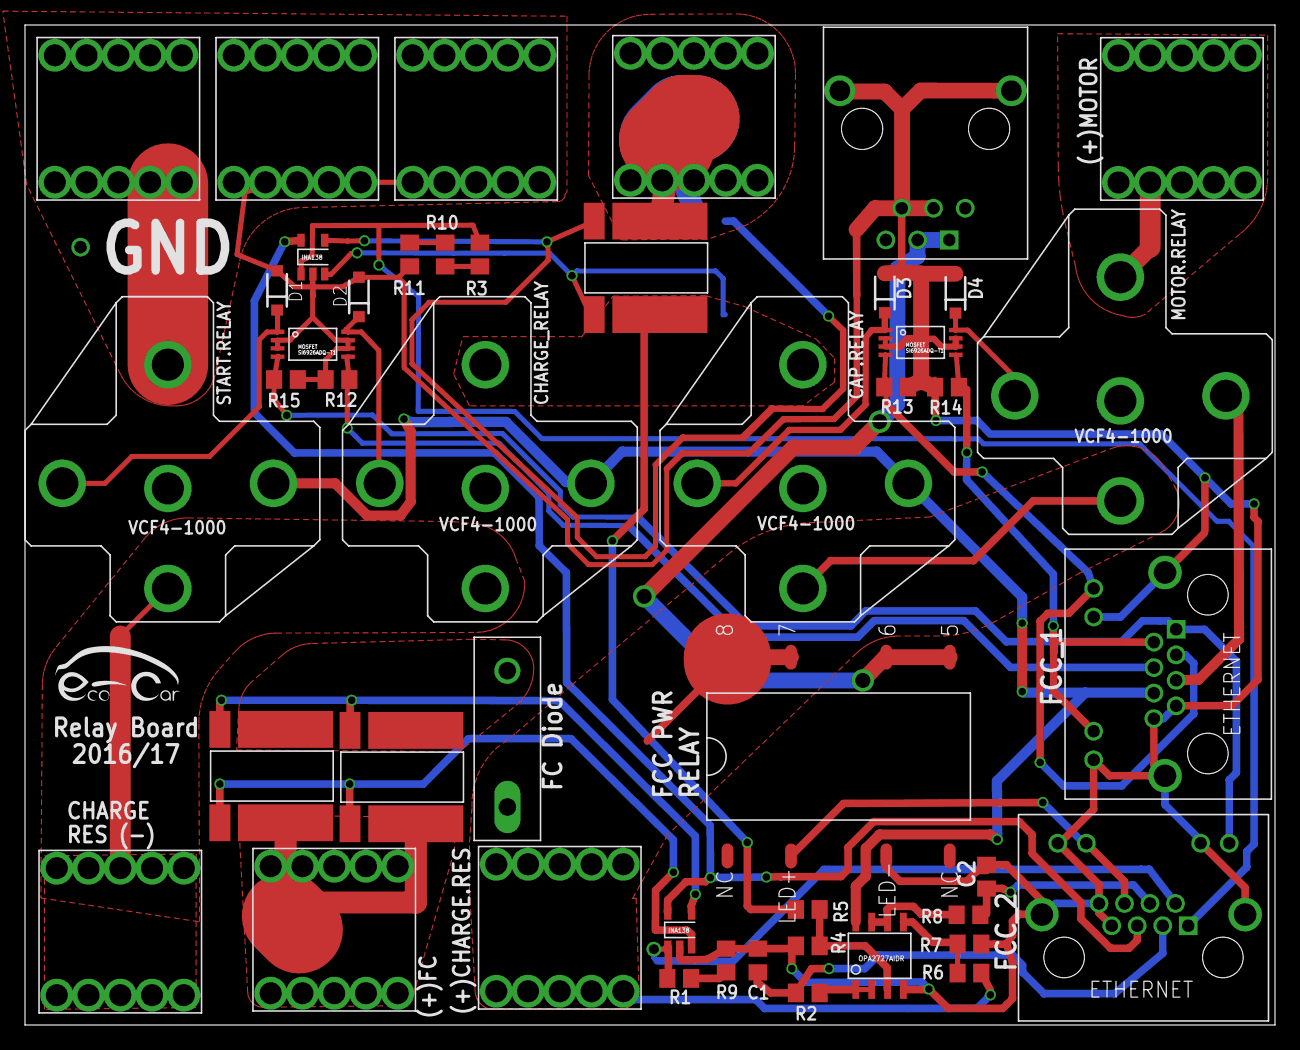
[picture p32: board Relay_Board_V2.brd from above]

Board: 2 copper layers, 100.0 x 80.0 mm, 48 parts (1 on the bottom side), 36 nets.

Other parts of the board:
U$16: LOGO
