UAlberta-EcoCar/ARCHIVED-Fuel-Cell-Controller-2016-2017/Hardware/RoboTeq Interface/motor_controller_schV2.brd

## EAGLE design Hardware/RoboTeq Interface/motor_controller_schV2.brd (2017-04-13)

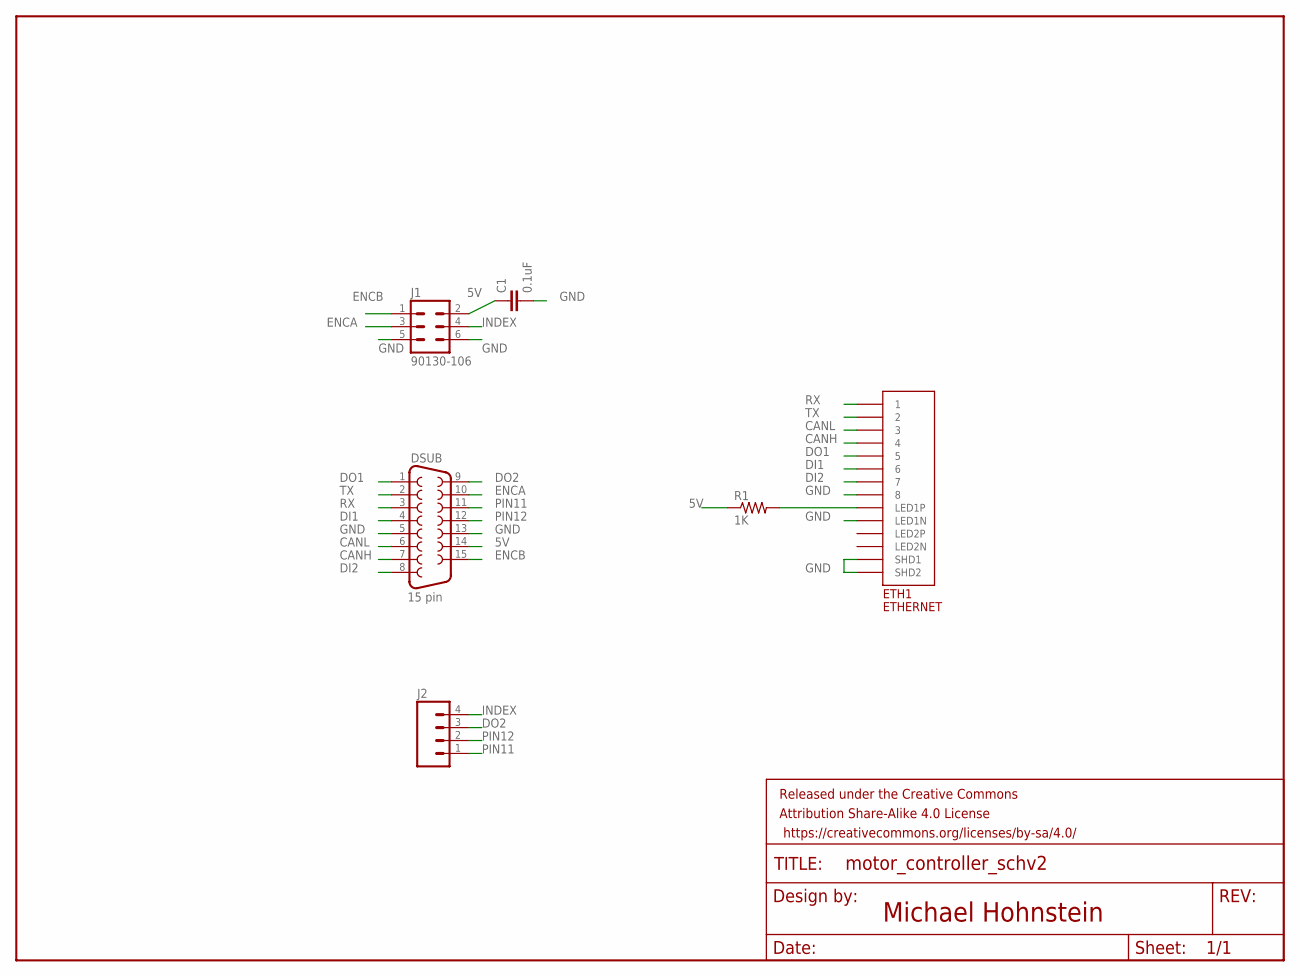
[picture p33: schematic motor_controller_schV2.sch]

Parts:
C1: 0.1uF; 0603-CAP
DSUB: 15 pin; F15HP
ETH1: ETHERNET; A122645-ND
FRAME1: FRAME-LETTER; CREATIVE_COMMONS
J1: 90130-106; 90130-1?06
J2: M04PTH; 1X04
R1: 1K; 0603-RES

Connections:
5V: C1.1, DSUB.14, J1.2, R1.1
CANH: DSUB.7, ETH1.P$4 (4)
CANL: DSUB.6, ETH1.P$3 (3)
DI1: DSUB.4, ETH1.P$6 (6)
DI2: DSUB.8, ETH1.P$7 (7)
DO1: DSUB.1, ETH1.P$5 (5)
DO2: DSUB.9, J2.3
ENCA: DSUB.10, J1.3
ENCB: DSUB.15, J1.1
GND: C1.2, DSUB.5, DSUB.13, ETH1.P$8 (8), ETH1.P$9 (LED1N), ETH1.P$13 (SHD1), ETH1.P$14 (SHD2), J1.5, J1.6
INDEX: J1.4, J2.4
unnamed: ETH1.P$10 (LED1P), R1.2
PIN11: DSUB.11, J2.1
PIN12: DSUB.12, J2.2
RX: DSUB.3, ETH1.P$1 (1)
TX: DSUB.2, ETH1.P$2 (2)

Notes on the sheet:
Michael Hohnstein

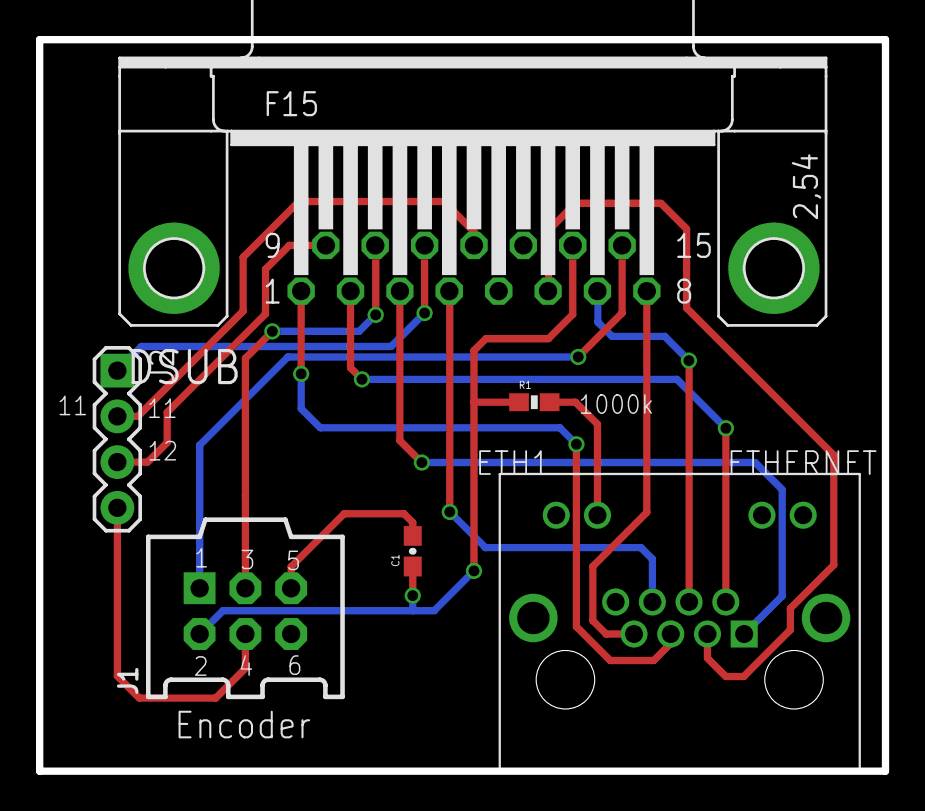
[picture p34: board motor_controller_schV2.brd from above]

Board: 2 copper layers, 47.0 x 40.6 mm, 7 parts (0 on the bottom side), 16 nets.
