UAlberta-EcoCar/ARCHIVED-Fuel-Cell-Controller-2016-2017/Hardware/CVM Board/ecocar_CVM_V2.brd

## EAGLE design Hardware/CVM Board/ecocar_CVM_V2.brd (2017-04-13)

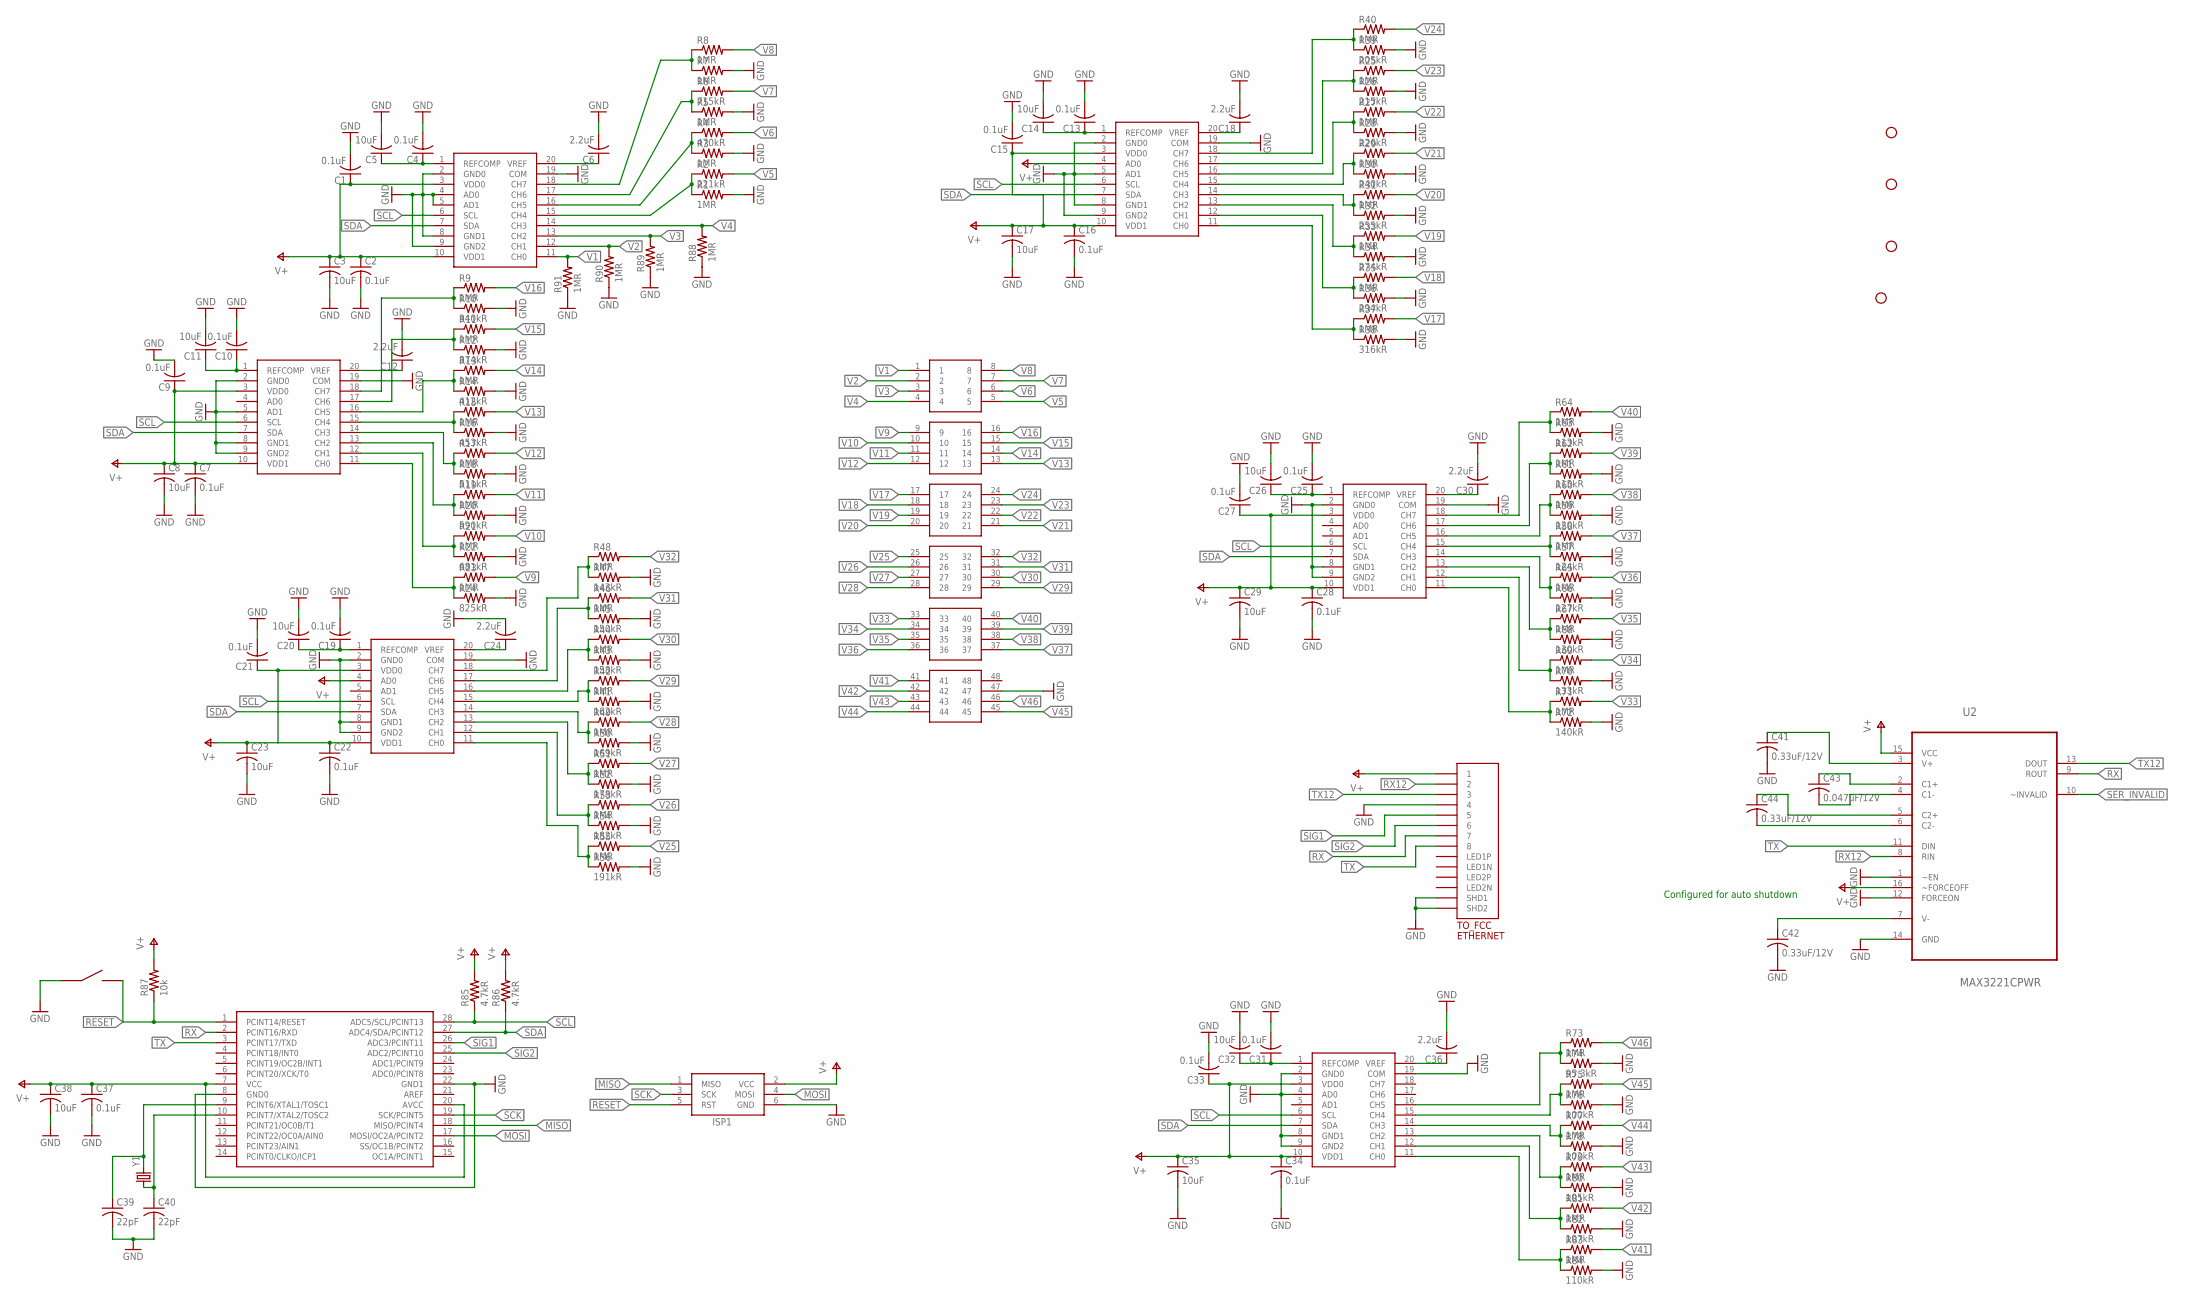
[picture p35: schematic ecocar_CVM_V2.sch]

Parts:
0001000, 0001001, 0001010, 0001011, 0011000, 0011001: LTC2309; TSSOP20
C1, C2, C4, C7, C9, C10, C13, C15, C16, C19, C21, C22, C25, C27, C28, C31, C33, C34, C37: 0.1uF; C0805
C3, C5, C8, C11, C14, C17, C20, C23, C26, C29, C32, C35, C38: 10uF; C0805
C6, C12, C18, C24, C30, C36: 2.2uF; C0805
C39, C40: 22pF; C0805
C41, C42, C44: 0.33uF/12V; C0805
C43: 0.047uF/12V; C0805
ISP1: AVRISP-BOX
R1, R3, R5, R7, R8, R9, R11, R13, R15, R17, R19, R21, R23, R25, R27, R29, R31, R33, R35, R37, R40, R42, R44, R46, R48, R49, R51, R53, R55, R58, R60, R62, R64, R65, R67, R69, R71, R73, R75, R77, R79, R81, R83, R88, R89, R90, R91: 1MR; R0805
R2: 221kR; R0805
R4: 470kR; R0805
R6: 715kR; R0805
R10: 340kR; R0805
R12: 374kR; R0805
R14: 412kR; R0805
R16: 453kR; R0805
R18: 511kR; R0805
R20: 590kR; R0805
R22: 681kR; R0805
R24: 825kR; R0805
R26: 215kR; R0805
R28: 226kR; R0805
R30: 240kR; R0805
R32: 255kR; R0805
R34: 274kR; R0805
R36: 294kR; R0805
R38: 316kR; R0805
R39: 205kR; R0805
R41: 162kR; R0805
R43: 158kR; R0805
R45: 150kR; R0805
R47: 143kR; R0805
R50: 169kR; R0805
R52: 178kR; R0805
R54: 182kR; R0805
R56: 191kR; R0805
R57: 124kR; R0805
R59: 120kR; R0805
R61: 115kR; R0805
R63: 113kR; R0805
R66: 127kR; R0805
R68: 130kR; R0805
R70: 133kR; R0805
R72: 140kR; R0805
R74: 95.3kR; R0805
R76: 100kR; R0805
R78: 102kR; R0805
R80: 105kR; R0805
R82: 107kR; R0805
R84: 110kR; R0805
R85, R86: 4.7kR; R0805
R87: 10k; R0805
RESET_BTN: EG4621CT-ND
STANDOFF1, STANDOFF2, STANDOFF3, STANDOFF4: STAND-OFF
TO_FCC: ETHERNET; A122645-ND
U2: MAX3221CPWR; SOP65P640X120-16N
U$1: ATMEGA328P; DIL28-3
U$3: 6-RJ45; 48-PIN-THROUGHHOLE
Y1: CRYSTALHC49US; HC49US

Connections:
GND: 0001000.2 (GND0), 0001000.4 (AD0), 0001000.5 (AD1), 0001000.8 (GND1), 0001000.9 (GND2), 0001000.19 (COM), 0001001.2 (GND0), 0001001.5 (AD1), 0001001.8 (GND1), 0001001.9 (GND2), 0001001.19 (COM), 0001010.2 (GND0), 0001010.5 (AD1), 0001010.8 (GND1), 0001010.9 (GND2), 0001010.19 (COM), 0001011.2 (GND0), 0001011.8 (GND1), 0001011.9 (GND2), 0001011.19 (COM), 0011000.2 (GND0), 0011000.8 (GND1), 0011000.9 (GND2), 0011000.19 (COM), 0011001.2 (GND0), 0011001.4 (AD0), 0011001.8 (GND1), 0011001.9 (GND2), 0011001.19 (COM), C1.2, C2.2, C3.2, C4.2, C5.2, C6.2, C7.2, C8.2, C9.2, C10.2, C11.2, C12.2, C13.2, C14.2, C15.2, C16.2, C17.2, C18.2, C19.2, C20.2, C21.2, C22.2, C23.2, C24.2, C25.2, C26.2, C27.2, C28.2, C29.2, C30.2, C31.2, C32.2, C33.2, C34.2, C35.2, C36.2, C37.2, C38.2, C39.2, C40.2, C41.2, C42.2, ISP1.6 (GND), R1.2, R3.2, R5.2, R7.2, R10.2, R12.2, R14.2, R16.2, R18.2, R20.2, R22.2, R24.2, R26.2, R28.2, R30.2, R32.2, R34.2, R36.2, R38.2, R39.2, R41.2, R43.2, R45.2, R47.2, R50.2, R52.2, R54.2, R56.2, R57.2, R59.2, R61.2, R63.2, R66.2, R68.2, R70.2, R72.2, R74.2, R76.2, R78.2, R80.2, R82.2, R84.2, R88.1, R89.1, R90.1, R91.1, RESET_BTN.P$1, RESET_BTN.P$2, TO_FCC.P$4 (4), TO_FCC.P$13 (SHD1), TO_FCC.P$14 (SHD2), U2.1 (~EN), U2.12 (FORCEON), U2.14 (GND), U$1.8 (GND0), U$1.22 (GND1), U$3.47
MISO: ISP1.1 (MISO), U$1.18 (MISO/PCINT4)
MOSI: ISP1.4 (MOSI), U$1.17 (MOSI/OC2A/PCINT2)
unnamed: 0001000.1 (REFCOMP), C4.1, C5.1
unnamed: 0001000.20 (VREF), C6.1
unnamed: 0001001.11 (CH0), R23.1, R24.1
unnamed: 0001001.1 (REFCOMP), C10.1, C11.1
unnamed: 0001001.20 (VREF), C12.1
unnamed: 0001001.12 (CH1), R21.1, R22.1
unnamed: 0001000.15 (CH4), R1.1, R2.1
unnamed: 0001000.16 (CH5), R3.1, R4.1
unnamed: 0001000.17 (CH6), R5.1, R6.1
unnamed: 0001000.18 (CH7), R7.1, R8.1
unnamed: 0001001.13 (CH2), R19.1, R20.1
unnamed: 0001001.14 (CH3), R17.1, R18.1
unnamed: 0001001.15 (CH4), R15.1, R16.1
unnamed: 0001001.16 (CH5), R13.1, R14.1
unnamed: 0001001.17 (CH6), R11.1, R12.1
unnamed: 0001001.18 (CH7), R9.1, R10.1
unnamed: 0001010.1 (REFCOMP), C13.1, C14.1
unnamed: 0011000.1 (REFCOMP), C25.1, C26.1
unnamed: 0001010.11 (CH0), R37.1, R38.1
unnamed: 0001010.20 (VREF), C18.1
unnamed: 0001010.12 (CH1), R35.1, R36.1
unnamed: 0001010.13 (CH2), R33.1, R34.1
unnamed: 0001010.14 (CH3), R31.1, R32.1
unnamed: 0001010.15 (CH4), R29.1, R30.1
unnamed: 0001010.16 (CH5), R27.1, R28.1
unnamed: 0001010.17 (CH6), R25.1, R26.1
unnamed: 0001010.18 (CH7), R39.1, R40.1
unnamed: 0001011.1 (REFCOMP), C19.1, C20.1
unnamed: 0011001.1 (REFCOMP), C31.1, C32.1
unnamed: 0011001.20 (VREF), C36.1
unnamed: 0001011.20 (VREF), C24.1
unnamed: 0001011.11 (CH0), R55.1, R56.1
unnamed: 0001011.12 (CH1), R53.1, R54.1
unnamed: 0001011.13 (CH2), R51.1, R52.1
unnamed: 0001011.14 (CH3), R49.1, R50.1
unnamed: 0001011.15 (CH4), R41.1, R42.1
unnamed: 0001011.16 (CH5), R43.1, R44.1
unnamed: 0001011.17 (CH6), R45.1, R46.1
unnamed: 0001011.18 (CH7), R47.1, R48.1
unnamed: 0011000.20 (VREF), C30.1
unnamed: 0011000.11 (CH0), R71.1, R72.1
unnamed: 0011000.12 (CH1), R69.1, R70.1
unnamed: 0011000.13 (CH2), R67.1, R68.1
unnamed: 0011000.14 (CH3), R65.1, R66.1
unnamed: 0011000.15 (CH4), R57.1, R58.1
unnamed: 0011000.16 (CH5), R59.1, R60.1
unnamed: 0011000.17 (CH6), R61.1, R62.1
unnamed: 0011000.18 (CH7), R63.1, R64.1
unnamed: C39.1, U$1.9 (PCINT6/XTAL1/TOSC1), Y1.2
unnamed: C40.1, U$1.10 (PCINT7/XTAL2/TOSC2), Y1.1
unnamed: 0011001.11 (CH0), R83.1, R84.1
unnamed: 0011001.12 (CH1), R81.1, R82.1
unnamed: 0011001.13 (CH2), R79.1, R80.1
unnamed: 0011001.14 (CH3), R77.1, R78.1
unnamed: 0011001.15 (CH4), R75.1, R76.1
unnamed: 0011001.16 (CH5), R73.1, R74.1
unnamed: C41.1, U2.3 (V+)
unnamed: C43.1, U2.2 (C1+)
unnamed: C43.2, U2.4 (C1-)
unnamed: C44.1, U2.5 (C2+)
unnamed: C44.2, U2.6 (C2-)
unnamed: C42.1, U2.7 (V-)
RESET: ISP1.5 (RST), R87.1, RESET_BTN.P$3, RESET_BTN.P$4, U$1.1 (PCINT14/RESET)
RX: TO_FCC.P$7 (7), U2.9 (ROUT), U$1.2 (PCINT16/RXD)
RX12: TO_FCC.P$2 (2), U2.8 (RIN)
SCK: ISP1.3 (SCK), U$1.19 (SCK/PCINT5)
SCL: 0001000.6 (SCL), 0001001.6 (SCL), 0001010.6 (SCL), 0001011.6 (SCL), 0011000.6 (SCL), 0011001.6 (SCL), R85.1, U$1.28 (ADC5/SCL/PCINT13)
SDA: 0001000.7 (SDA), 0001001.7 (SDA), 0001010.7 (SDA), 0001011.7 (SDA), 0011000.7 (SDA), 0011001.7 (SDA), R86.1, U$1.27 (ADC4/SDA/PCINT12)
SER_INVALID: U2.10 (~INVALID)
SIG1: TO_FCC.P$5 (5), U$1.26 (ADC3/PCINT11)
SIG2: TO_FCC.P$6 (6), U$1.25 (ADC2/PCINT10)
TX: TO_FCC.P$8 (8), U2.11 (DIN), U$1.3 (PCINT17/TXD)
TX12: TO_FCC.P$3 (3), U2.13 (DOUT)
V1: 0001000.11 (CH0), R91.2, U$3.1
V2: 0001000.12 (CH1), R90.2, U$3.2
V3: 0001000.13 (CH2), R89.2, U$3.3
V4: 0001000.14 (CH3), R88.2, U$3.4
V5: R2.2, U$3.5
V6: R4.2, U$3.6
V7: R6.2, U$3.7
V8: R8.2, U$3.8
V9: R23.2, U$3.9
V10: R21.2, U$3.10
V11: R19.2, U$3.11
V12: R17.2, U$3.12
V13: R15.2, U$3.13
V14: R13.2, U$3.14
V15: R11.2, U$3.15
V16: R9.2, U$3.16
V17: R37.2, U$3.17
V18: R35.2, U$3.18
V19: R33.2, U$3.19
V20: R31.2, U$3.20
V21: R29.2, U$3.21
V22: R27.2, U$3.22
V23: R25.2, U$3.23
V24: R40.2, U$3.24
V25: R55.2, U$3.25
V26: R53.2, U$3.26
V27: R51.2, U$3.27
V28: R49.2, U$3.28
V29: R42.2, U$3.29
V30: R44.2, U$3.30
V31: R46.2, U$3.31
V32: R48.2, U$3.32
V33: R71.2, U$3.33
V34: R69.2, U$3.34
V35: R67.2, U$3.35
V36: R65.2, U$3.36
V37: R58.2, U$3.37
V38: R60.2, U$3.38
V39: R62.2, U$3.39
V40: R64.2, U$3.40
V41: R83.2, U$3.41
V42: R81.2, U$3.42
V43: R79.2, U$3.43
V44: R77.2, U$3.44
V45: R75.2, U$3.45
V46: R73.2, U$3.46
V+: 0001000.3 (VDD0), 0001000.10 (VDD1), 0001001.3 (VDD0), 0001001.10 (VDD1), 0001010.3 (VDD0), 0001010.4 (AD0), 0001010.10 (VDD1), 0001011.3 (VDD0), 0001011.4 (AD0), 0001011.10 (VDD1), 0011000.3 (VDD0), 0011000.10 (VDD1), 0011001.3 (VDD0), 0011001.10 (VDD1), C1.1, C2.1, C3.1, C7.1, C8.1, C9.1, C15.1, C16.1, C17.1, C21.1, C22.1, C23.1, C27.1, C28.1, C29.1, C33.1, C34.1, C35.1, C37.1, C38.1, ISP1.2 (VCC), R85.2, R86.2, R87.2, TO_FCC.P$1 (1), U2.15 (VCC), U2.16 (~FORCEOFF), U$1.7 (VCC), U$1.20 (AVCC)

Notes on the sheet:
Configured for auto shutdown

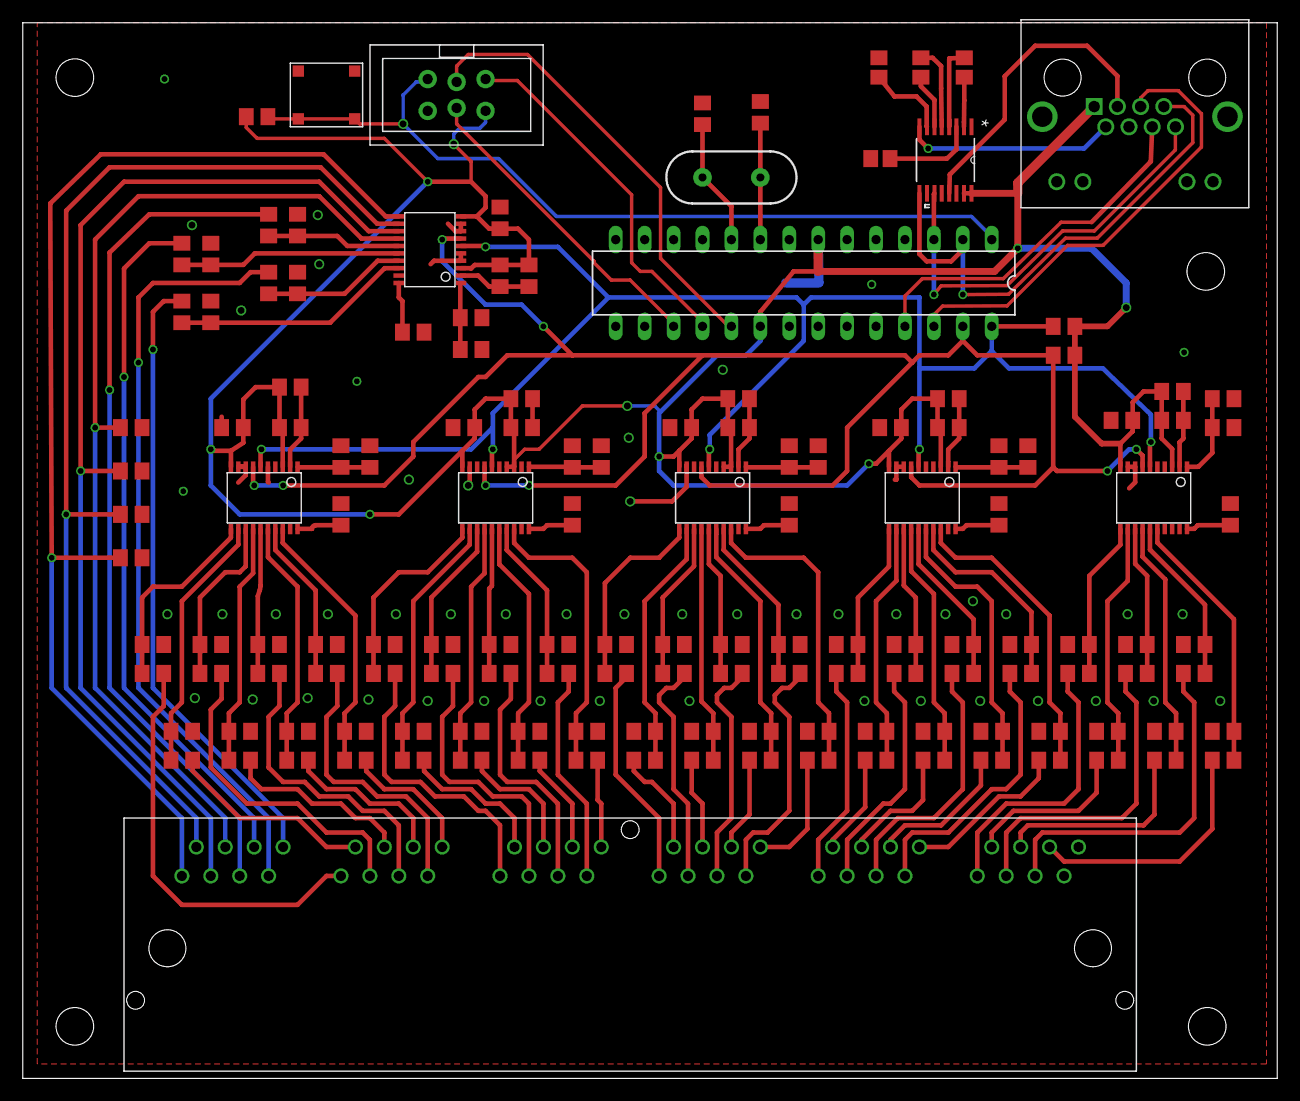
[picture p36: board ecocar_CVM_V2.brd from above]

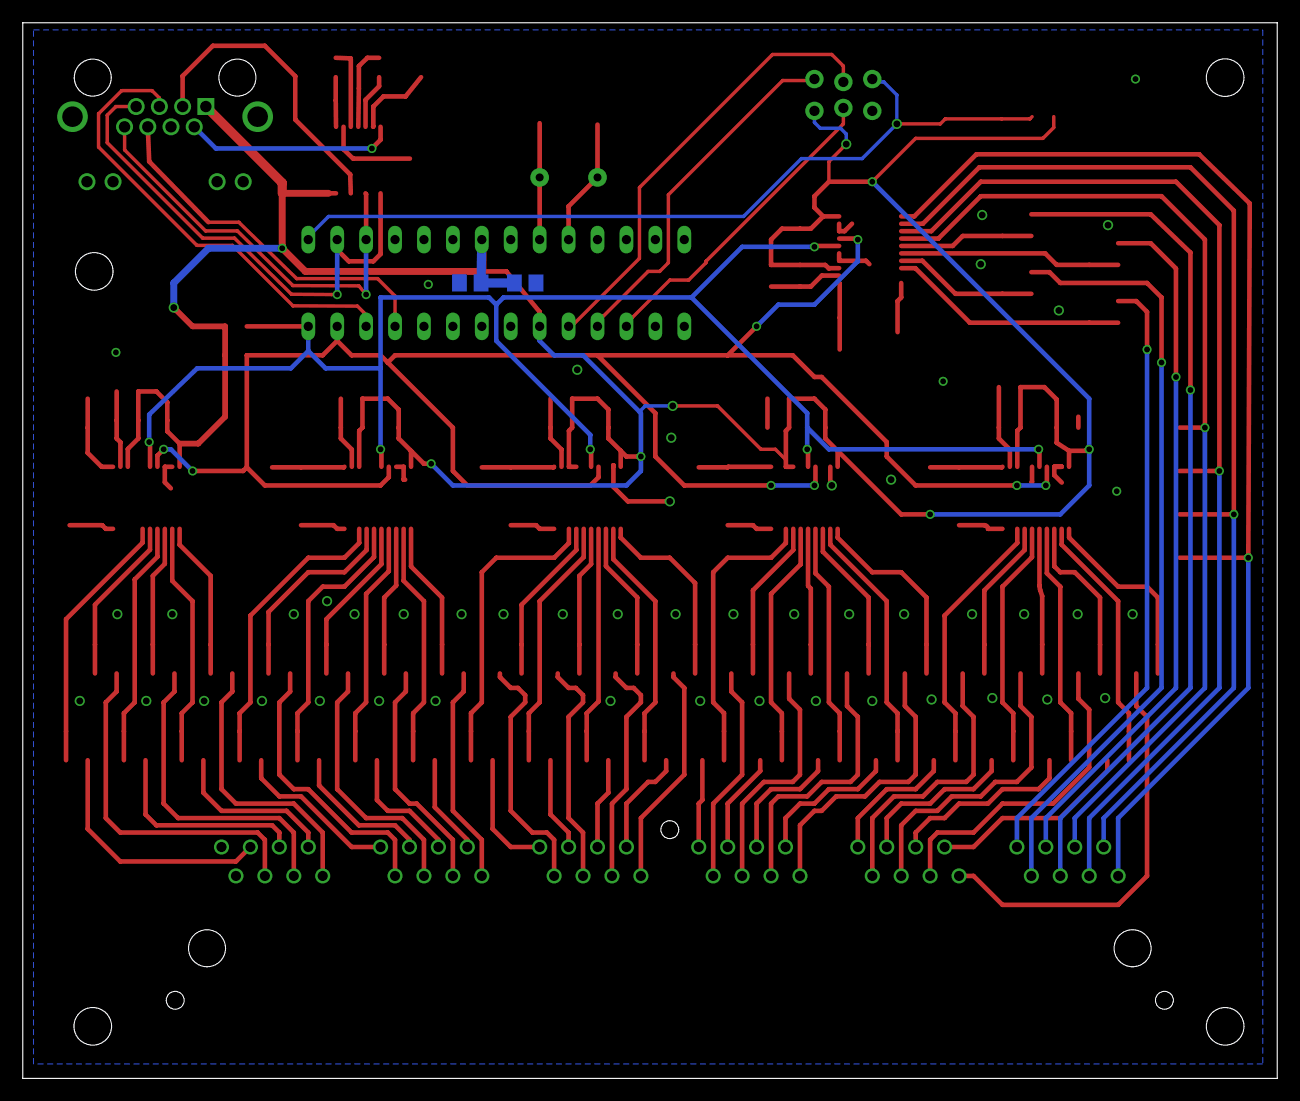
[picture p37: board ecocar_CVM_V2.brd from below]

Board: 2 copper layers, 110.2 x 92.7 mm, 152 parts (2 on the bottom side), 122 nets.
