UAlberta-EcoCar/ARCHIVED-Fuel-Cell-Controller-2016-2017/Hardware/FCC Power Board/E-P-204-R3.brd

## EAGLE design Hardware/FCC Power Board/E-P-204-R3.brd (2017-01-29)

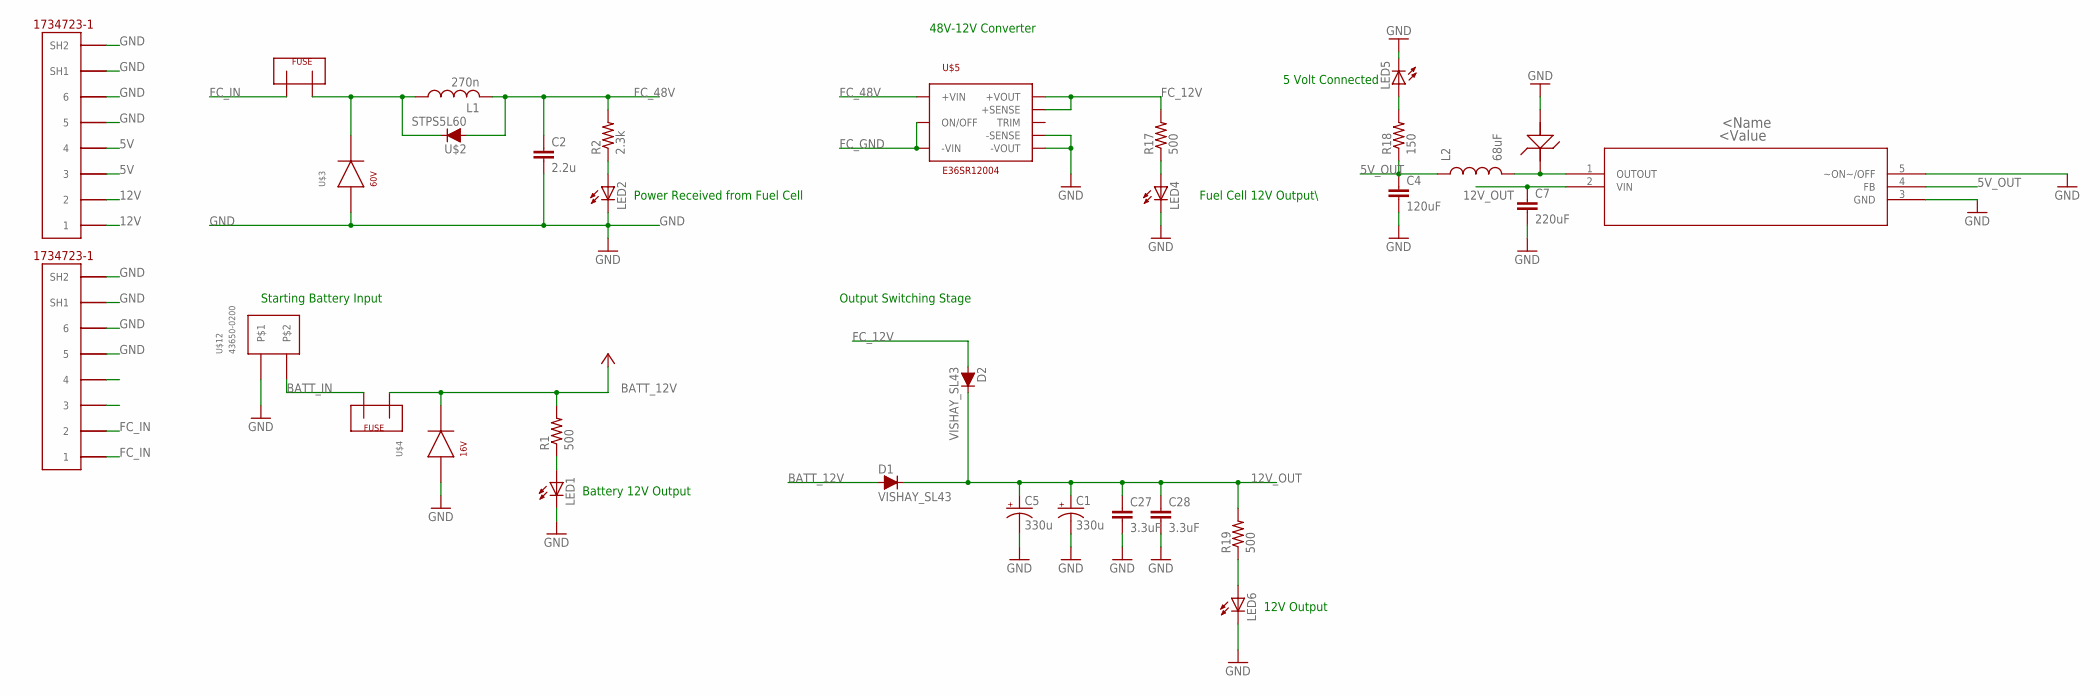
[picture p38: schematic E-P-204-R3.sch]

Parts:
C1, C5: 330u; PANASONIC_E
C2: 2.2u; C1210
C4: 120uF; 0805
C7: 220uF; 0805
C27, C28: 3.3uF; C0805K
D1, D2: VISHAY_SL43; DO-214AB_SMC
L1: 270n; L3225P
L2: 68uF; 0805
LED1, LED2, LED4, LED5, LED6: LED1206; LED-1206
R1, R17, R19: 500; M0805
R2: 2.3k; M0805
R18: 150; M0805
U$2: STPS5L60; STM_SMC
U$3: SMBJ60CA; .277X.089
U$4: SMAJ16CA; .25X.07
U$5: E36SR12004; 2.30X0.90X0.34
U$6, U$11: 5555140-6; 1734723-1_RJ11
U$7, U$10: FUSEMINI-BLADE; MINI-BLADE-FUSE
U$8: LM2595T-5.0; T05D
U$9: MURS120T3G
U$12: 43650-0200

Connections:
5V: U$11.3, U$11.4
5V_OUT: C4.1, L2.1, R18.1, U$8.4 (FB)
12V: U$11.1, U$11.2
12V_OUT: C1.+, C5.+, C7.1, C27.1, C28.1, D1.C, D2.C, R19.2, U$8.2 (VIN)
BATT_12V: D1.A, R1.2, U$4.CATHODE, U$10.OUT
BATT_IN: U$10.IN, U$12.P$1
FC_12V: D2.A, R17.2, U$5.P$7 (+SENSE), U$5.P$8 (+VOUT)
FC_48V: C2.1, L1.2, R2.2, U$2.A, U$5.P$1 (+VIN)
FC_FUSED: L1.1, U$2.C, U$3.CATHODE, U$7.IN
FC_GND: U$5.P$2 (ON/OFF), U$5.P$3 (-VIN)
FC_IN: U$6.1, U$6.2, U$7.OUT
GND: C1.-, C2.2, C4.2, C5.-, C7.2, C27.2, C28.2, LED1.C, LED2.C, LED4.C, LED5.C, LED6.C, U$3.ANODE, U$4.ANODE, U$5.P$4 (-VOUT), U$5.P$5 (-SENSE), U$6.5, U$6.6, U$6.SH1, U$6.SH2, U$8.3 (GND), U$8.5 (~ON~/OFF), U$9.P$2 (PIN1), U$11.5, U$11.6, U$11.SH1, U$11.SH2, U$12.P$2
unnamed: LED1.A, R1.1
unnamed: LED2.A, R2.1
unnamed: L2.2, U$8.1 (OUTOUT), U$9.P$1
unnamed: LED5.A, R18.2
unnamed: LED4.A, R17.1
unnamed: LED6.A, R19.1

Notes on the sheet:
Output Switching Stage
Starting Battery Input
48V-12V Converter
Power Received from Fuel Cell
Battery 12V Output
Fuel Cell 12V Output\
12V Output
5 Volt Connected

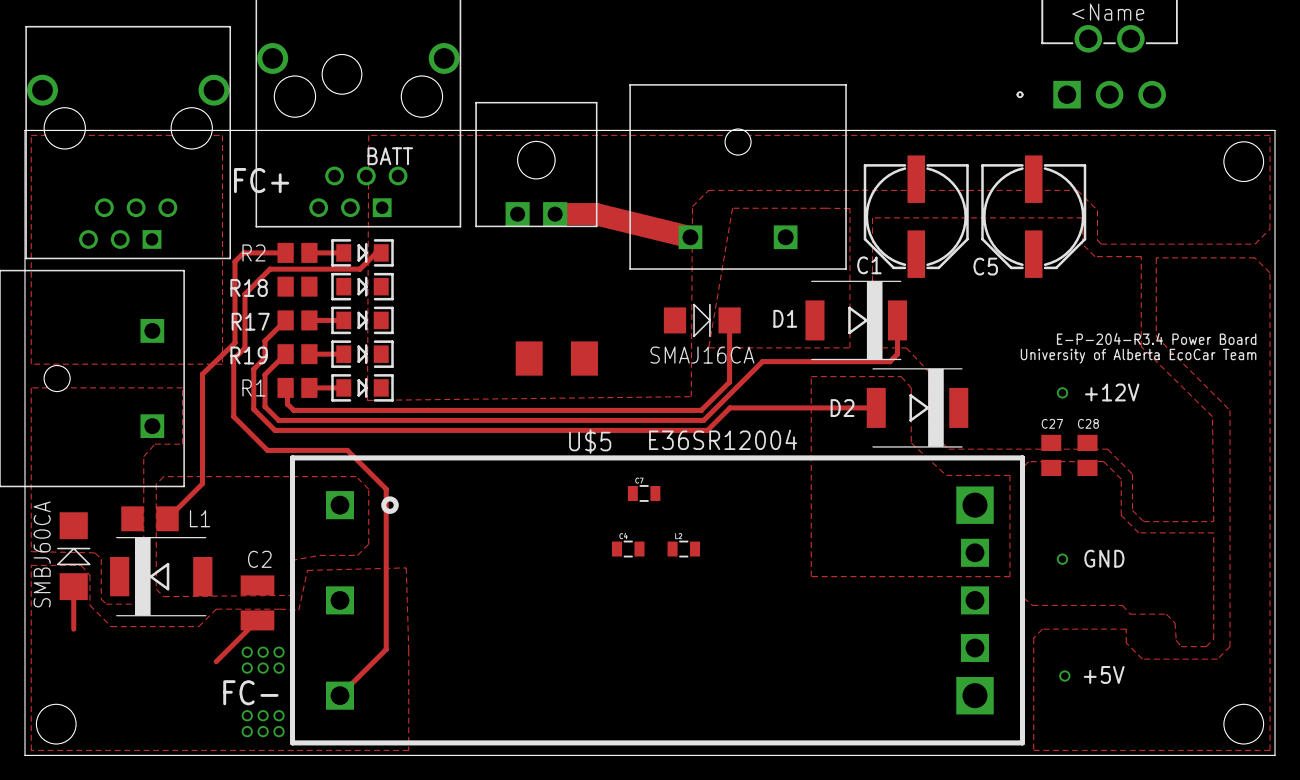
[picture p39: board E-P-204-R3.brd from above]

Board: 2 copper layers, 100.0 x 50.0 mm, 32 parts (0 on the bottom side), 18 nets.
