UAlberta-EcoCar/ARCHIVED-Fuel-Cell-Controller-2016-2017/Hardware/RoboTeq Interface/motor_controller_sch.brd

## EAGLE design Hardware/RoboTeq Interface/motor_controller_sch.brd (2017-01-28, an earlier design)

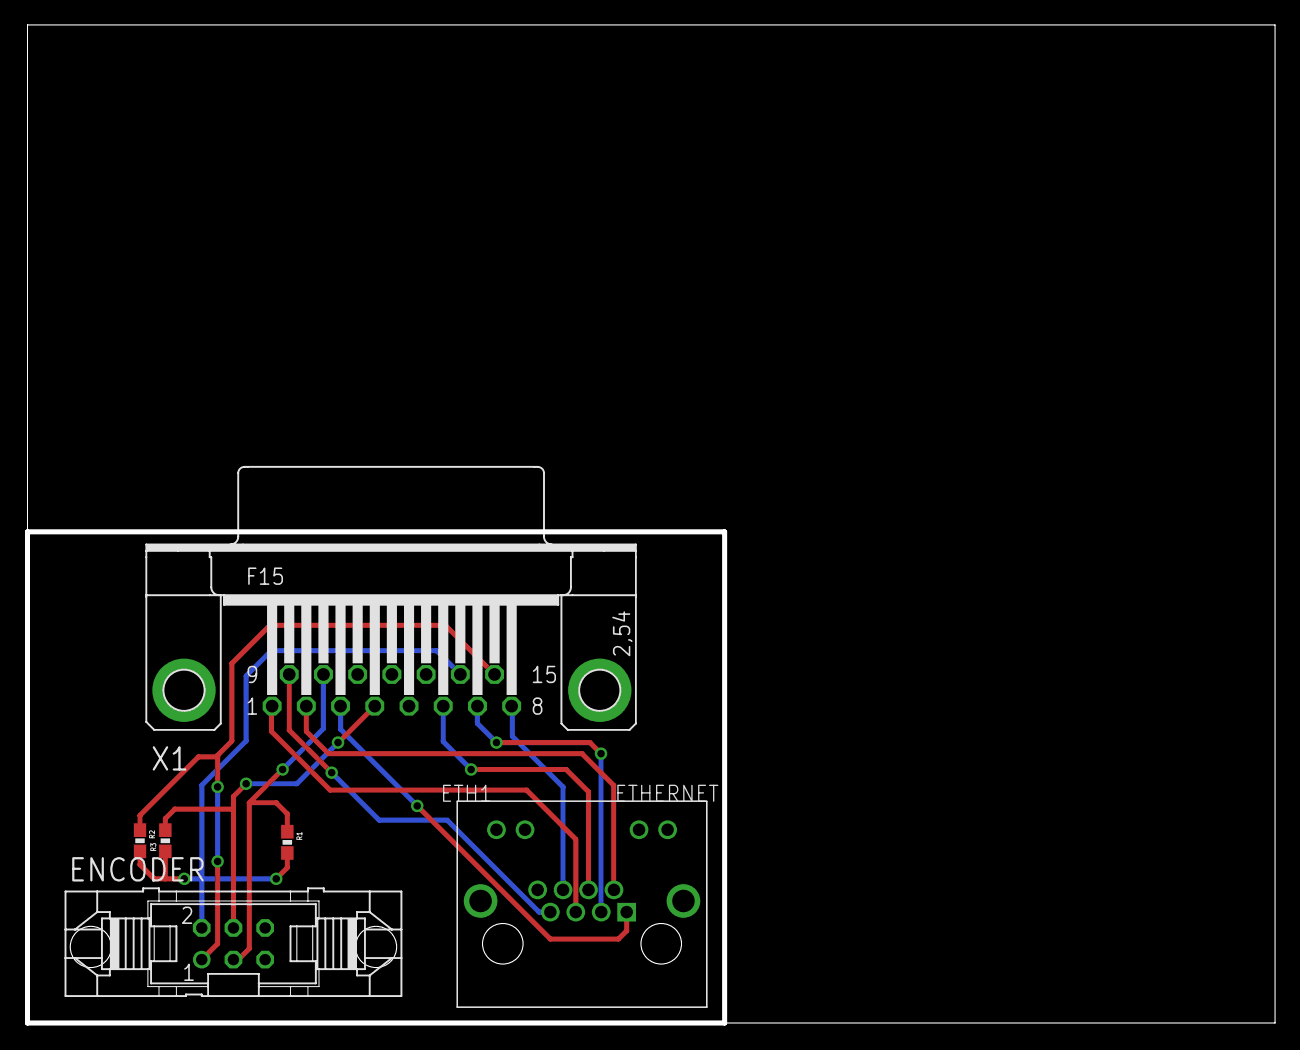
[picture p40: board motor_controller_sch.brd from above]

Board: 2 copper layers, 100.0 x 80.0 mm, 6 parts (0 on the bottom side), 12 nets.

Parts:
ENCODER: 06V
ETH1: ETHERNET; A122645-ND
R1, R2, R3: 3.3k; 0603-RES
X1: F15HP

Connections:
5V: ENCODER.2, R1.2, R2.2, R3.1, X1.14
CANH: ETH1.P$4, X1.6
CANL: ETH1.P$3, X1.7
DI1: ETH1.P$6, X1.8
DI2: ETH1.P$7, X1.9
DO1: ETH1.P$5, X1.1
ENCA: ENCODER.3, R1.1, X1.10
ENCB: ENCODER.1, R2.1, X1.15
GND: ENCODER.5, ENCODER.6, X1.5, X1.13
INDEX: ENCODER.4, R3.2, X1.4
RX: ETH1.P$1, X1.3
TX: ETH1.P$2, X1.2
