UAlberta-EcoCar/ARCHIVED-Fuel-Cell-Controller-2016-2017/Relay Board/Relay_Board.brd

## EAGLE design Relay Board/Relay_Board.brd (2017-01-06, an earlier design)

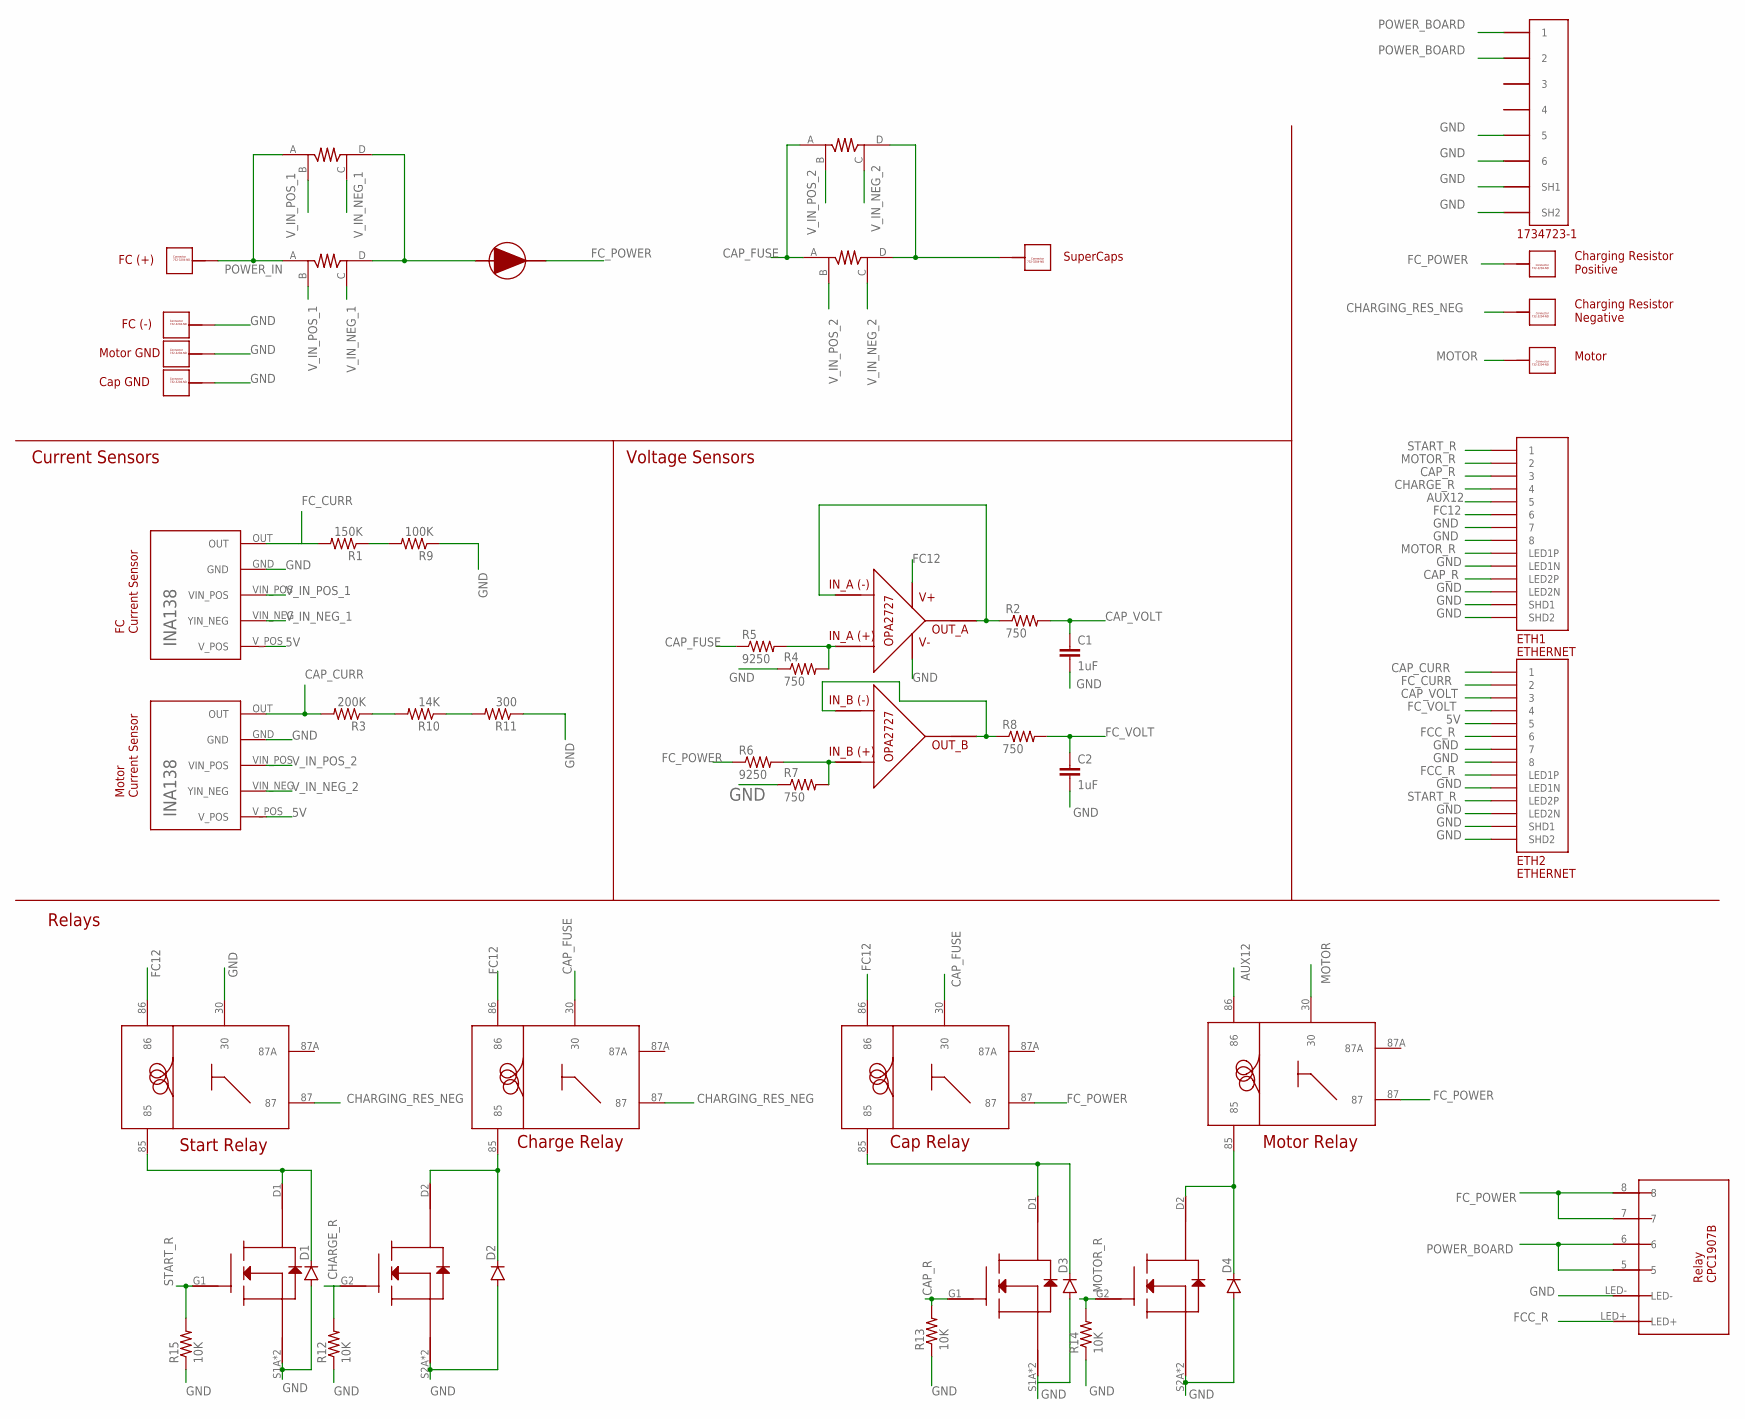
[picture p41: schematic Relay_Board.sch]

Parts:
C1, C2: 1uF; 0402-CAP
D1, D2, D3, D4: DIODESOD123; SOD-123
ETH1, ETH2: ETHERNET; A122645-ND
R1: 150K; 1206
R2, R4, R7, R8: 750; 1206
R3: 200K; 1206
R5, R6: 9250; 1206
R9: 100K; 1206
R10: 14K; 1206
R11: 300; 1206
R12, R13, R14, R15: 10K; 0603-RES
U$1, U$2, U$10, U$13, U$14, U$20, U$23, U$24: 732-3204-ND_CONNECTOR; 732-3204-ND
U$3, U$7: TI_INA138
U$4, U$6, U$12, U$21: SHUNT_RESISTOR_CSM3637; CSM3637
U$5: DIODE-APT60S20BG
U$8, U$11, U$15, U$18: VCF4-1000
U$9, U$25: SI6926ADQ-T1-E3CT-ND_MOSFET
U$17: OP-AMP_OPA2727AIDR
U$19: 5555140-6; 1734723-1_RJ11
U$22: RELAY-CPC1907B

Connections:
5V: ETH2.P$5 (5), U$3.V_POS, U$7.V_POS
AUX12: ETH1.P$5 (5), U$18.86
CAP_CURR: ETH2.P$1 (1), R3.2, U$3.OUT
CAP_FUSE: R5.1, U$8.30, U$11.30, U$12.A, U$21.A
CAP_R: ETH1.P$3 (3), ETH1.P$12 (LED2P), R13.2, U$9.G1
CAP_VOLT: C1.1, ETH2.P$3 (3), R2.2
CHARGE_R: ETH1.P$4 (4), R12.2, U$25.G2
CHARGING_RES_NEG: U$11.87, U$14.P$1, U$14.P$2, U$14.P$3, U$14.P$4, U$14.P$5, U$14.P$6, U$14.P$7, U$14.P$8, U$14.P$9, U$14.P$10, U$15.87
FC12: ETH1.P$6 (6), U$8.86, U$11.86, U$15.86, U$17.V+
FCC_R: ETH2.P$6 (6), ETH2.P$10 (LED1P), U$22.LED+
FC_CURR: ETH2.P$2 (2), R1.2, U$7.OUT
FC_POWER: R6.1, U$5.CATHODE, U$8.87, U$13.P$1, U$13.P$2, U$13.P$3, U$13.P$4, U$13.P$5, U$13.P$6, U$13.P$7, U$13.P$8, U$13.P$9, U$13.P$10, U$18.87, U$22.7, U$22.8
FC_VOLT: C2.1, ETH2.P$4 (4), R8.2
GND: C1.2, C2.2, D1.A, D2.A, D3.A, D4.A, ETH1.P$7 (7), ETH1.P$8 (8), ETH1.P$9 (LED1N), ETH1.P$11 (LED2N), ETH1.P$13 (SHD1), ETH1.P$14 (SHD2), ETH2.P$7 (7), ETH2.P$8 (8), ETH2.P$9 (LED1N), ETH2.P$11 (LED2N), ETH2.P$13 (SHD1), ETH2.P$14 (SHD2), R4.1, R7.1, R9.1, R11.1, R12.1, R13.1, R14.1, R15.1, U$2.P$1, U$2.P$2, U$2.P$3, U$2.P$4, U$2.P$5, U$2.P$6, U$2.P$7, U$2.P$8, U$2.P$9, U$2.P$10, U$3.GND, U$7.GND, U$9.S1A (S1), U$9.S1B (S1), U$9.S2A (S2), U$9.S2B (S2), U$15.30, U$17.V-, U$19.5, U$19.6, U$19.SH1, U$19.SH2, U$22.LED-, U$23.P$1, U$23.P$2, U$23.P$3, U$23.P$4, U$23.P$5, U$23.P$6, U$23.P$7, U$23.P$8, U$23.P$9, U$23.P$10, U$24.P$1, U$24.P$2, U$24.P$3, U$24.P$4, U$24.P$5, U$24.P$6, U$24.P$7, U$24.P$8, U$24.P$9, U$24.P$10, U$25.S1A (S1), U$25.S1B (S1), U$25.S2A (S2), U$25.S2B (S2)
MOTOR: U$18.30, U$20.P$1, U$20.P$2, U$20.P$3, U$20.P$4, U$20.P$5, U$20.P$6, U$20.P$7, U$20.P$8, U$20.P$9, U$20.P$10
MOTOR_R: ETH1.P$2 (2), ETH1.P$10 (LED1P), R14.2, U$9.G2
unnamed: R1.1, R9.2
unnamed: D3.C, U$8.85, U$9.D1
unnamed: D1.C, U$15.85, U$25.D1
unnamed: D2.C, U$11.85, U$25.D2
unnamed: R4.2, R5.2, U$17.IN_A+
unnamed: R6.2, R7.2, U$17.IN_B+
unnamed: R8.1, U$17.IN_B-, U$17.OUT_B
unnamed: R2.1, U$17.IN_A-, U$17.OUT_A
unnamed: R3.1, R10.2
unnamed: R10.1, R11.2
unnamed: D4.C, U$9.D2, U$18.85
POWER_BOARD: U$19.1, U$19.2, U$22.5, U$22.6
POWER_IN: U$1.P$1, U$1.P$2, U$1.P$3, U$1.P$4, U$1.P$5, U$1.P$6, U$1.P$7, U$1.P$8, U$1.P$9, U$1.P$10, U$4.A, U$6.A
SHUNT_RES_1: U$4.D, U$5.ANODE, U$6.D
START_R: ETH1.P$1 (1), ETH2.P$12 (LED2P), R15.2, U$25.G1
SUPERCAPS: U$10.P$1, U$10.P$2, U$10.P$3, U$10.P$4, U$10.P$5, U$10.P$6, U$10.P$7, U$10.P$8, U$10.P$9, U$10.P$10, U$12.D, U$21.D
V_IN_NEG_1: U$4.C, U$6.C, U$7.VIN_NEG (YIN_NEG)
V_IN_NEG_2: U$3.VIN_NEG (YIN_NEG), U$12.C, U$21.C
V_IN_POS_1: U$4.B, U$6.B, U$7.VIN_POS
V_IN_POS_2: U$3.VIN_POS, U$12.B, U$21.B

Notes on the sheet:
FC Current Sensor
SuperCaps
Charging Resistor Positive
Charging Resistor Negative
Motor Current Sensor
FC (+)
FC (-)
Motor
Voltage Sensors
Current Sensors
Relays
Cap Relay
Charge Relay
Start Relay
Motor Relay
Motor GND
Cap GND

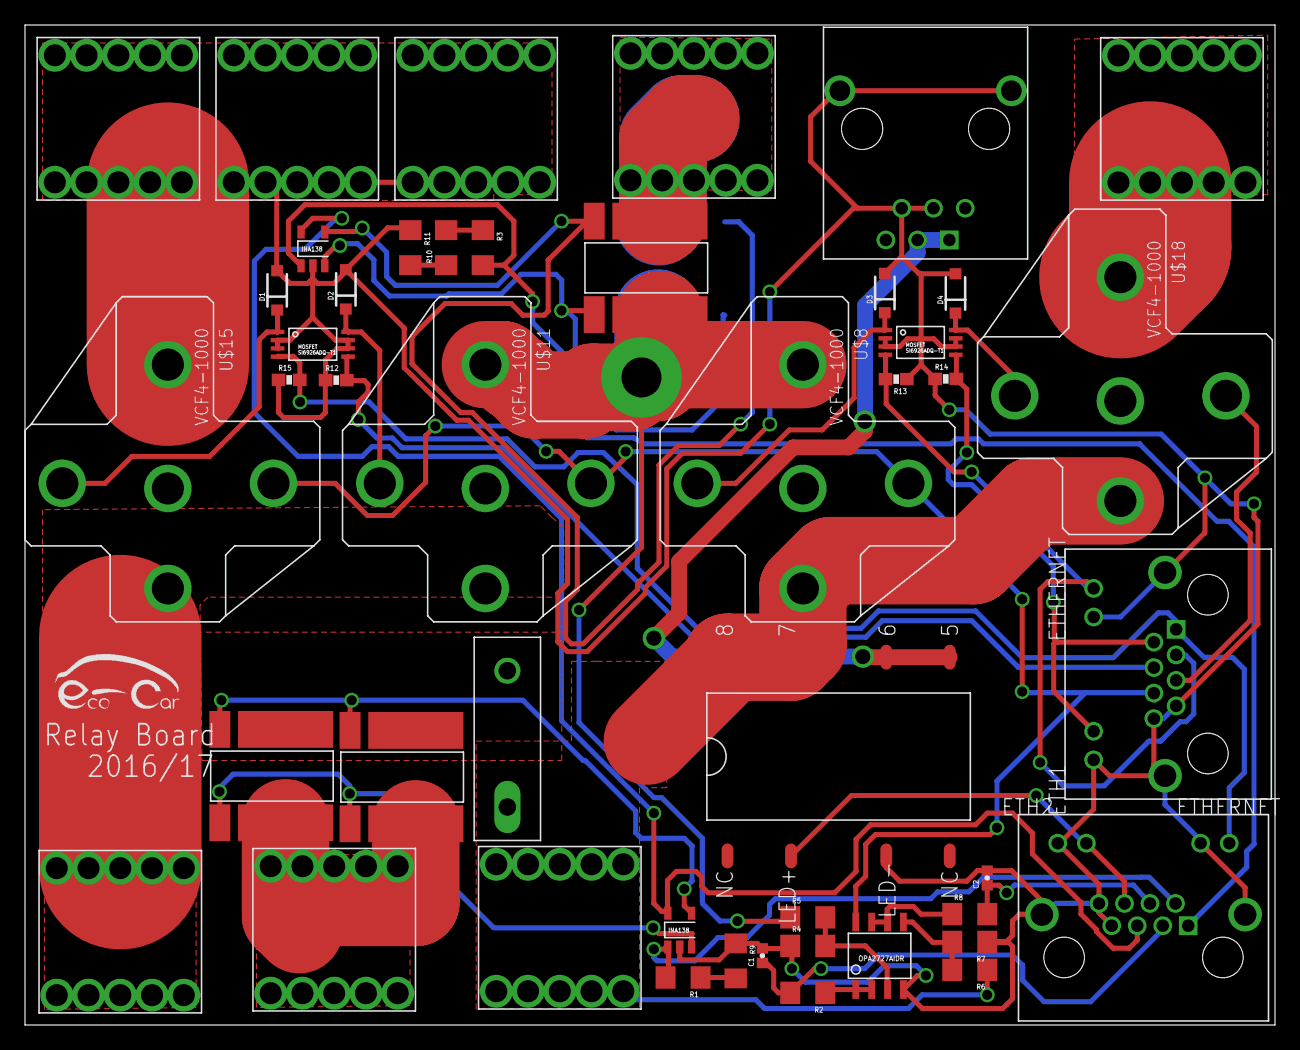
[picture p42: board Relay_Board.brd from above]

Board: 2 copper layers, 100.0 x 80.0 mm, 48 parts (1 on the bottom side), 36 nets.

Other parts of the board:
U$16: LOGO
