UAlberta-EcoCar/ARCHIVED-Fuel-Cell-Controller-2016-2017/Firmware/Controller/indicator_LED_mcu/Pin_Defines.h

#ifndef PIN_DEFINES_H
#define PIN_DEFINES_H

#include "Arduino.h"

#define LED1 A0
#define LED2 A1
#define LED3 A2
#define LED4 A3
//it turns out A6 and A7 are analog only pins
//#define LED5 A6
//#define LED6 A7
#define LED7 0
#define LED8 1
#define LED9 2
#define LED10 3
#define LED11 4
#define LED12 5



#endif
