UAlberta-EcoCar/ARCHIVED-Fuel-Cell-Controller-2016-2017/Firmware/Controller/MainController_ALICE/src/Charge_Thread.cpp

#include "mbed.h"
#include "rtos.h"
#include "FC_Status.h"
#include "Pin_Defines.h"
#include "analog_read_thread.h"
#include "Charge_Thread.h"
#include "digital_io.h"
#include "i2c_threads.h"

void charge_thread(void const *args)
{
  while(get_fc_status()!=CHARGE_STATE)
  {
    Thread::wait(500);
  }

  set_indicator_leds(1<<1);

  //close cap charge relay
  charge_relay(1);

  while(get_capvolt()<CHARGE_THRES_L)
  {
    Thread::wait(50);
  }

  charge_relay(0);
  Thread::wait(500);

  //close cap relay
  cap_relay(1);

  while(get_capvolt()<CHARGE_THRES_H)
  {
    Thread::wait(50);
  }

  Thread::wait(500);

  set_fc_status(RUN_STATE);
}
