UAlberta-EcoCar/ARCHIVED-Fuel-Cell-Controller-2016-2017/Firmware/Controller/Motor_Controller_mcu/commands.h

#ifndef COMMANDS_H
#define COMMANDS_H


#define SET_DUTY_CYCLE 0x01

#define DUTY_CYCLE_ZERO 0x00
#define DUTY_CYCLE_100 0x01
#define DUTY_CYCLE_200 0x02
#define DUTY_CYCLE_300 0x03
#define DUTY_CYCLE_400 0x04
#define DUTY_CYCLE_500 0x05
#define DUTY_CYCLE_600 0x06
#define DUTY_CYCLE_700 0x07
#define DUTY_CYCLE_800 0x08
#define DUTY_CYCLE_900 0x09
#define DUTY_CYCLE_1000 0x0a

#define EMERGENCY_STOP 0x02
#define EMERGENCY_STOP_RELEASE 0x03
#define START_SCRIPT 0x04
#define STOP_SCRIPT 0x05
#define RESTART_SCRIPT 0x06

#endif
