UAlberta-EcoCar/ARCHIVED-Fuel-Cell-Controller-2016-2017/Firmware/Controller/MainController_ALICE/src/FC_Status.cpp

#include "mbed.h"
#include "rtos.h"
#include "FC_Status.h"

int fc_status = 0;

Mutex status_lock;

void set_fc_status(int val)
{
  status_lock.lock();
  fc_status = val;
  status_lock.unlock();
}

int get_fc_status(void)
{
  status_lock.lock();
  int val = fc_status;
  status_lock.unlock();
  return(val);
}
