UAlberta-EcoCar/ARCHIVED-Fuel-Cell-Controller-2016-2017/Firmware/Controller/MainController_ALICE/src/multiplexor.h

#ifndef MULTIPLEXOR_H
#define MULTIPLEXOR_H

bool read_CVMSIG1(void);
bool read_CVMSIG2(void);
bool read_CVMSiG3(void);
bool read_CVMSIG4(void);

bool read_H2_OK(void);
bool read_EXTRA_SIG(void);
bool read_M_SIG_1(void);
bool read_M_SIG_2(void);

#endif
