UAlberta-EcoCar/ARCHIVED-Fuel-Cell-Controller-2016-2017/(commit log)

2016-11-10 mosfet board schematic done
    [mosfet-fin.brd, mosfet-fin.sch]
2016-11-14 updated fan controller
    [Fan__control_design.brd, Fan__control_design.sch, Relay_Board.sch, reegan-brd.brd, reegan-brd.sch]
2016-12-20 added power board
    [E-P-204-R3.4.brd, E-P-204-R3.4.sch, V1.sch]
2016-12-20 added rs 232 converter
    [Fuel Cell Controller V1.brd, Fuel Cell Controller V1.sch]
2016-12-21 fcc schematic mostly done
    [Fuel Cell Controller V1.brd, Fuel Cell Controller V1.sch, ecocar_CVM.brd, ecocar_CVM.sch, lcd_display_board.brd, lcd_display_board.sch]
2016-12-21 added connector for motor
    [Fuel Cell Controller V1.brd, Fuel Cell Controller V1.sch]
2016-12-27 added lots of pull down/up resistors and leds
2016-12-27 main board routed
    [Fuel Cell Controller V1.brd, Fuel Cell Controller V1.sch]
2016-12-28 added ground vias, making silk screen nice, starting documentation
    [Fuel Cell Controller V1.brd, Fuel Cell Controller V1.sch, Teensy Pinout.xlsx]
2017-01-04 updated caps on fcc rs232 driver
    [Fan_control_design v2.brd, Fuel Cell Controller V1.brd, Fuel Cell Controller V1.sch, ecocar_CVM.brd, ecocar_CVM.sch]
2017-01-04 undo delete cvm board
    [ecocar_CVM.brd, ecocar_CVM.sch]
2017-01-06 updated relay board
    [Relay_Board.brd, Relay_Board.sch]
2017-01-06 added gerbers
    [Fuel Cell Controller V1.brd, Fuel Cell Controller V1.sch]
2017-01-09 couple board revisions
    [Fuel Cell Controller V1.brd, Fuel Cell Controller V1.csv, Fuel Cell Controller V1.sch, Relay_Board.brd, Relay_Board.sch, Relay_Board_R2.brd, Relay_Board_R2.sch, ecocar_CVM.brd]
2017-01-09 cleaned up silk screens
    [Fan_control_design v2.brd, Fan_control_design v2.sch, Fuel Cell Controller V1.brd, Fuel Cell Controller V1.sch, hydrogen_sensors_board.brd, hydrogen_sensors_board.sch, lcd_display_board.brd, mosfet board.brd]
2017-01-11 boards that will be ordered
    [H-Bridge.brd, H-Bridge.sch]
2017-01-11 created v2 s of everything
    [Fan__control_design v1.2.brd, Fan__control_design v1.2.sch, Fan_control_design v1.3.brd, Fan_control_design v1.3.sch, Fuel Cell Controller V1.brd, Fuel Cell Controller V1.sch, Fuel Cell Controller V2.brd, Fuel Cell Controller V2.sch]
2017-01-14 part list for CVM board
    [Fuel Cell Controller V1.csv, ecocar_CVM_V2.csv]
2017-01-28 added some example code and libraries
    [E-P-204-R3.4.brd, E-P-204-R3.4.sch, Fan__control_design v1.2.brd, Fan__control_design v1.2.sch, Fan__control_design.brd, Fan__control_design.sch, Fan_control_design v1.3.brd, Fan_control_design v1.3.sch]
2017-01-28 some pin definitions
    [Fuel Cell Controller V2.sch]
2017-01-28 Added mikes board
    [motor_controller_sch.brd, motor_controller_sch.sch, motor_controller_schV2.brd, motor_controller_schV2.sch]
2017-01-28 Power Board
    [E-P-204-R3.brd, E-P-204-R3.sch]
2017-01-28 added a start up squence thread
2017-01-29 can read temp/humidity sensor
2017-01-29 turn sht31 functions into a thread
2017-01-29 bunch of i2c stuff done
2017-02-24 Current CVM code, compiles, liz's changes(made before I understood how to use git, now I do-ish)
2017-02-26 temp sensor, rtc, and status leds working on new controller
2017-02-28 shut down and error checking added
    [FC_Status.h, Shutdown_Thread.cpp, error_checking_thread.cpp, main.cpp, startup_thread.cpp]
2017-03-08 Changed Delay time and moved test files
    Changed delay time
    switched from classic delay to while (millis()... for greater
    accuracy.
    Moved test files
    Created a new file for the test code.
2017-03-19 updated fc power board
    [fc power board.brd, fc power board.sch]
2017-03-19 fc power board update
    [Parts List.xlsx, fc power board v2.brd, fc power board v2.sch, fc power board v3.brd, fc power board v3.sch]
2017-03-20 cleaned up fc power board silk screen
    [fc power board v3.brd, fc power board v3.sch]
2017-03-20 power board gerbers
2017-03-20 The test files for testing one I2C chip
2017-03-20 CVM code with working serial print and signal 1 and 2 functions
2017-03-26 voltage divider calculations for CVM Board
    [Voltage Dividers.xlsx]
2017-04-01 Attempted to Calibrate Voltage Readings
2017-04-04 working test code, shows values of each channel based on colour of the wire for ease of testing
2017-04-04 almost done just need to fix voltage adjustment
2017-04-10 calibrated fc current sensor and programed in some safe guards to prevent me from doing stupid things
    [Fan_control_design v2.sch, Parts List.xlsx, ThermTable.xlsx]
2017-04-13 edits to adjust for broken channels on adc's
2017-04-17 working code, accurate voltage readings
2017-04-21 more testing completed
    [Fuel Cell Controller V2.brd, ThermTable.xlsx]
2017-04-22 prototype works
2017-04-29 commit before switching to alice
2017-05-19 new independent mosfet board
    [mosfet board_v2.brd, mosfet board_v2.csv, mosfet board_v2.sch]
2017-10-07 got rid of redundant ground traces
    [hydrogen_sensors_board_v2.brd]
2017-10-07 removed more useless ground traces. Moved caps for xtal closer to the actual crystal
    [hydrogen_sensors_board_v2.brd]
2017-10-07 more general clean up. Moved LEDs to top layer. Removed some useless traces. Fixed warnings
    [hydrogen_sensors_board_v2.brd, hydrogen_sensors_board_v2.sch]
2017-10-08 added 3.3V LDO (chip and all digital signals are all 3.3V now). Added appropriate voltage divider for hydrogen sensor output (with optional cap)
    [hydrogen_sensors_board_v2.brd, hydrogen_sensors_board_v2.sch]
2018-02-10 FC power board updated
    updated board gerbers generated
    [fc power board v3.brd, fc power board v3.sch]
